CallMeRZIBI/Braille_typwriter_printer/maturity_exam/video_edit/print_result.jpeg

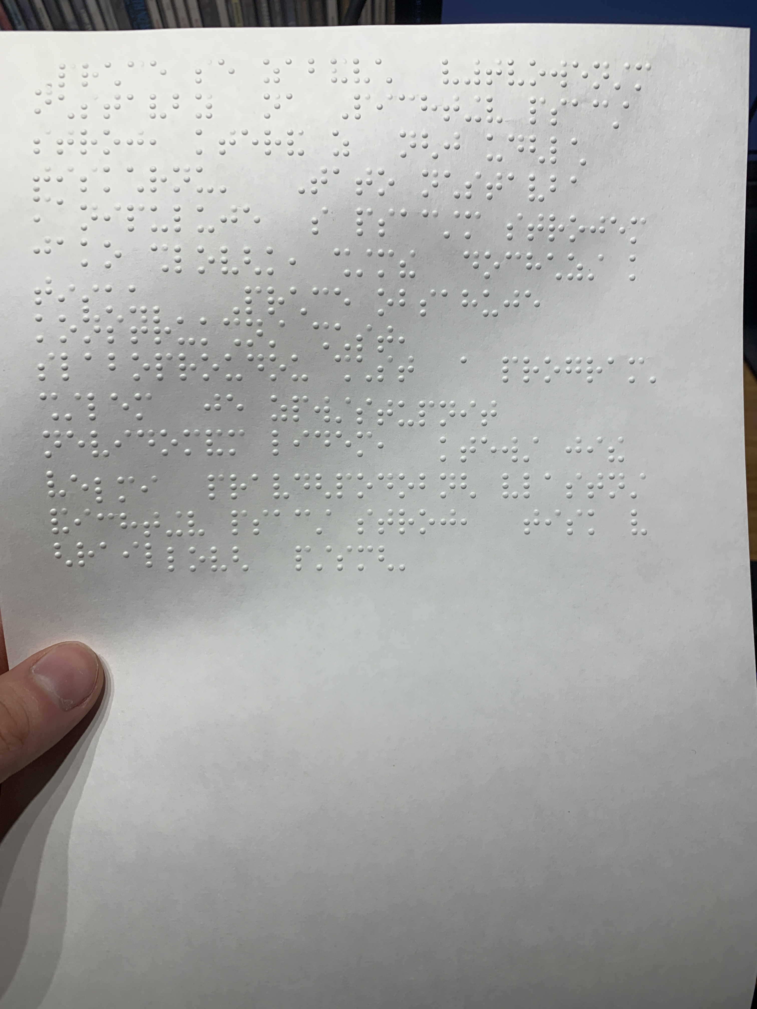
maturity_exam/video_edit/print_result.jpeg
