CallMeRZIBI/Braille_typwriter_printer/maturity_exam/navijak.jpg

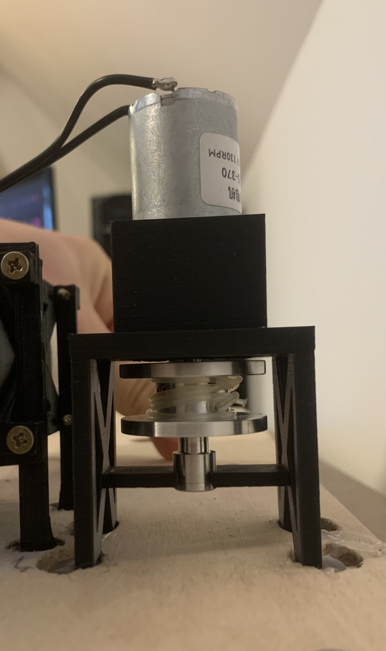
maturity_exam/navijak.jpg
