CallMeRZIBI/Braille_typwriter_printer/maturity_exam/MP2024-Michalenko-Jakub-E4C-Tiskárna_z_Braillova_psacího_stroje.pptx

## Tiskárna z Pichtova psacího stroje

Jakub Michalenko

## Obsah

- Proč jsem vytvořil tento projekt
- Popis krokového motoru
- Popis konstrukčního, hardwarového a softwarového řešení
- Poděkování

## Proč jsem tento projekt vytvořil?

- cenová nedostupnost Braillské tiskárny
- nevidomí lidé již vlastní Pichtův psací stroj
- nápad se zalíbil firmě NOVOTNÝ AUTOMATION s.r.o.
- nevidomý bratr

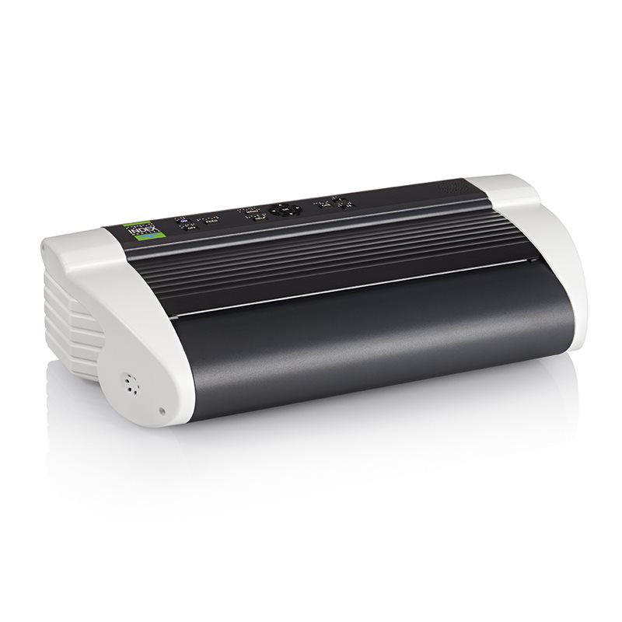
[picture p3: figure]
Basic-D V5 a light-weight embosser

INDEX Braille Basic-D V5 a light-weight embosser

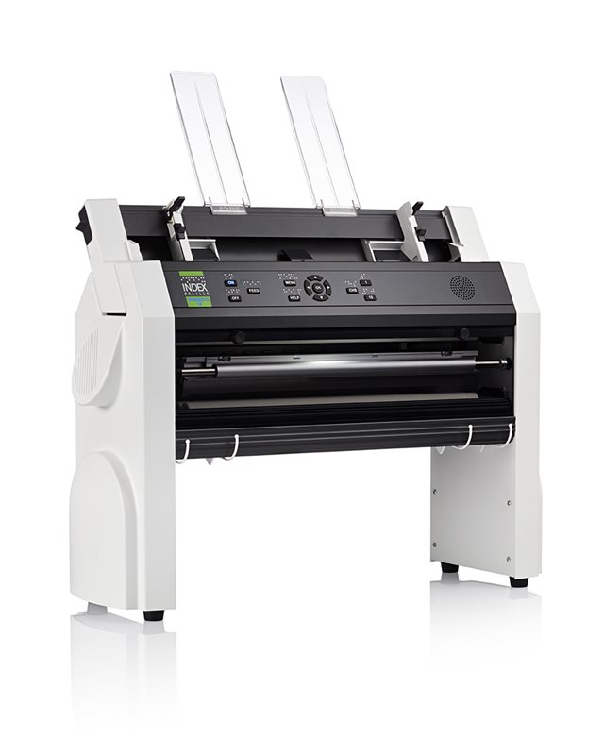
[picture p4: figure]
Everest-D V5: cut sheet-fed braille printer

INDEX Braille Everest-D V5: cut sheet-fed braille printer

## Popis krokového motoru

- elektrický motor otáčející se po krocích (stupních)
- přesné polohování
- 3D tiskárny, CNC, mikrovlnky, laserové projektory

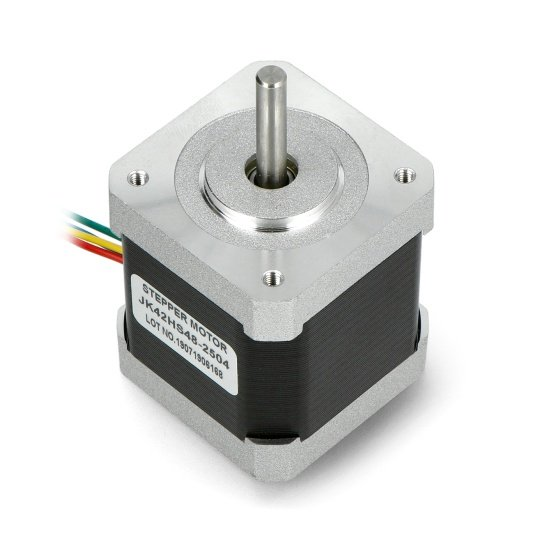
[picture p5: figure]
Krokový motor JK42HS48-2504 200 kroků / ot. 3,1 V Botland - obchod s robotikou

krokový motor Nema 17

## Popis krokového motoru (složení)

- složení: stator, dvě vinutí, rotor se zuby, permanentní magnet, …

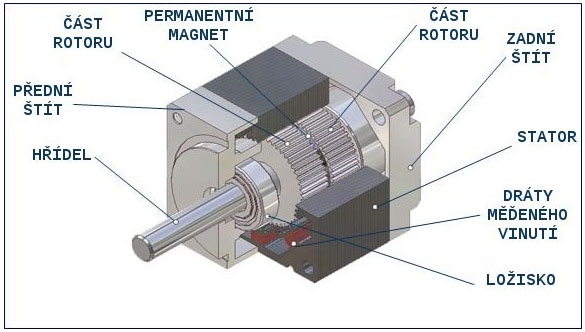
[picture p6: figure]
Krokový motor - co to je a jak funguje

složení krokového motoru

## Popis krokového motoru (princip)

- dvě vinutí jsou napájeny ssm U
- po převrácení napájecího U v jednom vinutí se rotor posune o 1 krok
- tímto opakováním se rotor postupně otáčí
- nutnost driveru
- přesné ovládání polohy

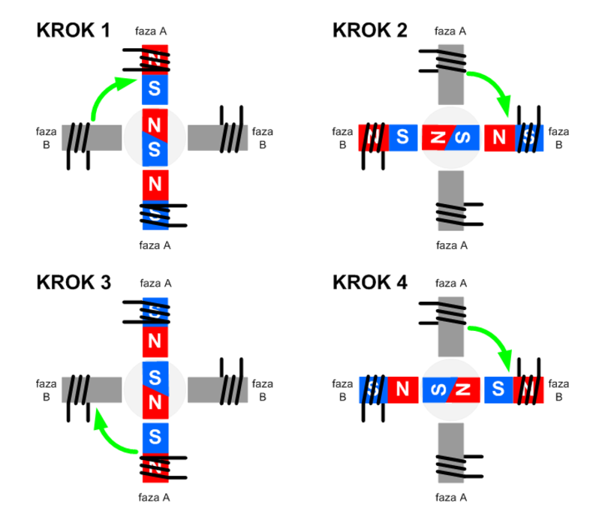
[picture p7: figure]
Krokový motor – druhy a příklady aplikací krokových motorů | Elektronické díly. Distributor a obchod online - Transfer Multisort Elektronik

princip činnosti krokového motoru

## Popis krokového motoru (driver)

- řídí krokový motor
- proudová ochrana, tepelná ochrana, energetická úspora
- více módů: full-step, half-step, microstep
- full-step: přepíná napájení vinutí
- half-step: střídá na vinutí kladné, žádné a záporné napájení
- microstep: řídí množství proudu odesílaného do jednotlivých vinutí, tím to je sofistikovanější

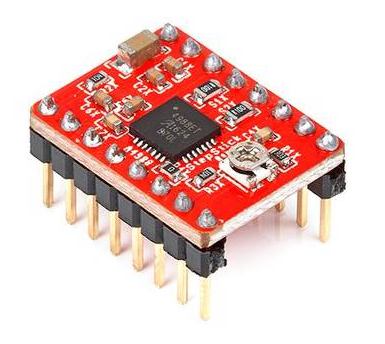
[picture p8: figure]
Motor driver A4988 Pro Reprap 3D Tiskárny - červený | dratek.cz

driver A4988
