CallMeRZIBI/Braille_typwriter_printer/maturity_exam/SOČ-2024-E4C-Michalenko-Jakub.pdf

## STŘEDOŠKOLSKÁ ODBORNÁ ČINNOST

Obor č. 10: Elektrotechnika, elektronika a telekomunikace

## Tiskárna z Pichtova psacího stroje

### Jakub Michalenko

Liberecký kraj | Liberec 2024

## STŘEDOŠKOLSKÁ ODBORNÁ ČINNOST

Obor č. 10: Elektrotechnika, elektronika a telekomunikace

## Tiskárna z Pichtova psacího stroje

## Printer from Picht's typewriter

### Autoři: Jakub Michalenko

Škola: Střední průmyslová škola a Vyšší odborná škola,

### Liberec, příspěvková organizace, Masarykova 3, 460 01 Liberec 1 Kraj: Liberecký kraj

Konzultant: Ing. David Krčmařík, Ph.D.

Město a vročení

Tiskárna z Pichtova psacího stroje

## Prohlášení

Prohlašuji, že jsem svou práci SOČ vypracoval/a samostatně a použil/a jsem pouze prameny a literaturu uvedené v seznamu bibliografických záznamů.
Prohlašuji, že tištěná verze a elektronická verze soutěžní práce SOČ jsou shodné. Nemám závažný důvod proti zpřístupňování této práce v souladu se zákonem č. 121/2000 Sb., o právu autorském, o právech souvisejících s právem autorským a o změně některých zákonů (autorský zákon) ve znění pozdějších předpisů.
V Liberci dne 15. 3. 2024 |
Jakub Michalenko

## Anotace

Práce se zabývá vytvořením nástavby na Pichtův psací stroj, který z něj udělá tiskárnu. Tato nástavba manipuluje s psacím strojem jako člověk, čímž dochází k tisku. Práce obsahuje konstrukční část, slaboproudou část a program. Cílem je zpřístupnit nevidomým lidem, kteří již velmi pravděpodobně vlastní Pichtův psací stroj, tisk v Braillově písmě.

## Summary

This work deals with making of addon for Picht’s typewriter, which transforms it to printer. This addon works with typewriter like a human, and by that it creates the print. This work contains construction part, weak-current part and a program. The objective is to make Braille printing more accessible to blind people, who by high chance already own Picht’s typewriter.

## Čestné prohlášení

Prohlašuji, že jsem předkládanou odbornou práci vypracoval sám a uvedl jsem veškerou použitou literaturu a bibliografické citace.

V Liberci dne 14.03.2024 | | Jakub Michalenko

## Obsah

A. Seznam přiložených souborů | I

## Úvod

Práce se zabývá nástavbou na Pichtův psací stroj, která ho promění v tiskárnu. K tomuto tématu jsem se dostal přes svého nevidomého bratra. Problémem Braillských tiskáren je jejich vysoká cena, tak jsem vytvořil tuto nástavbu, která je oproti Braillské tiskárně mnohem méně finančně nákladná. Nástavba je vytvořena pro Pichtův psací stroj Tatrapoint Adaptive, ale je možné ji použít i na dalších modelech Tatrapoint.
Teoretická část se zabývá braillským písmem a Pichtovým psacím strojem, mikrokontrolery a jejich architekturou, DC motory, krokovými motory a jejich ovládáním a push solenoidy.
Praktická část obsahuje konstrukční řešení mé nástavby, slaboproudou část a kód pro Arduino Uno a počítač, který to vše ovládá.
Když jsem se jednou o tomto nápadu bavil s ředitelem firmy NOVOTNÝ AUTOMATION s.r.o., tak se mě zeptal, zda bych nechtěl tento projekt vypracovat pro něj, a já tu nabídku přijal.

1 | Seznámení s Braillovým psacím strojem
| Braillův psací stroj neboli Pichtův psací stroj je mechanické zařízení pro zápis
Braillova písma na papír určený pro nevidomé.
1.1 | Historie Braillova psacího stroje
| První psací stroj pro nevidomé byl vynalezl v roce 1892 Frank Haven Hall, který
pracoval ve škole pro nevidomé v Illinois. Tento vynález nechránil patentem, jelikož na něm nechtěl vydělat. (1)
| V roce 1901 si zaregistroval svůj patent Oskar Picht, podle které se občas v česku
používá název „Pichtův psací stroj“. Oskar Picht je v Evropě často označován za prvního vynálezce psacího stroje pro nevidomé. (1)
1.2 | Konstrukce Pichtova psacího stroje
| Konstrukce Pichtova psacího stroje je podobná konstrukci klasického psacího
stroje. Skládá se z klávesnice, mechanické části na vytlačení důlků do papíru, válec na posouvání papíru na další řádek a posuvný vozík pro horizontální posun papíru. Oproti klasickému psacímu stroji ale klávesnice obsahuje pouze 7 kláves, 6 kláves tvoří šestibod Braillova písma, jejichž kombinací se píšou písmena a sedmá klávesa je mezerník.
| Horizontálně se posuvný vozík posouvá automaticky po úderu na jakoukoliv
klávesu, což zajišťuje buben se strunou, který obsahuje pružinu a automaticky se namotává. Pro návrat na předchozí znak obsahuje psací stroj ještě jedu páčku.
| Z těchto částí se ale operují pouze klávesnice, horizontální a vertikální posun
papíru. Tím pádem nemusím nijak operovat mechanismus na vytlačení důlků do papíru, jelikož to je přímo mechanicky propojené s klávesnicí.

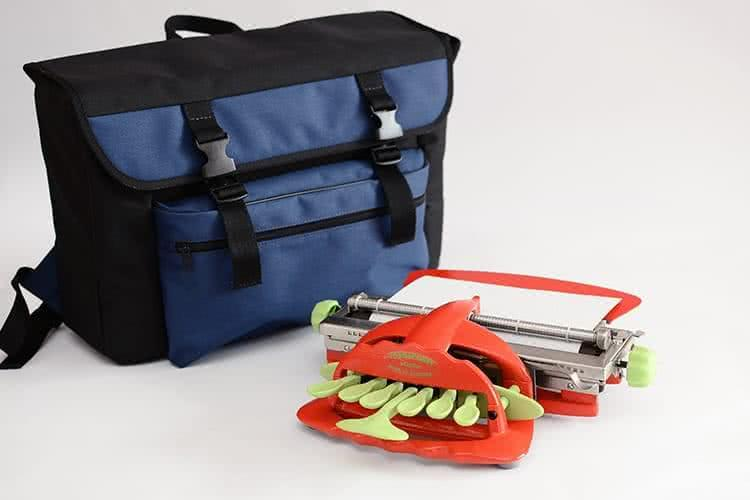
[picture p13: figure]

Obrázek 1 Pichtův psací stroj - Tatrapoint Adaptive

## 1.2.1 Části Pichtova psacího stroju operované nástavbou

1. klávesnice
2. vertikální posun papíru
3. horizontální posun papíru

2 | Braillovo písmo
| Braillovo písmo je speciální druh písma vytvořený pro nevidomé. Oproti ostatním
druhům písma se nejedná o písmo čitelné pomocí zraku, tudíž nic nenanáší barvu na papír, ale o vytlačené důlky do papíru, které člověk čte pomocí hmatu.
| Písmo je pojmenováno podle francouzského učitele Louise Brailla, který v dětství
přišel o zrak. Písmo vytvořil v patnácti letech úpravou francouzského vojenského systému umožňujícího čtení za tmy. (2)

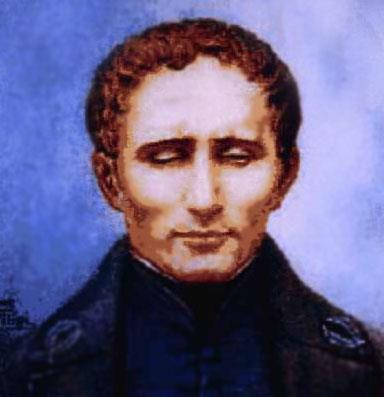
[picture p14: figure]

Obrázek 2 Louis Braille (3)
2.1 | Stavba písma
| Braillovo písmo je tvořeno šesti body ve dvou sloupcích po třech. Na jednotlivé
body se odkazuje čísly od 1 do 6, kde 1 je v levém horním rohu písmena a přičítá se ve sloupci směrem dolů do 3, v pravém horním rohu je 4 a přičítá se zase směrem dolů do 6.

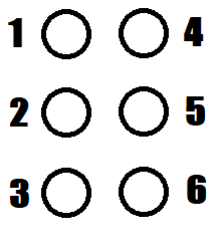
[picture p15: figure]

Obrázek 3 číslování Braillova písma

Písmeno se skládá z kombinace důlků a vynechaných bodů, tím pádem je možné s mezerou zakódovat 64 znaků (6²). Těchto 64 znaků pokrývá celou abecedu a některé speciální znaky jako interpunkce. Čísla se píšou jako prvních 10 znaků abecedy předznamenaných speciálním znakem, to samé platí pro velká písmena, která jsou předznamenána pouze bodem 6. Každý jazyk má vlastní zakódování abecedy.

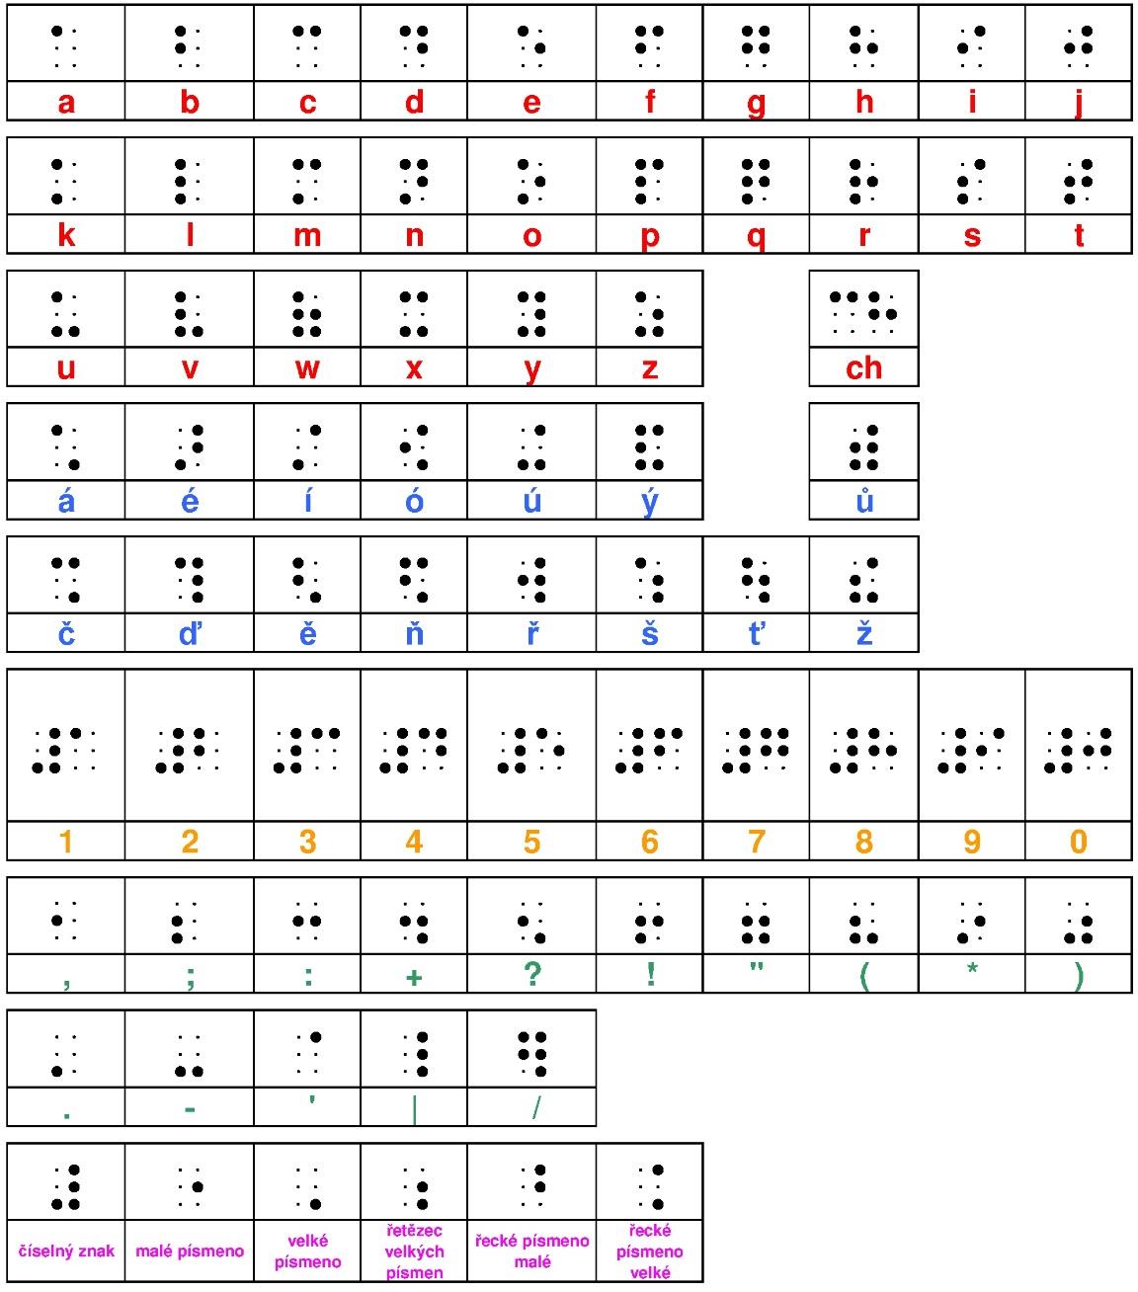
[picture p16: figure]

Obrázek 4 česká Braillská abeceda (4)

3 | DC motor
| Stejnosměrný (DC) motor je v elektrotechnice točivý elektrický stroj na
stejnosměrný proud, s vnitřní komutací cívek v rotoru. Může pracovat v režimu elektromotor nebo generátor (dynamo). Princip stejnosměrného motoru objevil v roce 1873 Zénobe Gramme. Stejnosměrné motory se dělí do více skupin, na kartáčové a bezkartáčové a dále podle typu buzení, na motory s cizím buzením, motory se sériovým buzením a derivační motory. (5)
| Malé stejnosměrné motory jsou používány v hračkách a pohonech spotřebičů.
Díky jejich rozšíření jsou cenově velmi přístupné, je jich velké množství a dělají se ve všech možných rozměrech a s různými parametry. Díky tomu jsou velmi používané nejen v profesionálních strojích ale využívají je i kutilové. Někdy se prodávají s přimontovanou převodovkou pro dosažení větších otáček nebo většího kroutícího momentu.
3.1 | Stavba stejnosměrného motoru
| Stejnosměrný motor má čtyři hlavní díly, společný magnetický obvod statoru a
rotoru, buzení magnetického toku statoru, komutátor s kartáči a rotor. Napájení rotoru je realizováno přes sběrací kartáče na komutátoru, který přepíná vinutí rotoru. Na statoru je budicí vinutí, které vytváří magnetický tok. Budicí vinutí je nahrazováno u nových konstrukcí permanentním magnetem. Změnou velikosti budicího proudu nebo napájecího napětí kotvy je možno řídit rychlosti otáčení (ot/min). Změnou směru jen budicího proudu nebo jen napětím kotvy docílíme změnu směru otáčení kotvy. (5)

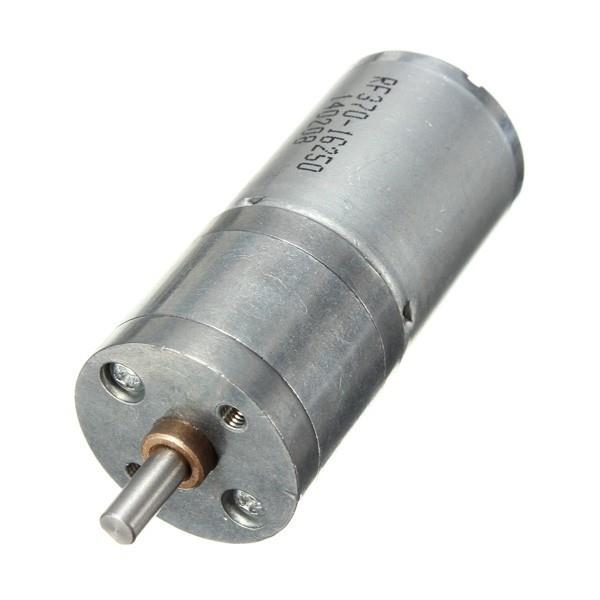
[picture p17: figure]

Obrázek 5 příklad DC motoru s převodovkou na kroutící moment (6)

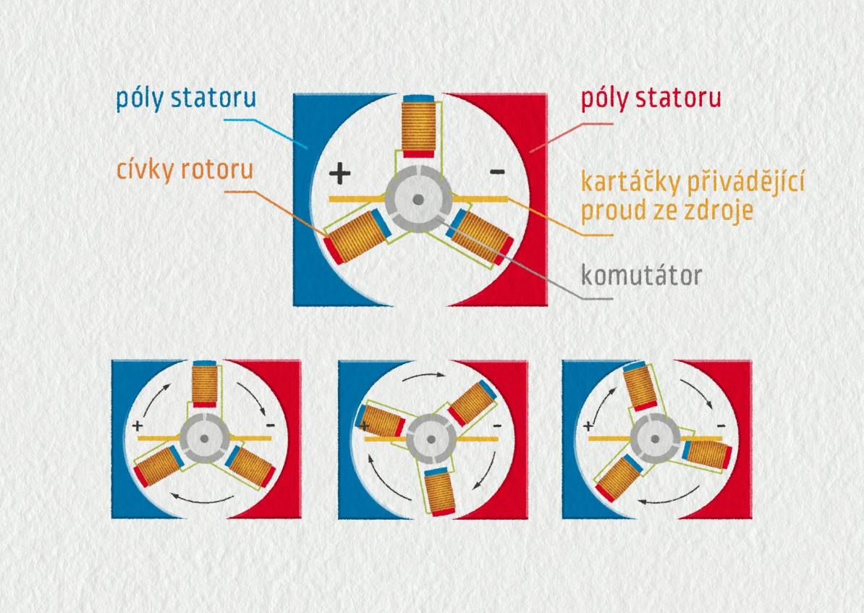
[picture p18: figure]

Obrázek 6 stavba stejnosměrného motoru (7)
3.2 | Princip činnosti stejnosměrného motoru
| Stejnosměrný motor se skládá z rotoru (upevněn na hřídeli) a statoru (pevná část
elektromotoru). Rotor je vždy elektromagnet, stator může být buď elektromagnet nebo permanentní magnet. Kotvou je označován elektromagnet, na kterém dochází k přepólování napájení jeho vinutí (buď pomocí komutátoru nebo řídícím elektronickým obvodem). Kotva může být na statoru i na rotoru (podle konstrukce motoru). (5)
| Magnetický tok budicího vinutí a kotvy na sebe silově působí. Stejné póly se
odpuzují a opačné přitahují. Tím vzniká točivý moment. Pokud by při pootočení nedošlo k přepnutí vinutí kotvy (komutaci), došlo by k zastavení. Vektory spřaženého magnetického toku by nevyvozovaly vzájemné silové účinky (magnetická pole by byla orientována ve stejném směru). Pro zachování dosavadního směru otáčení je kotva přepólována tak, aby se rotor snažil pootočit směrem do další neutrální polohy, ale mezi tím dojde opět k další komutaci části vinutí kotvy. Pro plynulejší pohyb má kotva tři a více vinutí. Změnu směru otáčení motoru je možno uskutečnit reverzací (přepólováním) jen kotvy, nebo jen buzení. Pro rychlou reverzaci motoru je obvykle reverzována kotva, která má mnohem menší časovou konstantu než budicí obvod. (5)
| Protékající proud v součinnosti s magnetickým polem vytváří sílu podle vztahu
F = B ∗ I ∗ l, která otáčí rotorem.

3.3 | Typy stejnosměrných motorů
| Základní typy DC elektromotorů jsou kartáčové a bezkartáčové DC
elektromotory, dále se dělí podle způsobu buzení.

## 3.3.1 Kartáčový stejnosměrný elektromotor

| Kartáčový motor má na hřídeli rotor a zároveň kotvu, v jejichž drážkách je
vloženo vinutí rotoru připojené na komutátor. Komutátor je soustava vzájemně elektricky oddělených vodivých kovových lamel upevněných na hřídeli rotoru. Na komutátor přiléhají uhlíky (kartáče), kterými je přiveden do rotoru elektrický proud. Komutátor s uhlíky zajišťují přepínání částí vinutí rotoru. Během provozu dochází k opotřebovávání uhlíků otěrem o lamely a jiskřením při přepínání napájení pro jednotlivé části vinutí. Komutátor je nejporuchovější součástí stejnosměrného kartáčového motoru a vyžaduje pravidelnou údržbu. (5)
| Stator kartáčového motoru obsahuje budicí obvod, který je tvořen
permanentními magnety nebo cívkami budicího vinutí. (5)
| Vektor magnetického toku buzení (statoru) je pootočen o 90° vůči vektoru
magnetického toku kotvy. Oba magnetické toky jsou spřaženy ve společném magnetickém obvodu. Tím dochází k silovému působení mezi magnetickými toky cívek a vzájemným silovým působením vzniká kroutící moment. (https://cs.wikipedia.org/wiki/To%C4%8Div%C3%BD_moment) (5)
| Změna rychlosti otáčení a kroutícího momentu je prováděna změnou velikosti
přivedeného elektrického napětí na kotvu a změnou budicího proudu. (5)

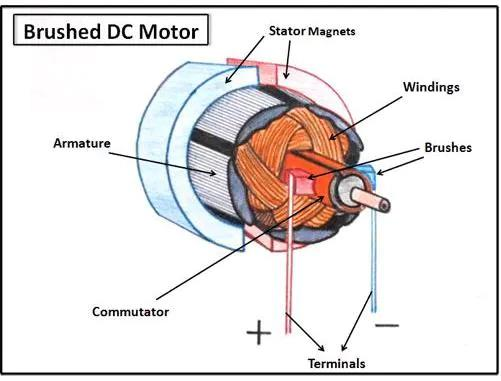
[picture p19: figure]

Obrázek 7 stavba kartáčového stejnosměrného motoru (8)

## 3.3.2 Bezkartáčový stejnosměrný elektromotor

Bezkartáčový motor má rotor tvořen permanentními magnety. Vinutí cívek statoru je zapínáno řídicí elektronikou tak, aby byl neustále vyvoláván točivý moment na rotoru. Řídící jednotka musí sledovat pozici rotoru, například pomocí Hallových sond, aby správně přepojovala vinutí statoru. Změna otáček je prováděna změnou frekvence přepínání cívek ve statoru. Řídicí jednotka může regulovat napětí a proud do cívek statoru, čímž může ovlivňovat krouticí moment. Tím, že není použit komutátor, je bezkartáčový motor nenáročný na údržbu. Jsou označovány někdy jako BLDC. Příkladem bezkartáčového motoru je motor ventilátoru chlazení PC. (5)

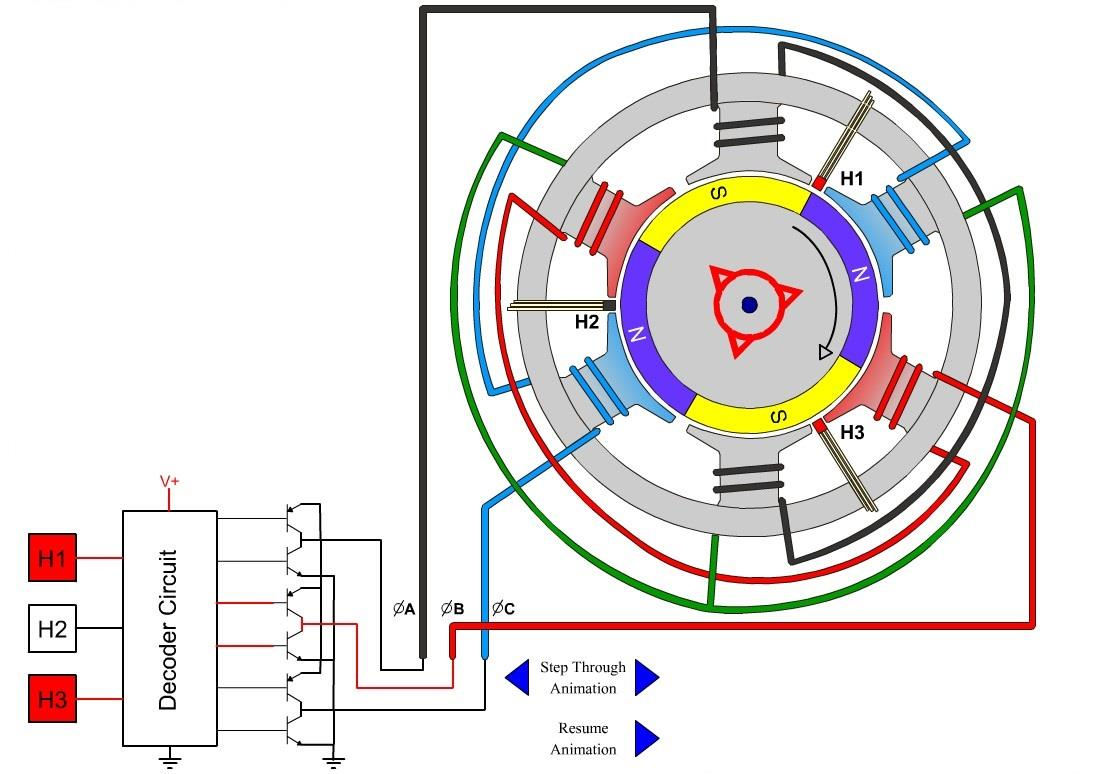
[picture p20: figure]

Obrázek 8 diagram BLDC motoru s ovládáním (9)
3.4 | Buzení stejnosměrných motorů
| První komutátorové motory měly výhradně statorové budicí vinutí. U nových
konstrukcí bývá nahrazováno permanentním magnetem. Odbuzením (snížením budicího proudu) vinutí statoru umožňuje u komutátorového motoru zvýšení rychlosti otáčení. Současně klesá krouticí moment. (5)
| Komutátorové motory používají čtyři typy elektrického propojení buzení a kotvy:
sériové, derivační (paralelní), kompaundní (kombinace obou) a cizí buzení. Každý má jinou charakteristiku točivého momentu vůči otáčkám motoru pro různé zátěže. (5)

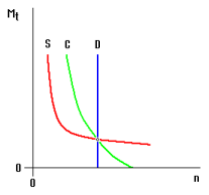
[picture p21: figure]

Obrázek 9 Charakteristiky buzení stejnosměrných motorů (5)

Na zobrazeném grafu jsou zobrazeny idealizované momentové charakteristiky motorů v závislosti na otáčkách [S] - sériový, [D] - derivační, [C] - kompaundní. Grafy platí jen v pracovní oblasti motorů. (5)

## 3.4.1 Cizí buzení

Cize buzený motor má kotvu (rotor) i statorové buzení napájeny z různých nezávislých zdrojů, které mohou být řiditelné. Pro zavedení elektrodynamické brzdy stačí jednoduché zapojení obvodů. Tento motor nepotřebuje zeslabování budicího vinutí (buzení má vlastní regulaci). Využíval se po rozvoji výkonové elektroniky (pulzní měniče). (5)

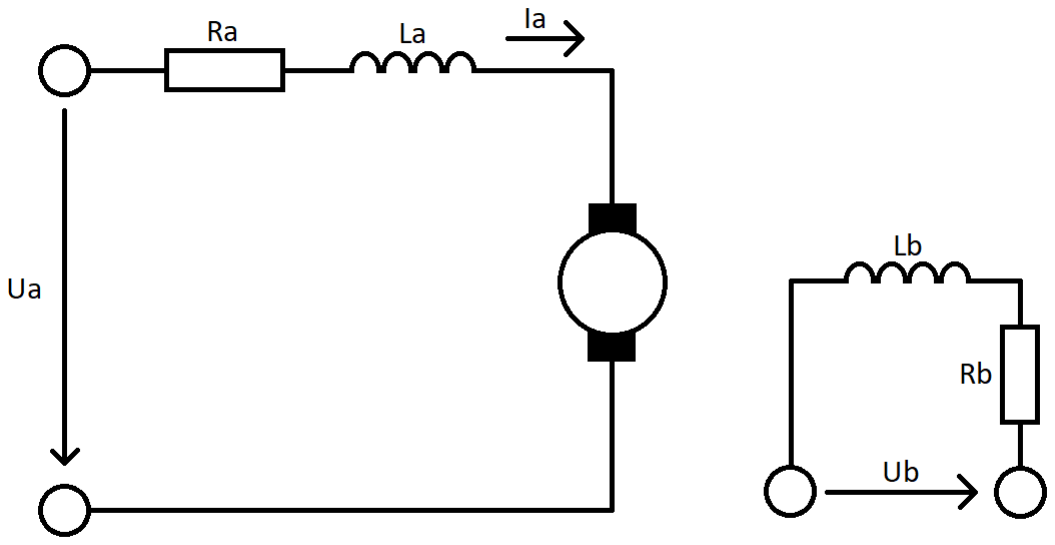
[picture p22: figure]

Obrázek 10 zapojení stejnosměrného motoru s cizím buzením

## 3.4.2 Sériové buzení

Statorové budicí vinutí je spojeno do série s vinutím rotoru. Dopravní prostředky závislé i nezávislé trakce (vlaky, metro, tramvaje, ...) vyžadují pohon motory s velký záběrovým momentem. Tomu nejlépe vyhovoval motor se sériovým buzením. Mluvíme o sériovém elektromotoru. Točivý moment motoru je nepřímo úměrný otáčkám. Při nulových otáčkách dosahuje motor maximálních hodnot kroutícího momentu. (5) Motory se sériovým buzením nemají omezení rychlosti otáčení. Při běhu naprázdno se motor může roztočit do vysokých otáček, kdy hrozí mechanické roztržení rotoru s možným zraněním obsluhy. (5)

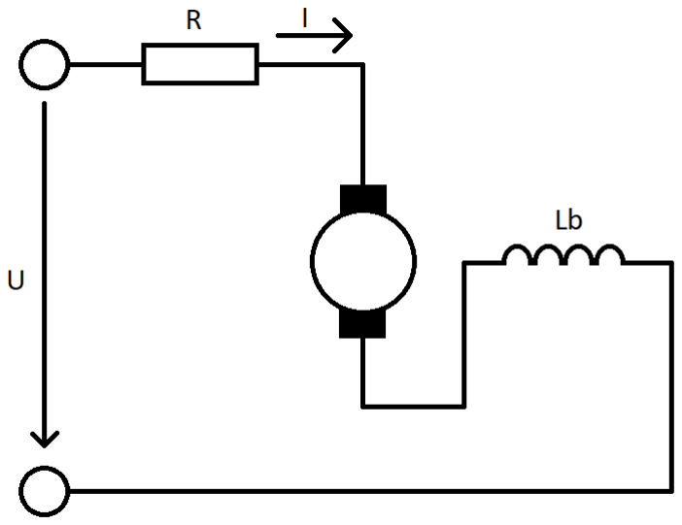
[picture p23: figure]

Obrázek 11 zapojení stejnosměrného motoru se sériovým buzením

## 3.4.3 Derivační zapojení buzení

Derivační motor je komutátorový motor, jehož budicí vinutí i kotva je napájeno ze společného zdroje (zapojeno paralelně). Jedná se v podstatě o obdobu cize buzeného motoru. Otáčky v motoru v pracovní oblasti jsou málo závislé na zátěži motoru. Derivační motor je využíván u poháněných zařízení s požadavkem malých změn otáček. Proud statoru i buzení je možno samostatně regulovat. Derivační motor přechází samočinně z motorického režimu do režimu generátoru a zpět v závislosti na mechanické charakteristice poháněného zařízení. (5)
Derivační motor se může při přerušení budicího obvodu přetočit, hrozí mechanické poškození rotoru, až zranění obsluhy. (5)

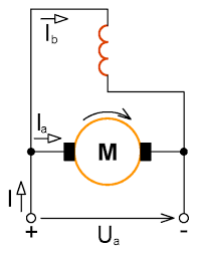
[picture p24: figure]

Obrázek 12 zapojení derivačního motoru (10)

Motor je možno jen odbuzovat a omezovat proud kotvy. Momentová charakteristika je velmi podobná jako u motoru s cizím buzením. Spouštění motoru: před zapnutím motoru musí být nastaven maximální budicí proud, tedy zkratován rezistor Rb a zařazen celý odpor rezistoru RS. (5)

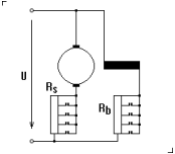
[picture p25: figure]

Obrázek 13 zapojení derivačního motoru 2 (5)

## 3.4.4 Kompaundní zapojení buzení

Kompaundní motor neboli elektromotor se smíšeným buzením má sériové i paralelní budicí vinutí, jejichž magnetické toky působí buď souhlasně, nebo proti sobě. Podle toho, která část budicího vinutí (sériová nebo derivační) má převládající vliv na budicí tok, se mění pracovní charakteristiky kompaundního motoru. Výstupní charakteristiky jsou kompromisem derivačního a sériového motoru. Působí-li obě vinutí stejným směrem, má motor větší záběrný moment než motor s paralelním buzením a otáčky se nesnižují tolik, jako u motoru se sériovým buzením. Působí-li sériové vinutí proti paralelnímu, udržuje motor otáčky při proměnném zatížení. Zvětší-li se zatížení, otáčky klesnou, sériovým vinutím prochází větší proud, buzení se zeslabí a otáčky se opět zvýší. (5)
Spouštění motoru: Před zapnutím motoru musí být nastaven maximální budicí proud, tedy zkratován rezistor Rb a zařazen celý odpor rezistoru Rs. Po vyřazení odporu v obvodu kotvy se snižuje buzení odporem v obvodu buzení. (5)

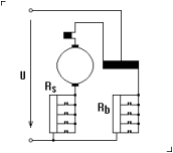
[picture p26: figure]

Obrázek 14 zapojení kompaundního motoru (5)

4 | Krokový motor
| Krokový motor je elektrický motor, který se oproti ostatním elektrickým
motorům otáčí po krocích. Každý krok je stejně velký, a tak se jedná o rotaci po stupních.
| Využívá se díky jeho principu tam, kde je potřeba vysoká přesnost motoru, to jsou
např.: 3D tiskárny, CNC stroje.

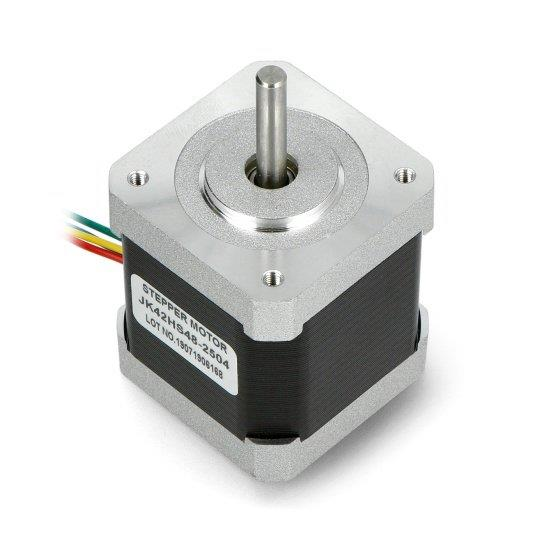
[picture p27: figure]

Obrázek 15 krokový motor (11)
4.1 | Princip činnosti krokového motoru
| Krokové motory se skládají ze dvou vinutí, které jsou napájeny stejnosměrným
proudem. Když je proud v jednom vinutí obrácen, hřídel rotoru se posune o jeden krok. Převrácením proudu v každém vinutí je poloha a rychlost motoru snadno a přesně řízena. (12)

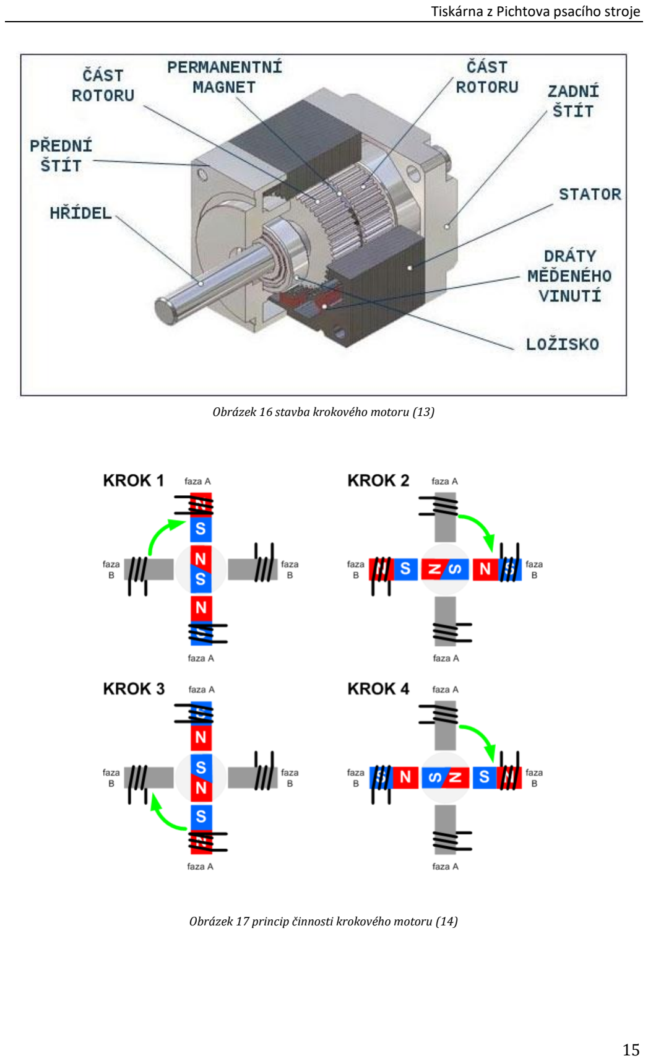
[picture p28: page 23]

Obrázek 16 stavba krokového motoru (13)

Obrázek 17 princip činnosti krokového motoru (14)

4.2 | Parametry krokového motoru
| Krokové motory se vybírají podle jejich přídržného krouticího momentu a
odpovídajícího jmenovitého proudu a napětí. Přídržný moment určuje maximální externí krouticí moment aplikovaný na motor (napájený jmenovitým proudem) ve statické poloze bez otáčení. V okamžiku, kdy se motor začne otáčet, se dostupný točivý moment často označuje jako moment zvratu, který udává mezní hodnotu momentu při stabilním a konstantním chodu motoru bez ztráty kroku. Velikost momentu zvratu je reprezentována hodnotami vynesenými na křivkách krouticího momentu v závislosti na otáčkách motoru. (12)
| Úhel kroku je další parametr. Nejčastěji je to 1,8° na krok, jelikož konstrukce

motoru má 200 zubů. Počet kroků se vypočítá takto: n =

360
α

kde je n – počet kroků, α –

úhel kroku. (12)
4.3 | Řízení krokového motoru
| Krokové motory se řídí pomocí řídicích jednotek, které přepínají vinutí
krokového motoru. Jsou k dispozici v široké škále napětí a proudů. Výkon motoru velmi závisí na proudu a napětí dodávaném řídicí jednotkou. Řídicí jednotka může operovat krokový motor ve třech režimech, a to full-step, half-step a microstep. (12)
| Full-step se provede vždy, když se přepne napájené vinutí. (12) Half-step se docílí spínací technikou, která střídavě aplikuje kladný, žádný a

záporný proud na každé vinutí v patřičném sledu. (12)
| Microstep je sofistikovanější forma řízení, která je nad rámec jednoduchého
přepínání výkonu mezi vinutími fází a řídí množství proudu odesílaného do jednotlivých vinutí. Hlavní výhodou mikrokrokování je snížení amplitudy rezonance, ke které dochází, když motor pracuje na své vlastní frekvenci. Mikrokrokování umožňuje umístění hřídele na jiných místech než v místech poskytovaných full-step režimem a half-step režimem. (12)

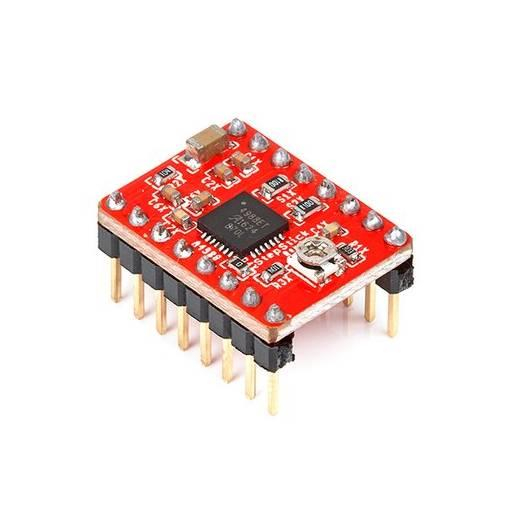
[picture p29: figure]

Obrázek 18 řídicí jednotka A4988 pro krokové motory (15)

5 | Lineární Solenoidy
| lineární solenoidy jsou lineární elektrické stroje, nejčastěji používané tam, kde je
potřeba velké rychlosti pohybu malé váhy po krátké až středně dlouhé dráze. Jsou často používané díky jejich jednoduchosti, spolehlivosti a velikosti. Jedná se o elektromagnet s pohyblivým jádrem.
5.1 | Konstrukce Lineárních Solenoidů
| Konstrukce je velice jednoduchá, jelikož se jedná o cívku v pouzdře, s pohyblivým
jádrem uprostřed. Jádro je podle potřeby opatřeno návratnou pružinou. Není tomu tak v aplikacích kde ovládaná část sama vrátí jádro, nebo pokud jádro přitáhne gravitace nebo jiná síla.

## 5.2 Druhy lineárních solenoidů

1. Push Pull Solenoidy
1. Tubulární Solenoidy
2. Open Frame Solenoidy
2. Proporcionální Solenoidy
3. Super Stroke Solenoidy
4. Latching Solenoidy

## 5.2.1 Push Pull Solenoidy

| Push pull solenoid se dá díky jeho jednoduché konstrukci použít buď jako push
solenoid, nebo jako pull solenoid, nebo obojí. Záleží pouze na orientaci instalace.
| Navzdory tomu, že by se daly solenoidy používat zároveň jako push i jako pull,
tak se často vyrábí s jádrem přizpůsobeným pouze k jednomu druhu pohybu.

5.2.1.1 Tubulární Solenoidy

| Tubulární solenoidy jsou prakticky pouze push pull solenoidy s pouzdrem tvaru
válce.

5.2.1.2 Open Frame Solenoidy

| Open frame solenoidy jsou taktéž push pull solenoidy, ale jejich pouzdro je z dvou
stran otevřený kvádr, tudíž cívka je izolovaná.

## 5.2.2 Proporcionální Solenoidy

Proporcionální solenoidy jsou lineární solenoidy, jejichž síla je úměrná proudu. S přidáním pružiny se může proporcionální solenoid používat jako polohovací zařízení, kde je poloha úměrná proudu. (16)

## 5.2.3 Super Stroke Solenoidy

Super stroke solenoidy jsou tubulární solenoidy, které mají větší délku zdvihu. Dají se zároveň používat jako proporcionální solenoidy. (17)

## 5.2.4 Latching Solenoidy

Latching Solenoidy jsou solenoidy, u kterých k držení jádra v aktivní poloze není třeba napájení. K dosažení aktivní polohy stačí velmi krátký pulz, tím pádem jsou energeticky úspornější. K návratu je třeba také pulz opačné polarity. (18)
Hodí se do aplikací, kde je požadavek solenoidu, aby byl sepnutý po delší dobu, což u klasického lineárního solenoidu není možné, jelikož by se začal velmi rychle přehřívat. (18)

5.2.4.1 Princip Latching Solenoidu

Latching solenoid obsahuje oproti klasickému lineárnímu solenoidu také permanentní magnet vedle cívky. Ten drží pohyblivé jádro na místě, dokud se nepřipojí napájení cívky, která buď přitáhne jádro, nebo vynuluje magnetické působení permanentního magnetu a vnější jev vrátí jádro do původní polohy. To je možné zase buď pružinou anebo samotnou aplikací.
Na obr. 19 je vidět vlevo latching solenoid ve vysunuté poloze a vpravo v zasunuté.
A - pohyblivé jádro
B - pouzdro solenoidu
C - hřídel připevněná na pohyblivé jádro D - uzavření pouzdra solenoidu
E – cívka
F - permanentní magnet.

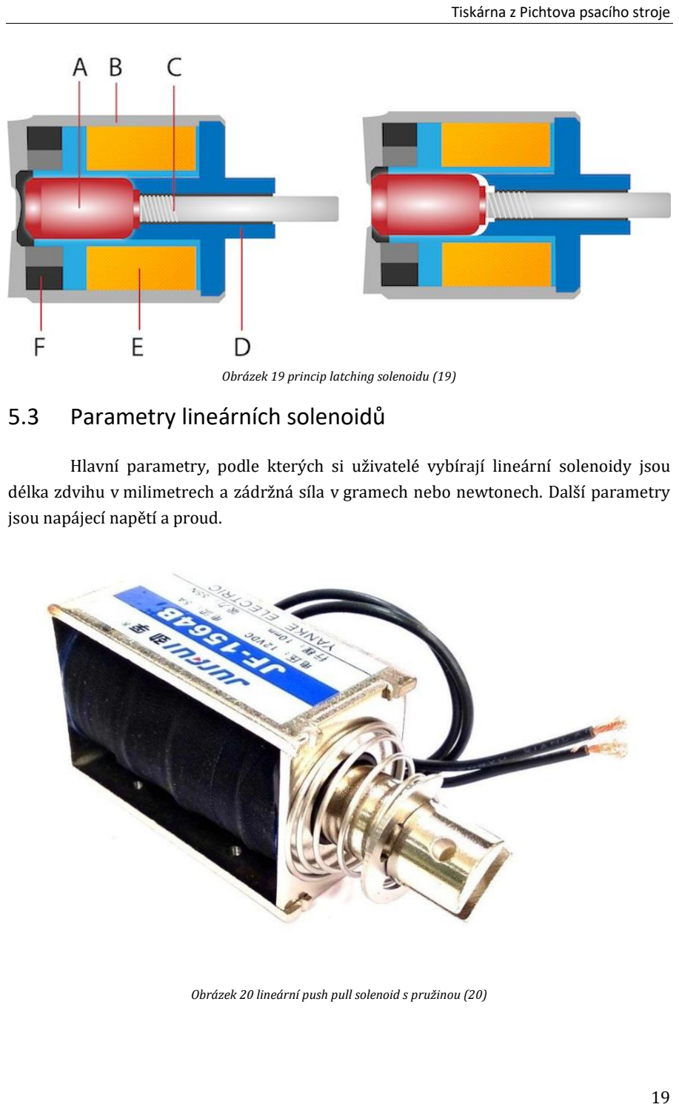
[picture p30: page 27]

Obrázek 19 princip latching solenoidu (19)
5.3 | Parametry lineárních solenoidů
| Hlavní parametry, podle kterých si uživatelé vybírají lineární solenoidy jsou
délka zdvihu v milimetrech a zádržná síla v gramech nebo newtonech. Další parametry jsou napájecí napětí a proud.

Obrázek 20 lineární push pull solenoid s pružinou (20)

6 | Mikrokontroléry
| Mikrokontroléry neboli MCU, jsou též označované jako jendočipové počítače,
obsahují v jediném pouzdře všechny podstatné části mikropočítače. Vyznačují se velkou spolehlivostí a kompaktností, proto jsou určeny především pro jednoúčelové aplikace jako je řízení, regulace apod. Často jsou jednočipové počítače součástí vestavěných (embedded) systémů. (21)

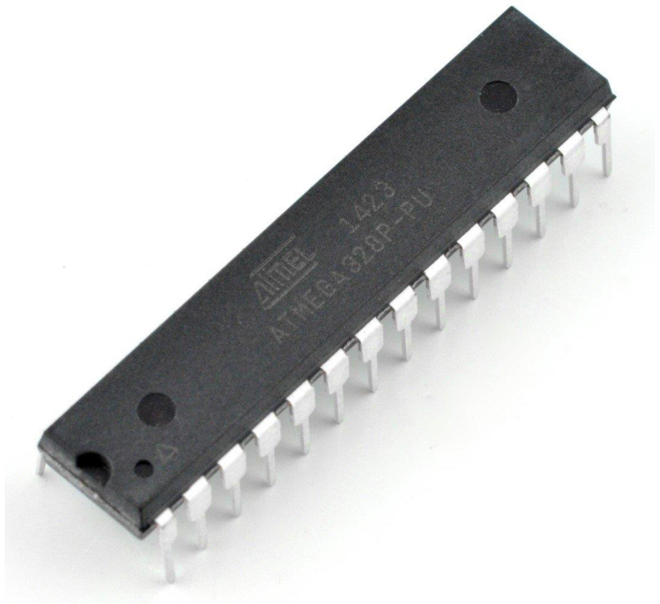
[picture p31: figure]

Obrázek 21 Atmel ATMEGA328P-PU (22)

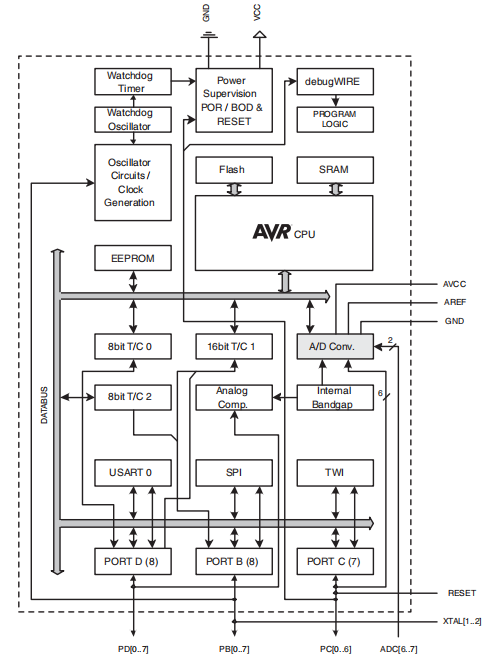
[picture p32: figure]

Obrázek 22 blokové schéma jednočipu Atmel ATMEGA328P-PU (23)
6.1 | Stavba MCU
| Jednočipový počítač je integrovaný obvod, který v sobě zahrnuje zpravidla vše
potřebné k tomu, aby mohl obsáhnout celou aplikaci, aniž by potřeboval další podpůrné obvody. Především jde o paměť pro uložení programu typu FLASH, EEPROM nebo ROM a operační paměť RAM pro průběžné ukládání proměnných dat aplikace a zásobníku. Většina jednočipových počítačů také obsahuje rozsáhlou sadu podpůrných obvodů, pak se jedná o MCU. Typicky jde o bloky pro logické a analogové vstupy/výstupy, pro komunikační linky, pro rozdělení strojového času a další aplikační logiku. (21)

6.2 | Architektura MCU
| Existují základní dvě architektury mikroprocesorů:
1. von Neumannova
2. Harvardská
| Každá má svoje výhody i nevýhody. Při současném stupni integrace se zřejmě
častěji využívá Harvardská architektura, vysoký stupeň integrace dovoluje připojit různé bloky paměti pomocí vlastních sběrnic. Dělení na Harvardskou a von Neumannovu architekturu je však při dnešním stupni integrace již poněkud akademické. U moderních architektur se často uživateli adresový prostor jeví navenek jako lineární (von Neumannovský), zatímco fyzicky jsou paměti k jádru připojeny pomocí několika nezávislých sběrnic (např. jedna sběrnice pro FLASH/ROM, druhá pro uživatelskou vnitřní RAM a zásobník, třetí pro připojení integrovaných paměťově mapovaných periferií, další pro připojení externí RAM). (21)

## 6.2.1 Von Neumannova architektura

| Von Neumannova architektura popisuje počítač se společnou pamětí pro
instrukce i data. To znamená, že zpracování je sekvenční oproti například Harvardské architektuře. (24)
| Procesor počítače se skládá z řídící a výkonné (aritmeticko-logické) jednotky.
Řídící jednotka zpracovává jednotlivé instrukce uložené v paměti, přičemž jejich vlastní provádění nad daty má na starosti aritmeticko-logická jednotka. Vstup a výstup dat zajišťují vstupní a výstupní jednotky. (24)
| Rychlost zpracování instrukcí dnešními procesory je výrazně vyšší než rychlost
komunikace s pamětí. Komunikace s pamětí se tak stává nejslabším článkem řetězu ve von Neumannově architektuře. Tuto nevýhodu částečně řeší tzv. paměťové cache, což jsou rychlé mezipaměti, do kterých se potřebná data a instrukce z pomalejší hlavní paměti načítají dříve, než jsou při zpracování potřeba. (24)

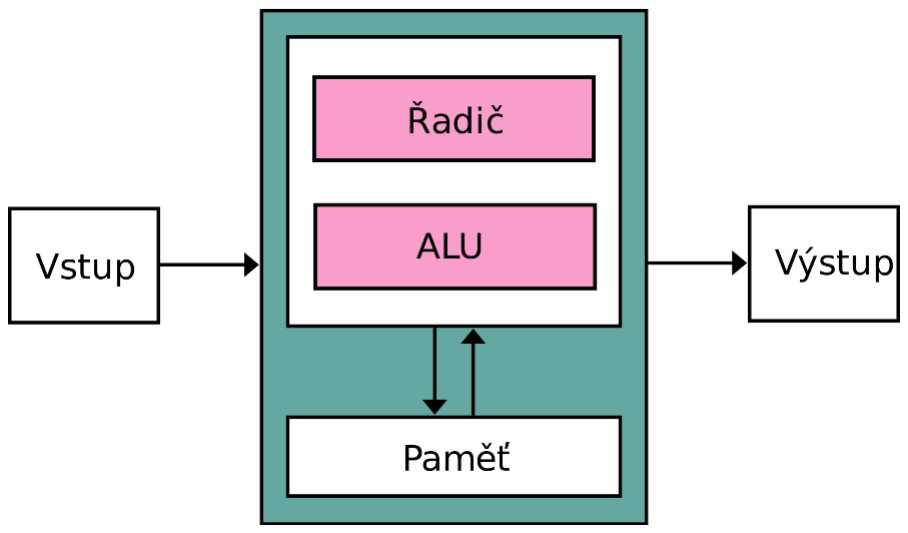
[picture p33: figure]

Obrázek 23 schéma von Neumannovy architektury (24)

## 6.2.2 Harvardská architektura

U Harvardské architektury není potřeba mít paměť stejných parametrů a vlastností pro data a pro program. Paměti mohou být naprosto odlišné, mohou mít různou délku slova, časování, technologii a způsob adresování. V některých systémech se pro paměť programu používá typ paměti ROM, přičemž paměť dat vyžaduje typ paměti RWM. (25)
Dvojí paměť umožňuje paralelní přístup oběma pamětím, což zvyšuje rychlost zpracování. Umístění programu v paměti ROM může významně přispět k bezpečnosti systému (program nelze modifikovat). (25)

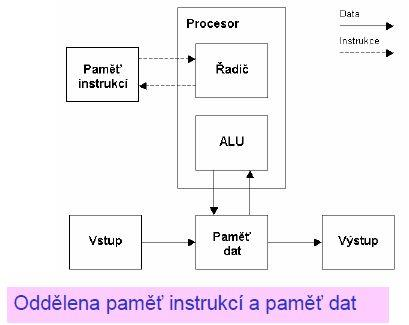
[picture p34: figure]

Obrázek 24 schéma Harvardské architektury (26)
6.3 | Instrukční sety mikrokontrolérů
| Nejen MCU ale obecně dnešní CPU využívají dva základní druhy instrukčních setů.
Tím jsou CISC a RISC. Další alternativy jsou ku příkladu VLIW a EPIC, které vznikly vývojem z RISC. (27)

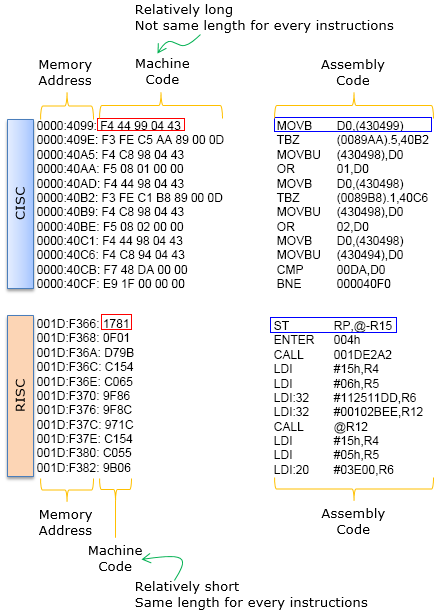
[picture p35: figure]

Obrázek 25 porovnání rozdílů RISC a CISC instrukcí (28)

## 6.3.1 CISC

CISC označuje v informatice skupinu procesorů vyznačující se podobným návrhem sady strojových instrukcí. Označení complex vyjadřuje skutečnost, že strojové instrukce pokrývají velmi široký okruh funkcí, která by jinak šla naprogramovat pomocí jednodušších již obsažených strojových instrukcí (např. násobení je možné nahradit sčítáním a bitovými posuny). (29)

6.3.1.1 Charakteristika CISC

Procesory CISC jsou charakteristické velmi rozšířenou instrukční sadou strojových instrukcí, instrukce mají proměnlivou délku i dobu vykonání a procesor obsahuje relativně nízký počet registrů. Paradoxně se tak může stát, že operace provedená složenou instrukcí, např. již zmiňované násobení, může být ve výsledku vykonáno rychleji sledem jednodušších instrukcí než hardwarově implementovaná složená varianta. (29)
Označení CISC bylo zavedeno jako protiklad až poté, co se prosadily procesory RISC, které mají instrukční sadu naopak redukovanou. (29)

6.3.1.2 Design

Některé návrhy se vyznačují vysokou programovou propustností, nízkou cenou a také tím, že umožňují vyjádření vysokoúrovňových instrukcí menším počtem instrukcí – tento přístup není však vždy vhodný. (29)
I ve vyvážených high-performance návrzích s vysokoúrovňovými instrukcemi je komplikované dekódování a efektivní vykonávání v omezeném souboru tranzistorů. Takové architektury tedy vyžadují velké množství práce v návrhu procesoru zejména v případě, že nejde užít jednodušší, ale také typicky pomalejší řešení založené na dekódovací tabulce, nebo mikrokódu. (29)
CISC se již často implementuje s tzv. superskalárním programovacím modelem, kde je procesor schopný vykonat více instrukcí v jednom taktu, jelikož ku příkladu obsahuje dvě FPU jednotky. (29)

6.3.1.3 CISC s mikrokódem

V současné době jsou některé CISC procesory konstruovány interně jako procesor RISC. Tento interní mikroprocesor operuje s tzv. mikroinstrukcemi, pomocí nichž jsou interpretovány běžné strojové CISC instrukce. Jedna CISC instrukce je tak provedena jako několik elementárních RISC mikroinstrukcí. Takové CISC procesory jsou tak vlastně malé počítače řízené vlastním programem. (29)

## 6.3.2 RISC

RISC označuje procesory s redukovanou instrukční sadou, jejichž návrh je zaměřen na jednoduchou, vysoce optimalizovanou sadu strojových instrukcí, která je v protikladu s množstvím specializovaných instrukcí ostatních architektur. (27)

6.3.2.1 Charakteristika RISC

Procesory RISC mají oproti CISC procesorům menší počet instrukcí, které se ale různě kombinují pro komplexnější úkony, redukované jsou tedy pouze typy strojových instrukcí (tj. operace s pamětí a řídicí instrukce). Každá instrukce se provádí vždy jeden cyklus díky tomu, že oproti CISC mají všechny instrukce stejnou délku v bitech. S pamětí komunikují po sběrnici. Registry v RISCU jsou víceúčelové, tudíž instrukce může využít jakýkoliv. Dále je v RISC architektuře implementovaný pipelining, neboli řetězení instrukcí.

6.3.2.2 Pipelining

Pipelining je způsob zvýšení výkonu procesoru současným prováděním různých částí několika strojových instrukcí. Základní myšlenkou je rozdělit průběh zpracování jedné instrukce mezi různé části procesoru a tím i umožnění zpracovávat více instrukcí najednou. Fáze zpracování je rozdělena minimálně na 2 úseky:
- Načtení a dekódování instrukce
- Provedení instrukce a případné uložení výsledku

Běžná RISCová pipeline běžně obsahuje pět stupňů:
- Instruction fetch – načtení instrukce
- Decode – dekódování instrukce, zároveň se načítají registry
- Execute – provedení instrukce
- Access – čtení z paměti
- Writeback – zápis výsledku do paměti

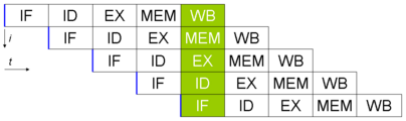
[picture p36: figure]

Obrázek 26 grafické zobrazení RISC pipeliningu (30)
6.4 | Základní struktura MCU
| • procesor – taktovací kmitočet bývá jednotky až stovky MHz, šířka slova 4 až 64 bitů • operační paměť – paměť typu RAM, velikost od jednotek byte po desítky KiB • paměť programu – paměť typu ROM, EPROM, EEPROM nebo flash obsahující program a data, velikost řádově desítky až stovky KiB

- oscilátor – RC nebo krystal
- vstupně/výstupní rozhraní (21)

## 6.4.1 Vstupně/výstupní rozhraní

V závislosti na složitosti a počtu pinů může pro komunikaci s dalšími zařízeními používat různá vstupní nebo výstupní zařízení. (21)
- paralelní porty (až desítky pinů)
- sériové porty (asynchronní, synchronní, RS-232, RS-422, RS-485, USB, SPI…)
- porty komunikačních sběrnic (CAN-BUS, Ethernet)
- A/D převodníky
- D/A převodníky
- PWM výstupy
- vstupy pro zachycování času a počítání událostí (capture)
- aplikačně zaměřené porty (např. vstupy pro čtení čidel polohy rotoru, budiče LDC displayů apod.) (21)

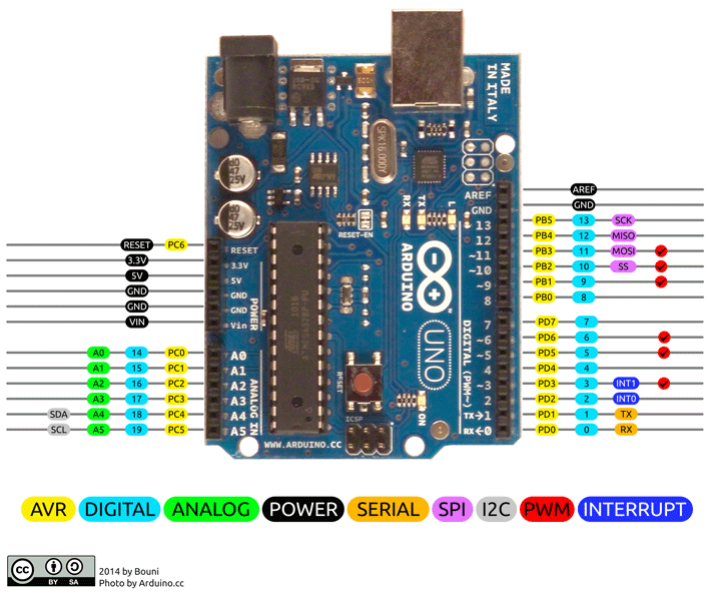
[picture p37: figure]

Obrázek 27 vstupně/výstupní rozhraní na MCU Arduino Uno (31)

Jednočipové počítače určené např. pro mobilní telefony nebo pro automobily mohou disponovat dokonce rozhraním pro připojení blokových RAM (SDR, DDR SDRAM, …) nebo pro připojení pevných disků (ATAPI, SATA). (21)

## 6.4.2 Periferie

Jednočipový počítač může kromě základních součástí obsahovat další periferie:
- řadič přerušení
- časovače
- čítače
- watchdog timer
- řadič displaye
- řadič klávesnice
- programovatelné hradlové pole (21)

## 7 Návrh konstrukce a hardwaru nástavby

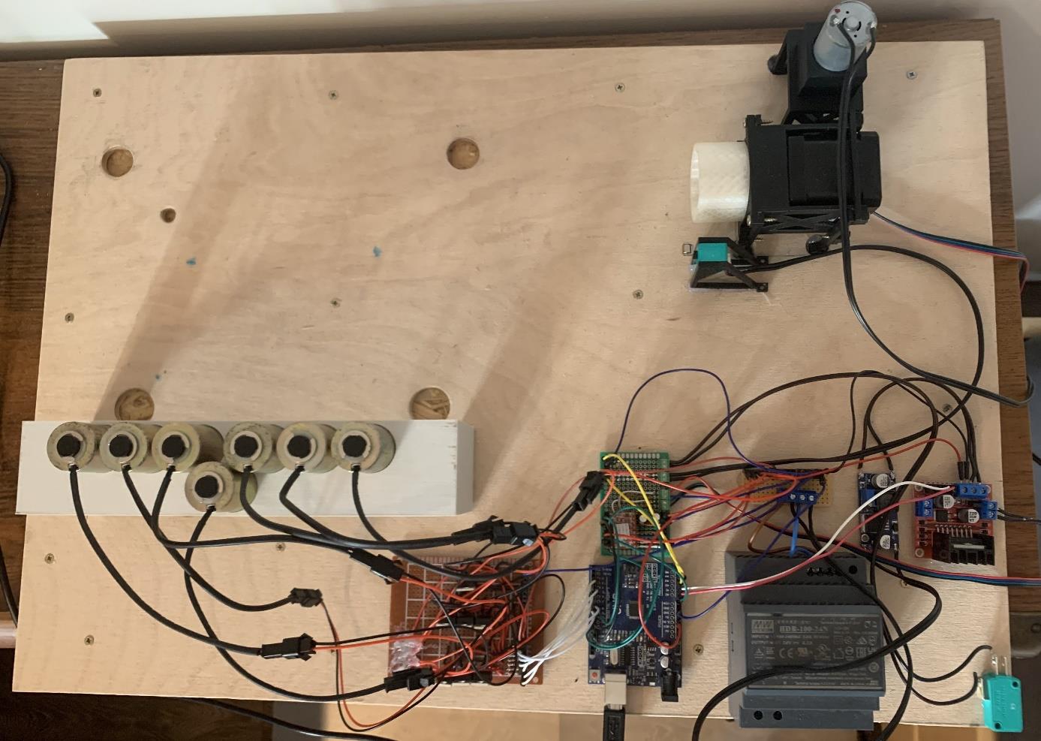
[picture p38: figure]

Obrázek 28 nástavba na Pichtův psací stroj

Nástavba operuje klávesnici a posuv papíru po horizontální a vertikální ose. Všechny tyto části mají část konstrukční a hardwarovou.
Celý hardware ovládá arduino UNO, které přijímá text ze sériové linky, převede ho na Braillovo písmo, a pomocí hardwaru vytiskne požadovaný text.
Všechen hardware je napájen 24 V zdrojem o výkonu 100 W MeanWell HDR-100-24N. Zdroj je určen pro montáž na DIN lištu. Obsahuje ochranu proti zkratu a přetížení/přepětí.

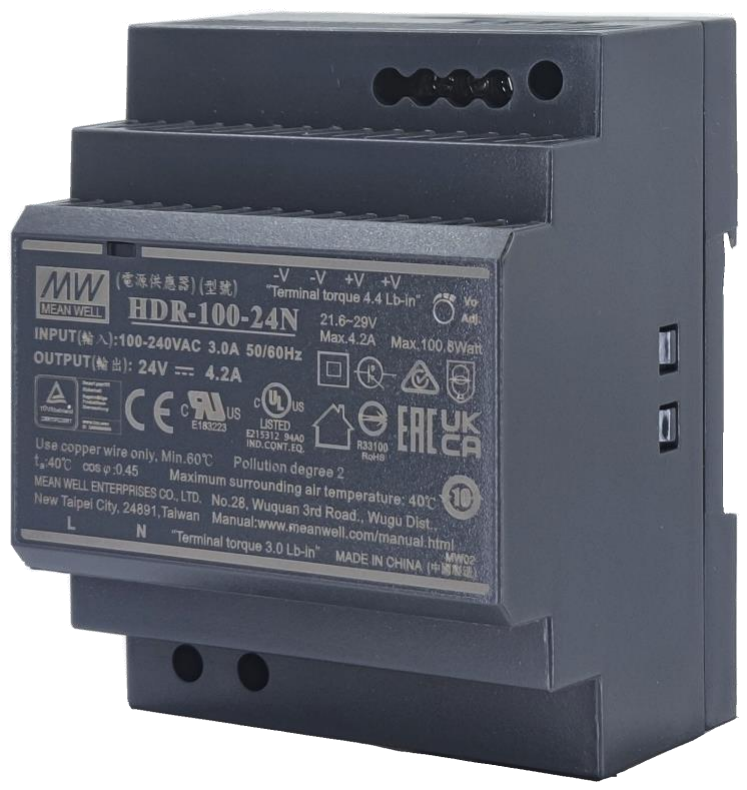
[picture p39: figure]

Obrázek 29 zdroj MeanWell HDR-100-24N (32)
7.1 | Operace klávesnice
| Zmáčknutí klávesy klávesnice je nahrazeno pomocí push solenoidů, které jsou
namontovány přímo nad klávesy.

## 7.1.1 Konstrukce

| Konstrukce je velmi jednoduchá, jedná se pouze o nosič push solenoidů, do
kterého jsou solenoidy vloženy a připevněny pomocí matky, jelikož jejich konstrukce obsahuje vnější závit. Navzdory této jednoduchosti se vyskytly problémy se sílou solenoidů a jejich délkou zdvihu. Technicky vzato se nejedná ani o problém délky zdvihu, ale spíše špatného designu solenoidů, kde délka jejich hřídele je příliš dlouhá, a tím pádem, když je solenoid úplně zasunutý, tak elektromagnet nemá dostatečnou sílu přitáhnout jádro které je v tu chvíli daleko. Bylo tedy třeba u konstrukce pečlivě vyladit výšku montáže solenoidů. Avšak hřídele těchto solenoidů se v délce jemně liší, a tak byly vytvořeny navíc tenké podložky, kterými jsou výšky jednotlivých solenoidů přesně vylaďovány.

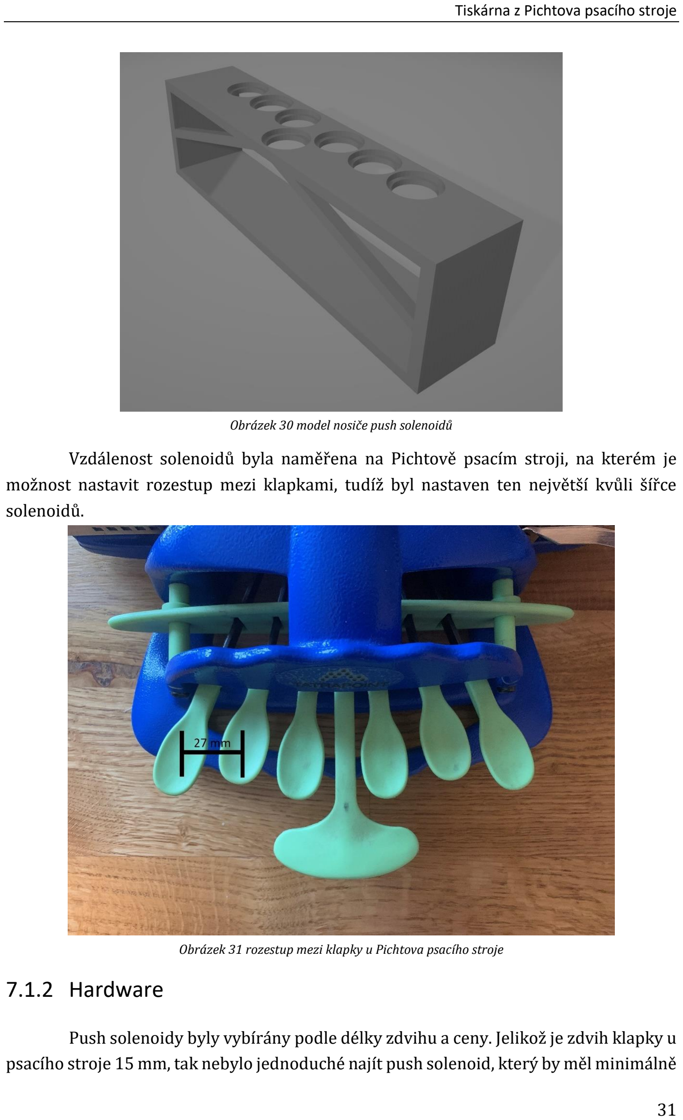
[picture p40: page 39]

Obrázek 30 model nosiče push solenoidů

Vzdálenost solenoidů byla naměřena na Pichtově psacím stroji, na kterém je možnost nastavit rozestup mezi klapkami, tudíž byl nastaven ten největší kvůli šířce solenoidů.

Obrázek 31 rozestup mezi klapky u Pichtova psacího stroje

## 7.1.2 Hardware

Push solenoidy byly vybírány podle délky zdvihu a ceny. Jelikož je zdvih klapky u psacího stroje 15 mm, tak nebylo jednoduché najít push solenoid, který by měl minimálně takovýto zdvih za přijatelnou cenu. Naštěstí byl na eBay solenoid STC-TU2530-A05P který splňoval zdvih 15 mm a byl za přijatelnou cenu.

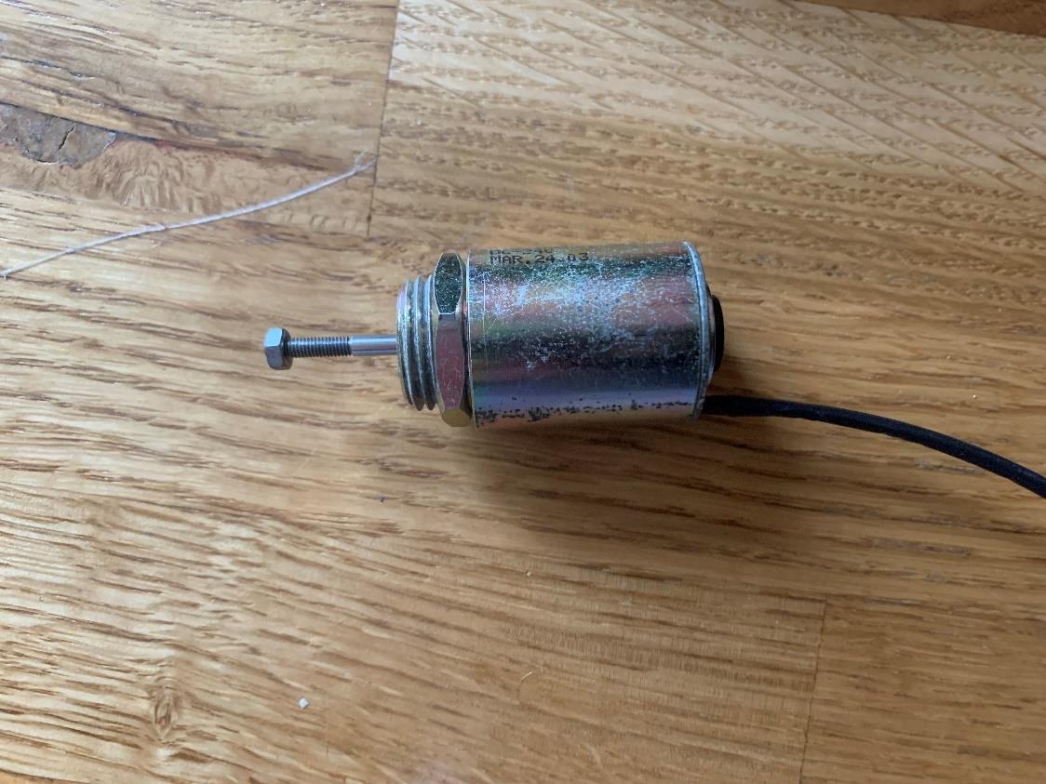
[picture p41: figure]

Obrázek 32 vybraný push solenoid

Jelikož arduino nedokáže digitálními GPIO piny dát větší napětí než napájecí, a proud větší než 200 mA, bylo nutné push solenoidy, který každý požaduje 12 V/0,6 A, napájet jinak. Pro kombinaci použití jiného zdroje pro push solenoidy a jiného ovládacího zařízení byl použit unipolární N-MOSFET tranzistor IRFZ48N.
Vytvořil se jednoduchý plošný spoj, který obsahuje ovládací vstupy z arduina, napájecí vstup, výstupní konektory pro solenoidy a zapojení tranzistorů jako spínačů. U jednotlivých tranzistorů je jeden předřadný rezistor a jeden pull-down rezistor. Na velikosti předřadného rezistoru u unipolárních tranzistorů moc nezáleží, dokud proud nebude přesahovat maximální proud co arduino dokáže, tak se zvolilo 220 Ω. Jako pulldown se doporučuje ku příkladu 100x větší odpor tak se zvolil 100k rezistor.

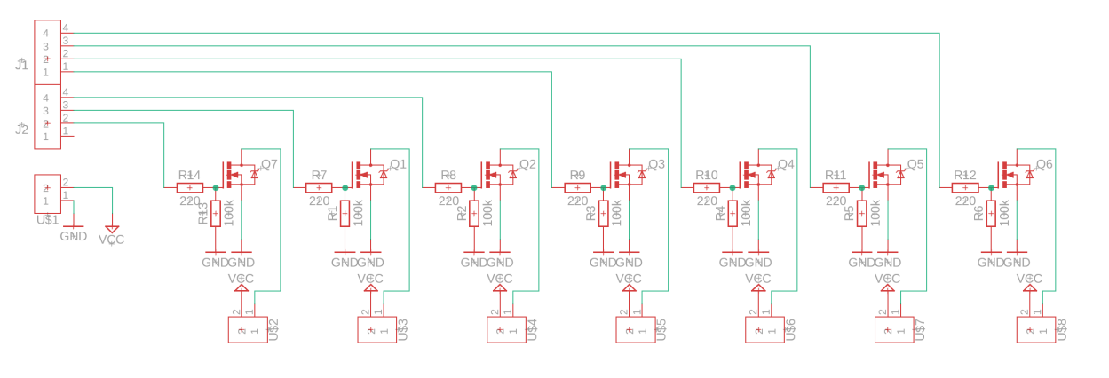
[picture p42: figure]

Obrázek 33 schéma zapojení ovladače solenoidů

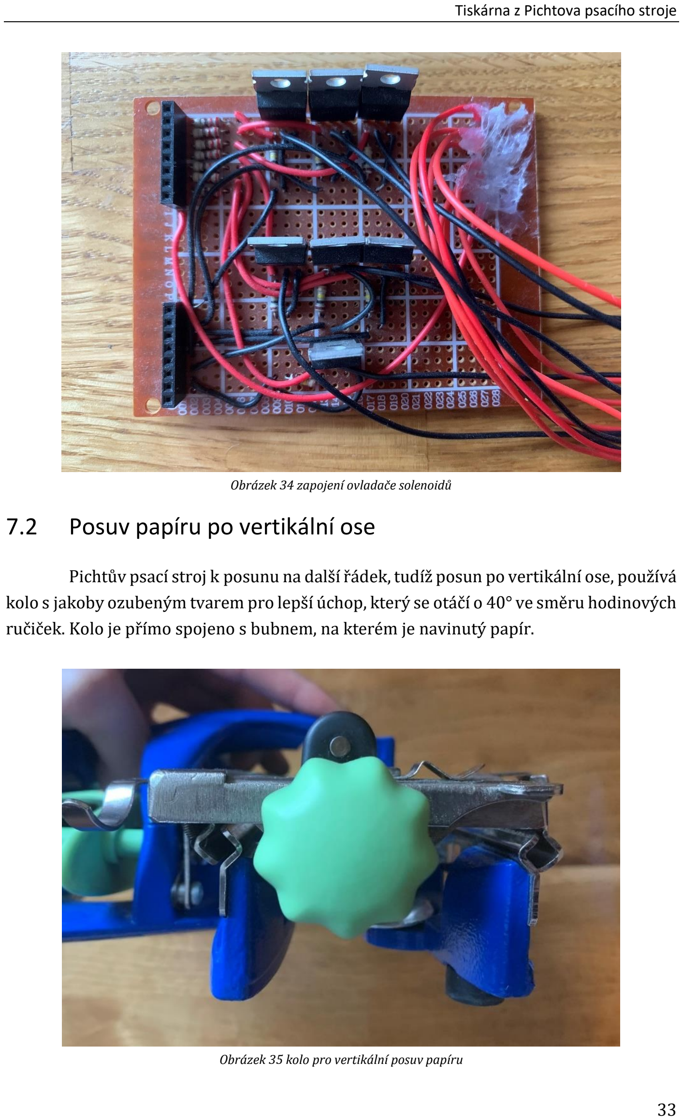
[picture p43: page 41]

Obrázek 34 zapojení ovladače solenoidů
7.2 | Posuv papíru po vertikální ose
| Pichtův psací stroj k posunu na další řádek, tudíž posun po vertikální ose, používá
kolo s jakoby ozubeným tvarem pro lepší úchop, který se otáčí o 40° ve směru hodinových ručiček. Kolo je přímo spojeno s bubnem, na kterém je navinutý papír.

Obrázek 35 kolo pro vertikální posuv papíru

## 7.2.1 Konstrukce

Jelikož je nutno otočit kolem o určitý počet stupňů, byl použit krokový motor. Motor je napojený na buben, který tvarem kopíruje tvar na psacím stroji. Původní plán byl připojit buben přímo ke krokovému motoru, ale to kvůli krouticímu momentu krokového motoru 26 Ncm nebylo možné. Zkusila se tedy silnější varianta tohoto motoru s krouticím momentem 50 Ncm, ale stále to nestačilo. Vymodelovala se tedy jednoduchá převodovka, která by zdvojnásobila krouticí moment, avšak v té době jsem ještě neměl tolik zkušeností s modelováním pro 3D tisk, a tak ta převodovka ani nešla složit. Poprosil jsem svého spolužáka Ondřeje Tománka o pomoc, a ten vytvořil planetární převodovku, která ztrojnásobuje krouticí moment, ale především funguje. Konečná konstrukce se skládá z převodovky, jejíž pouzdro zároveň slouží jako držák motoru, a bubnu pro otáčení kolem.

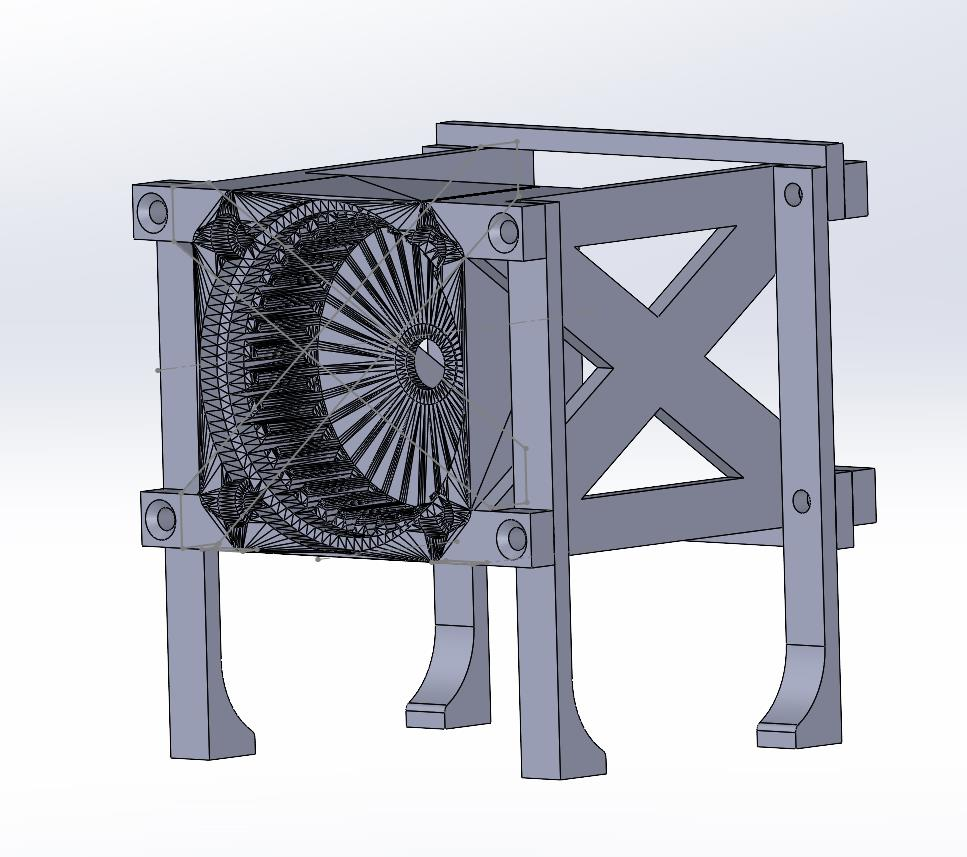
[picture p44: figure]

Obrázek 36 konstrukce pro úchyt krokového motoru k planetární převodovce

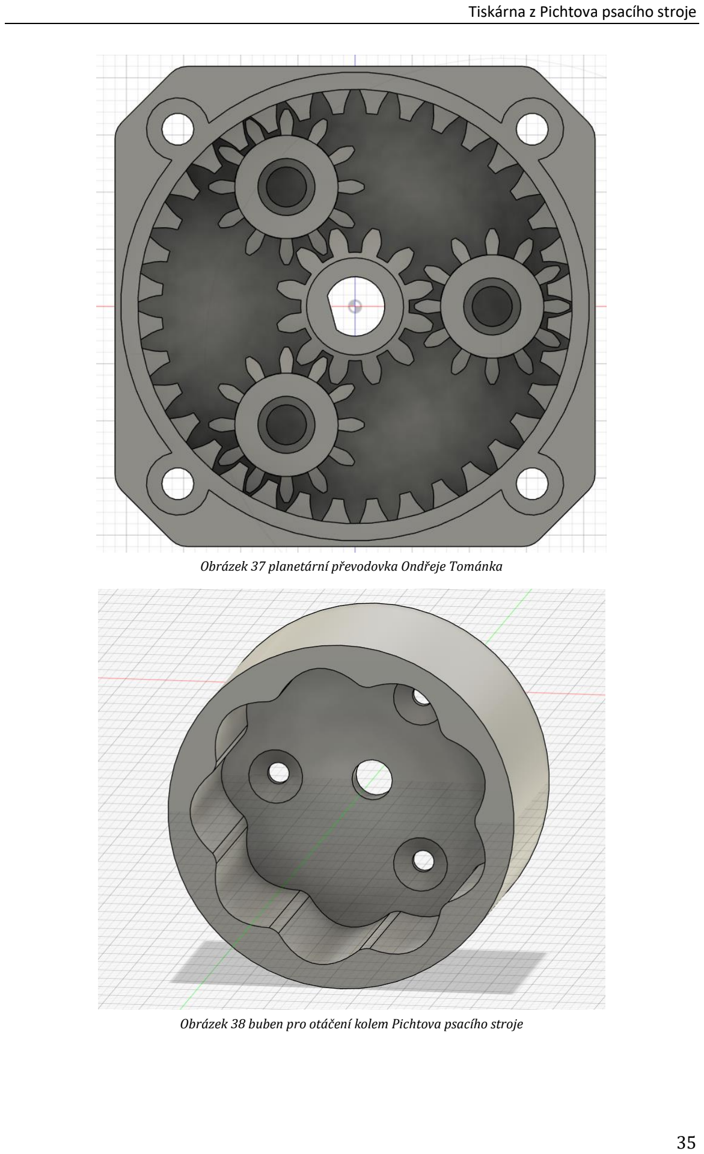
[picture p45: page 43]

Obrázek 37 planetární převodovka Ondřeje Tománka

Obrázek 38 buben pro otáčení kolem Pichtova psacího stroje

## 7.2.2 Hardware

Jako motor byl vybrán krokový motor kvůli potřebě pootočit přesně o 40°. Vybral se NEMA 17 17HS8401 kvůli krouticímu momentu 0,5 Nm.

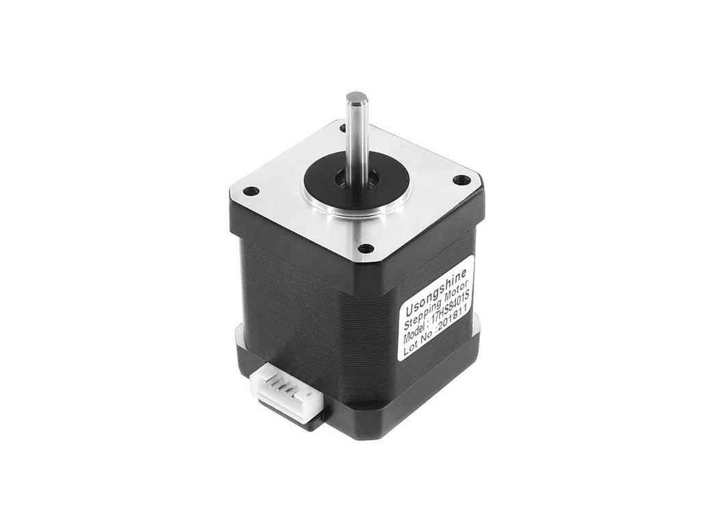
[picture p46: figure]

Obrázek 39 krokový motor NEMA 17 17HS8401 (33)

K ovládání motoru se zvolil ovladač pro krokové motory A4988, který podporuje microstepping, sleep a další funkce. Viz. Obrázek 188. Ovladač je napájen 24 V, a pomocí potenciometru na A4988 bylo nastaveno referenční napětí podle vzorce Uref = Imax/2,5, tudíž 0,68[V] = 1,7[A]/2,5.
V dokumentaci se jevilo, že k tomu, aby reset pin nebyl aktivovaný, tak na něj musí být přivedena logická 1. A k uspání kontroléru je třeba přivedení logické 0 na sleep pin. Zbytek byl zapojen podle schématu, tudíž zapojení vypadá nějak takto:

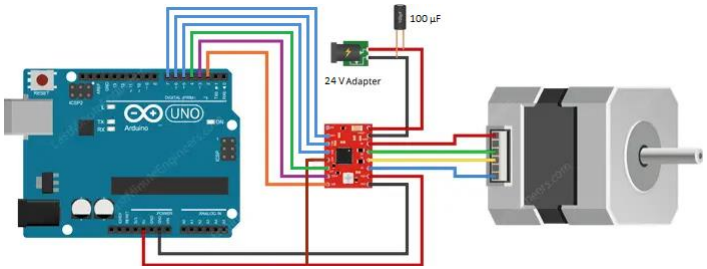
[picture p47: figure]

Obrázek 40 připojení krokového motoru k arduinu pomocí A4988 (34)

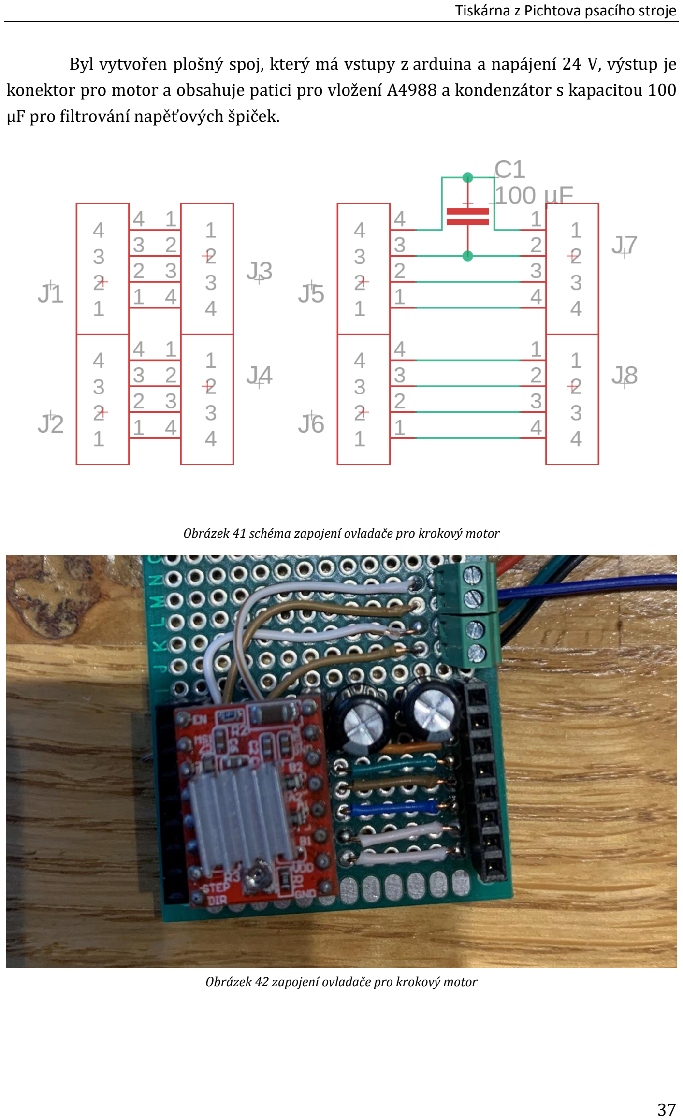
[picture p48: page 45]

Byl vytvořen plošný spoj, který má vstupy z arduina a napájení 24 V, výstup je konektor pro motor a obsahuje patici pro vložení A4988 a kondenzátor s kapacitou 100 µF pro filtrování napěťových špiček.

Obrázek 41 schéma zapojení ovladače pro krokový motor

Obrázek 42 zapojení ovladače pro krokový motor

7.3 | Posuv papíru po horizontální ose
| Posuv papíru po horizontální ose bylo v plánu vyřešit tak, aby mechanismus
využil děr na psacím stroji, do kterých by mohly zapadnout zuby ozubeného kola a posouvaly by celou konstrukcí, avšak ty díry nejsou po celé šířce, tudíž se nedaly použít. Nakonec jediný nápad, co by mohl fungovat, bylo vytvořit naviják, a pomocí struny posouvat celou konstrukci.

## 7.3.1 Konstrukce

| Bylo třeba vyhledat motor s převodovkou pro vysoký krouticí moment, nějaký se
náhodně vybral, a podle zvoleného rozumného průměru bubnu se vypočítal krouticí moment a zda je menší než krouticí moment daného motoru.
| F[N] = m[kg] ∗ a [ m s
| 2 ] = 1,2 ∗ 9,81 = 11,722 N M[Nm] = F[N] ∗ r[m] = 11,722 ∗ 0,0082 = 0,0965304 Nm < 1,3 Nm Byla tedy vytvořena konstrukce, ke které se motor přišroubuje. Na hřídel motoru

se nandá a pomocí šroubu připevní buben o poloměru 8,2mm. Konstrukce bubnu se rozšířila o hřídel, kterou drží hlavní část konstrukce, jelikož se celkem často stávalo, že po dotáhnutí šroubu k hřídeli se buben lehce ohnul a vychýlil, což s tím, že na něj působí celkem velká síla, mělo za následek jeho vypadnutí z hřídele. Hřídel však nezabránila vychýlení plastu při dotáhnutí, a hřídel se pak ve výsledku jen ohýbala a způsobovala tření. Buben byl nakonec vysoustružen z hliníku, čímž se vyřešily všechny problémy.

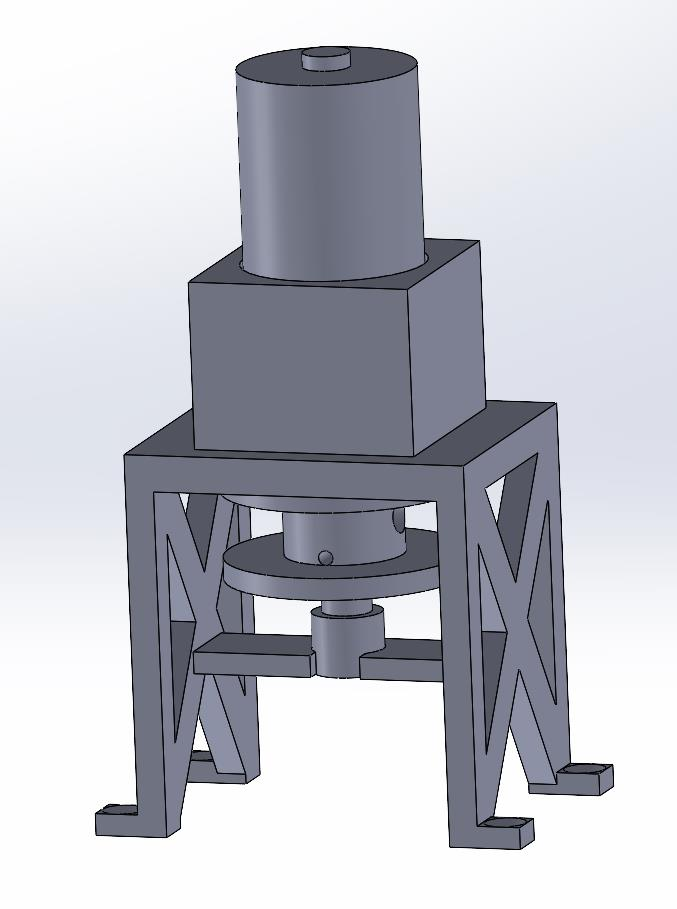
[picture p49: figure]

Obrázek 43 konstrukce pro horizontální posuv papíru

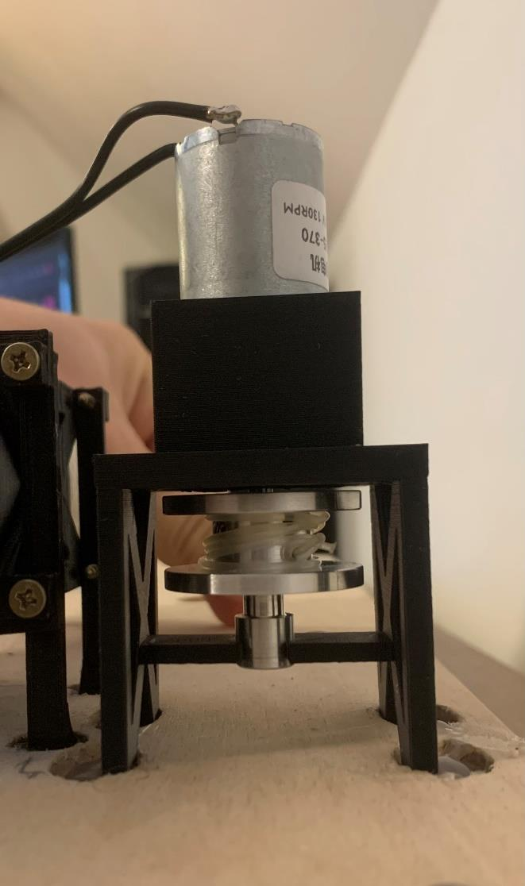
[picture p50: figure]

Obrázek 44 fyzická podoba konstrukce pro horizontální posuv papíru

Dále je detekován dojezd do koncové polohy pomocí tlačítka koncové polohy s jednoduchou kladkou pro jednoduší stisknutí. Byl použit mikrospínač MSW-0. Vytvořila se pro něj velmi jednoduchá konstrukce, která ho drží v požadované poloze.
Stejné tlačítko bylo použito i pro uživatelský vstup při vkládání nového papíru, takže když se dotiskne celá stránka a mechanismus vysune papír, tak se čeká na výměnu papíru uživatelem, která se potvrdí zmáčknutím tohoto tlačítka.

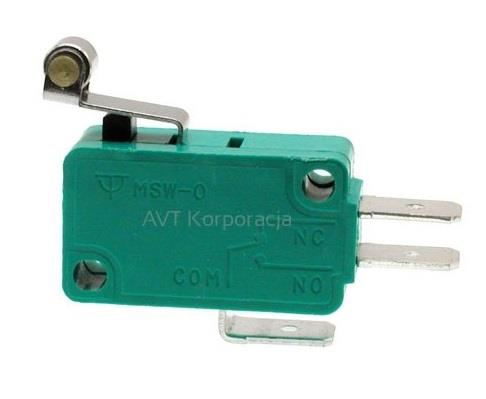
[picture p51: figure]

Obrázek 45 snímač koncové polohy MSW-0 (35)

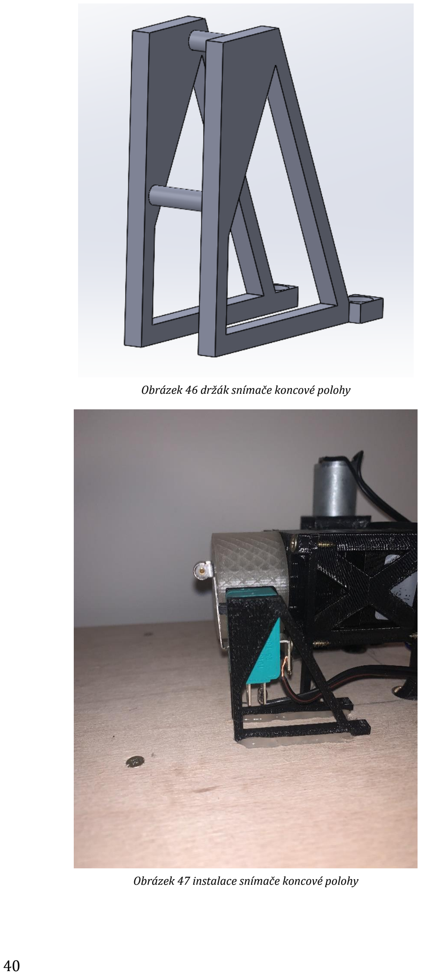
[picture p52: page 48]

Obrázek 46 držák snímače koncové polohy

Obrázek 47 instalace snímače koncové polohy

## 7.3.2 Hardware

Jako motor byl, jak je již psáno, vybrán motor s převodovkou pro vysoký krouticí moment JGA25-370. Motor má napájecí napětí 12 V a proud 450 mA, 130 RPM a maximální krouticí moment 1,3 Nm.

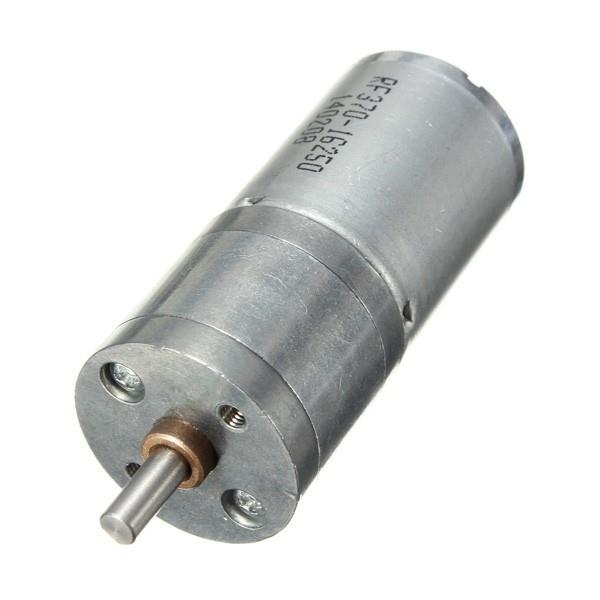
[picture p53: figure]

Obrázek 48 motor s převodovkou (6)

Původně se měla vždy na konci řádku přitáhnout konstrukce psacího stroje pomocí navijáku, a pak, když zase nástavba tiskla, měla pružina v psacím stroji postupně odmotávat strunu motoru, ale převodovka na motoru tomu zabránila. Tudíž se musel místo tranzistoru na ovládání motoru použít H-můstek, aby se během psaní mohla postupně odmotávat struna. Byl vybrán H-můstek L298N. Můstek byl připojen dvěma konektory k arduinu a je napájen napětím 5 V.

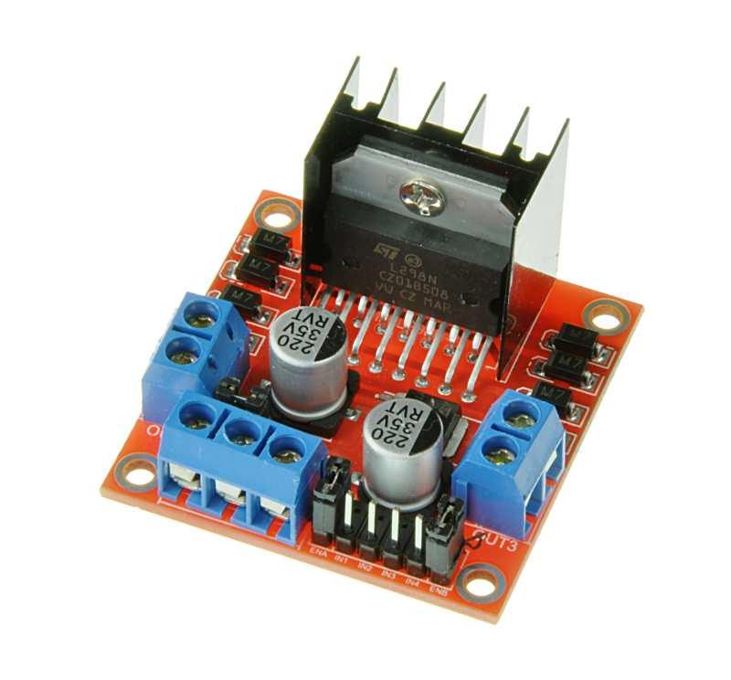
[picture p54: figure]

Obrázek 49 H-můstek L298N (36)

Jelikož motor potřebuje 12 V, a zdroj dodává 24 V, tak byl koupen nastavitelný DC-DC step-down konvertor s LM2596 a bylo nastaveno 12 V na výstupu. Těchto 12 V je přiváděno do H-můstku.

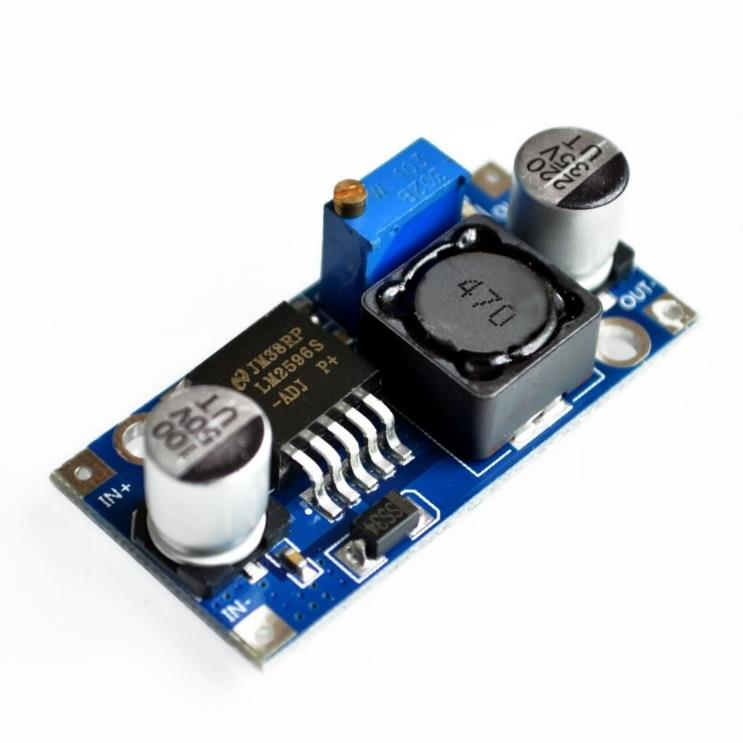
[picture p55: figure]

Obrázek 50 DC-DC step-down konvertor s LM2596 (37)

Samotná tlačítka koncové polohy a tlačítko vložení papíru byla připojena k arduinu s pull-down rezistorem.

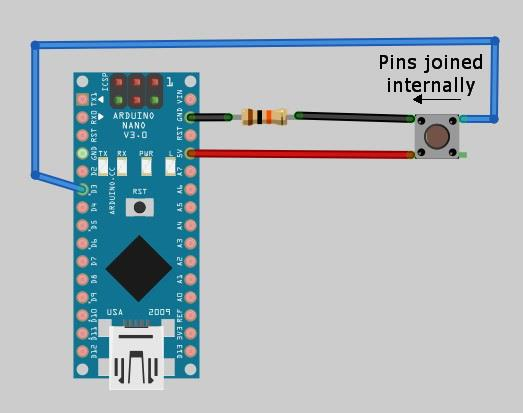
[picture p56: figure]

Obrázek 51 připojení tlačítka s pull-down rezistorem (38)

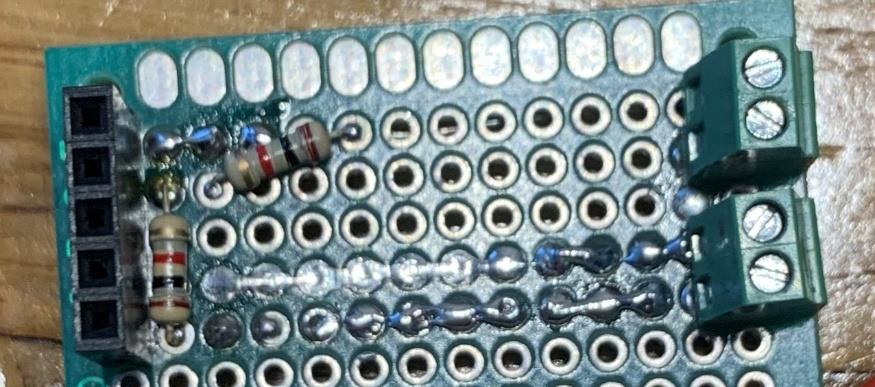
[picture p57: figure]

Obrázek 52 zapojení pull-down rezistorů

## 8 Software

Tato část pojednává o softwarovém řešení celého projektu, tudíž rozebírá jak program pro arduino, tak program pro komunikaci s arduinem.

## 8.1 Program pro arduino

Celý program je napsán jako knihovna, která pracuje s celou nástavbou, pro možnost jednoduchého rozšíření v budoucnu, tím pádem je program implementující knihovnu velmi krátký.
V header souboru knihovny je array structů (brailleDict), kde jeden struct obsahuje znak key, ukazatel na int a číslo count, tudíž se jedná o tabulku obsahující klíčový znak, jeho korespondující body v Braillově šestibodu a počet těchto bodů. To nahrazuje dictionary které se vyskytuje např. v C#.
V hlavním programu pro arduino se nejdříve nastavují proměnné počet znaků v řádku, počet řádků, zpoždění mezi jednotlivými údery, vertikální posun papíru ve stupních, porty pro koncový snímač, uživatelské tlačítko, motory a push solenoidy. Poté se inicializuje knihovna operující hardware.

#include "TypeWriter.h"

#define charsInRow 29

#define numberOfRows 24

#define pressDelay 200

#define degrees 360/9

// INPUTS
const int stopPosBtn = A3; const int paperInsertedBtn = A4; // OUTPTUS
const int motorPins[] = {A1, A2};
const int StepPinout[] = {13, 12, 9, 10, 11, A0};
const int brailleDots[] = {2, 3, 4, 5, 6, 7, 8}; // 2 - is for space because it's index is 0 and other ones indexes are same as brailleDict
TypeWriter | BrailleTypeWriter(brailleDots, | StepPinout,
motorPins, stopPosBtn, paperInsertedBtn);

V setup funkci se nastaví doplňující proměnné pro knihovnu. V loop funkci se vždy přečte celý přijatý řádek ze sériové linky, zkontroluje se, zda se nejedná o znaky začátku a ukončení tisku, a pošle se text na tisk knihovně.

bool started = false;
void setup(){
Serial.begin(9600);
BrailleTypeWriter.setUp(charsInRow, | numberOfRows,
pressDelay, degrees);
}

void loop(){
String input = getInput();
// Pokud je přijatá zpráva "\\\r\n" tak se začne tisknout // a když se zpráva přijme podruhé, tak se tisk ukončí if(input == "\\\r\n"){
if(!started){
BrailleTypeWriter.initPrint(); started = true;
}else{
BrailleTypeWriter.endPrint(); Serial.println("Ending print"); started = false;
}
}else{
BrailleTypeWriter.print(input); }
}

String getInput(){
while (Serial.available() == 0) {
return Serial.readString(); }
}

Samotný tisk probíhá následovně: Přijatý text se rozdělí na jednotlivá slova do String array, každé slovo se pošle do smyčky, která znak za znakem slova porovnává se znaky z brailleDict array. Pokud se jedná o nějaký speciální znak např.: číslo, velké písmeno, celé slovo velkými písmeny atd., tak se provedou speciální operace, co vyžadují pravidla Braillské abecedy, to je tisk jednoho nebo více speciálních znaků. Následně se znak vytiskne. Při tisku každého znaku se na pár milisekund zapne DC motor, aby se trochu odmotala struna.
Každé slovo se nejdřív zkontroluje, zda nebude po vytištění počet vytištěných znaků překračovat maximální počet znaků, pokud ano, tak se posune list na nový řádek. Posunu listu na nový řádek se dosáhne spuštěním DC motoru, který začne namotávat strunu, a tudíž přitáhne konstrukci psacího stroje, vypne se v moment, kdy se sepne tlačítko koncové polohy. Následně se nejdříve probudí ovladač krokového motoru, a až potom se pošle instrukce na otočení krokového motoru o daný počet stupňů. Po dokončení se ovladač zase uspí. Přičte se číslo jedna k hodnotě sledující, na jakém řádku se tisk provádí.
Po dosažení maximálního počtu řádků se vysune papír a vypíše „Insert new paper“, čeká se na uživatele až vloží nový papír a tento úkon potvrdí stiskem tlačítka na boku nástavby, pak se dál tiskne normálně.
Když arduino obdrží místo textu řetězec znaků „\\\r\n“, tak se vypíše „Ending print“, ukončí tisk a vysune papír.
8.2 | Program pro komunikaci s arduinem
| Program pro komunikaci s arduinem je napsán v C#. Jedná se o windows forms
aplikaci, která je sice specificky pro windows, ale bylo vhodné napsat aplikaci s GUI bez použití knihoven jako OpenTK (C# port OpenGL), kterých implementace by byla komplikovanější než samotný program. C# byl vybrán především kvůli mým víceletým zkušenostem s ním, které nemám absolutně v žádném jiném jazyce.
| Celý program je ve výsledku vcelku jednoduchý. Uživatel pouze vybere port, na
kterém má připojenou nástavbu, popřípadě upraví rychlost přenosu v baudech, klikne na apply a může začít s tiskem. Do textového pole vloží text, který chce vytisknout, klikne na Tisk a tiskárna ho vyzve k vložení papíru. Po vložení papíru uživatel zmáčkne tlačítko na boku nástavby a už se tiskne.

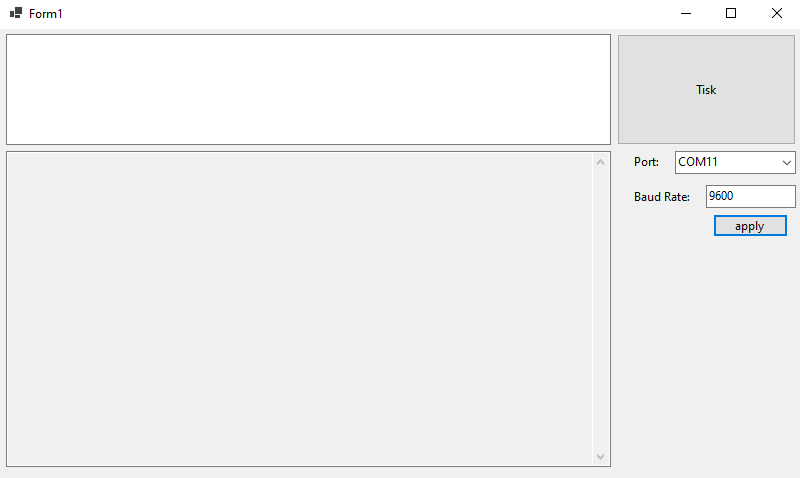
[picture p58: figure]

Obrázek 53 rozhraní programu pro komunikaci s arduinem

Implementace tohoto také není nijak složitá. Form aplikace po zvolení portu a kliknutí na apply otevře sériovou komunikaci pomocí knihovny integrované v .NET (IO.Ports). Zároveň se otevře vlákno na čtení textu ze sériové linky, aby se neblokovalo hlavní vlákno pro uživatelské rozhraní.
Po zmáčknutí tlačítka tisk se vložený text rozloží na menší části fixní délky, pokud se tedy nejedná o jedno dlouhé slovo, to pak může délku přesahovat, a ty se postupně v novém vlákně posílají sériovou linkou. Každá další část se pošle až po přijetí zprávy „done“ od arduina. Tyto části se musí posílat postupně, jelikož při testování samotného arduino programu se objevil problém, kdy arduino přijme delší text, ale další práce s tím textem nejsou možné a často docházelo k buffer overflow. Jako první a poslední se posílá zpráva „\\\r\n“, která, pokud přišla poprvé, tiskárnu nastaví, aby čekala na vložení papíru, a když přijde podruhé, tak ukončí tisk.
Po odeslání všech částí textu do arduina a přijetí poslední zprávy „done“, se ukončí vlákno a umožní se tisk nového textu.
Pokud uživatel klikne na Tisk během tisku, nebo pokud ještě nevybral port nebo změní port během tisku, tak vyskočí dialogové okno s patřičnou zprávou.

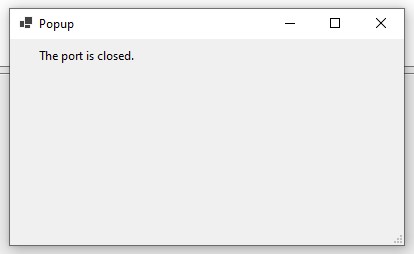
[picture p59: figure]

Obrázek 54 dialogové okno s upozorněním na uzavřený port

## Závěr

Cílem práce bylo vytvořit nástavbu na Pichtův psací stroj, což znamenalo vytvořit různé konstrukční prvky které s již existujícím mechanismem pracovali. To, jak jsem zjistil není vůbec jednoduchý úkol, jelikož tento mechanismus je velmi dobře navržený, a tak v něm není moc volného místa pro umístění jakéhokoliv hardwaru, a tak jsem vše musel postavit kolem stroje.
S posunem po horizontální ose jsem měl během tvorby největší problémy. Software i obvody jsou celkem jednoduché díky použití již hotového H-můstku, ale konstrukce navijáku byla plastem neproveditelná. Po delší době, co jsem zkoušel všemožné úpravy bubnu navijáku jsem dospěl k tomu, že síly potřebné na přitáhnutí posuvníku konstrukce jsou příliš velké, a způsob jakým mohu připevnit buben k hřídeli mi nedovoluje tyto síly zvládnout. Tím jsem si uvědomil že i na poměrně malé prototypové konstrukce někdy 3D tiskárna prostě nestačí.
Co si myslím že je na hardwaru do budoucna potřeba změnit jsou samotné solenoidy. Solenoidy, co jsem vybral jsou sice levné, ale celkem dost nespolehlivé, jejich délky hřídelí se liší a u některých hřídel vůbec nedrží.
Do psaní softwaru jsem vstupoval sebevědomě díky svým víceletým zkušenostem, avšak byly tu pro mě i nové věci jako psaní objektů v C++, kde jsem musel řetězit konstruktory.
Rozhodně hodlám na projektu pokračovat. Tuto nástavbu vypůjčím bratrově škole, kde se postupně bude přicházet na nedostatky, které budu následně opravovat.

## Seznam zkratek a odborných výrazů

MCU
Microcontroller – DPS deska obsahující jednočip a periferie

ROM
Read Only Memory – paměť ze které lze pouze číst

RWM
Read Write Memory – paměť umožňující jak čtení, tak zápis

CPU
Central Processing Unit – procesor

CISC
Complex instruction set computer – rozsáhlý instrukční set počítače

RISC
Reduced instruction set computer – redukovaný instrukční set počítače

FPU
Floating-point unit – část procesoru pracujícími s desetinnými čísly s neurčeným množstvím desetinných míst

VLIW
Very Long Instruction Word – architektura procesorů umožňující instrukční paralelismus

EPIC
Explicitly parallel instruction computing – architektura, kde se dosahovalo instrukčního paralelismu pomocí kompileru

INT
Integer – číselná proměnná v programovacích jazycích, u arduina o velikosti 2 bytů

GUI
Graphical user interface – grafické uživatelské rozhraní umožňující intuitivní práci se softwarem

KiB
Kibibajt – jednotka kapacity paměťových médií

Watchdog timer
Časovač sledující, zda se CPU nezacyklilo, pokud ano, tak vyšle signál pro restart

Buffer overflow
Přetečení zásobníku – jev ke kterému dojde, pokud je množství dat zapisovaných do zásobníku větší než velikost zásobníku

## Seznam obrázků

## Použité zdroje

1. Wikipedia foundation. Psací stroj pro nevidomé. Wikipedie otevřená encyklopedie. [Online] 4. září 2023. [Citace: 5. říjen 2023.] https://cs.wikipedia.org/wiki/Psac%C3%AD_stroj_pro_nevidom%C3%A9.
2. —. Braillovo písmo. Wikipedie. [Online] 16. říjen 2023. [Citace: 21. leden 2024.] https://cs.wikipedia.org/wiki/Braillovo_p%C3%ADsmo.
3. —. Louis Braille. Wikipedia. [Online] 17. leden 2024. [Citace: 18. leden 2024.] https://en.wikipedia.org/wiki/Louis_Braille.
4. TyfloCentrum České Budějovice, o.p.s. Braillovo bodové písmo. Tyflokabinet České Budějovice, o.p.s. [Online] [Citace: 18. leden 2024.] https://www.tyflokabinet-cb.cz/braill.htm.
5. Wikipedia foundation. Stejnosměrný motor. Wikipedia org. [Online] 13. Říjen 2023. [Citace: 19. Říjen 2023.]
https://cs.wikipedia.org/wiki/Stejnosm%C4%9Brn%C3%BD_motor.
6. DRÁTEK.CZ. DRÁTEK.CZ. Motor s převodovkou 25GA-370 12V 130RPM. [Online] [Citace: 19. říjen 2023.] https://dratek.cz/arduino/123005-motor-jga25-370-12v-130rpm-s-prevodovkou.html.
7. E-manuel. Elektromotory. E-manuel. [Online] [Citace: 19. říjen 2023.] https://e-manuel.cz/kapitoly/elektromagneticke-stroje/vyklad/elektromotory/.
8. Schweber, Bill. Motor Control - Don't Ignore the Humble Brushed DC Motor. MOUSER ELECTRONICS. [Online] [Citace: 19. říjen 2023.] https://cz.mouser.com/applications/dont-ignore-the-brushed-dc-motor/.
9. Electrical Concepts. Brushless DC (BLDC) Motor. Electrical Concepts. [Online] 18. květen 2016. [Citace: 19. říjen 2023.] https://electricalbaba.com/brushless-dc-bldc-motor/.
10. Vavřiňák, Petr. STŘEDNÍ ŠKOLA ELEKTROTECHNICKÁ, Ostrava. STŘEDNÍ ŠKOLA ELEKTROTECHNICKÁ, Ostrava. [Online] 2013. [Citace: 19. říjen 2023.] https://www.sse-najizdarne.cz/projekty/roboti/dokumenty/v_prez_esp_7.pdf.
11. botland. Krokový motor JK42HS48-2504 200 kroků / ot. 3,1 V / 2,5 A / 0,47 Nm. botland. [Online] [Citace: 2. listopad 2023.] https://botland.cz/krokove-motory/3615-krokovy-motor-jk42hs48-2504-200-kroku-ot-31-v-25-a-047-nm-5904422359379.html.
12. RAVEO s.r.o. Jak funguje krokový motor? RAVEO. [Online] [Citace: 2.. Listopad 2023.] https://www.raveo.cz/jak-funguje-krokovy-motor.
13. Servo-Drive. FAQ: často pokládané otázky o krokových motorech. Servo-Drive. [Online] [Citace: 2. listopad 2023.] https://www.servo-drive.cz/%C4%8Dasto_pokl%C3%A1dan%C3%A9_ot%C3%A1zky_o_krokov%C3%BDch_motorech.php.

14. TME. KROKOVÝ MOTOR – DRUHY A PŘÍKLADY APLIKACÍ KROKOVÝCH MOTORŮ. DPS Elektronika od A do Z. [Online] 3. únor 2021. [Citace: 2. listopad 2023.] https://www.dps-az.cz/clanky/id:75946/krokovy-motor-druhy-a-priklady-aplikaci-krokovych-motoru.
15. DRÁTEK.CZ. Klon motor driver pro Reprap 3D tiskárny - A4988. DRÁTEK.CZ. [Online] [Citace: 2. listopad 2023.] https://dratek.cz/arduino/122957-motor-driver-a4988-pro-reprap-3d-tiskarny-cerveny.html.
16. Geeplus. Proportional solenoids. geeplus. [Online] [Citace: 10. Listopad 2023.] https://www.geeplus.com/proportional-solenoids/.
17. —. Super Stroke Solenoids. geeplus. [Online] [Citace: 10. Listopad 2023.] https://www.geeplus.com/super-stroke-solenoids/.
18. —. Latching Solenoids. geeplus. [Online] [Citace: 10. Listopad 2023.] https://www.geeplus.com/latching-solenoids/.
19. Kolstad, Charles. What Is A Latching Solenoid Valve? TAMESON. [Online] 9. květen 2022. [Citace: 10. listopad 2023.] https://tameson.com/pages/latching-solenoid-valve.
20. PROBOTS. 1564B 6V SOLENOID PUSH PULL LINEAR ACTUATOR MOTOR ELECTROMAGNET. PROBOTS. [Online] [Citace: 10. listopad 2023.] https://probots.co.in/6v-solenoid-push-pull-linear-actuator-motor-electromagnet.html.
21. Wikipedia foundation. Jednočipový počítač. Wikipedie Otevřená encyklopedie. [Online] 25. říjen 2022. [Citace: 30. listopad 2023.] https://cs.wikipedia.org/wiki/Jedno%C4%8Dipov%C3%BD_po%C4%8D%C3%ADta%C4%8D.
22. botland. Mikrokontrolér AVR - zavaděč ATmega328P-PU DIP + Arduino. botland. [Online] [Citace: 30. listopad 2023.] https://botland.cz/avr-v-krytu-tht/1984-mikrokontroler-avr-zavadec-atmega328p-pu-dip-arduino-5903351249911.html.
23. Candy. ATMEGA328P-PU Microcontroller: Features, Pinout, and Datasheet. Utmel ELECTRONICS. [Online] 8. únor 2022. [Citace: 30. listopad 2023.] https://www.utmel.com/components/atmega328ppu-microcontroller-features-pinout-and-datasheet?id=1252.
24. Wikipedia foundation. Von Neumannova architektura. Wikipedie Otevřená encyklopedie. [Online] 25. září 2023. [Citace: 30. listopad 2023.] https://cs.wikipedia.org/wiki/Von_Neumannova_architektura.
25. —. Harvardská architektura. Wikipedie. [Online] 5. říjen 2023. [Citace: 7. prosinec 2023.] https://cs.wikipedia.org/wiki/Harvardsk%C3%A1_architektura.
26. Atom. HW: Von Neumannova vs Harvardska architektura. Blogger. [Online] 12. červen 2011. [Citace: 7. prosinec 2023.] https://mycvut.blogspot.com/2011/06/hw-von-neumannova-vs-harvardska.html.

27. Wikipedia foundation. RISC. Wikipedie. [Online] 1. říjen 2023. [Citace: 7. prosinec 2023.] https://cs.wikipedia.org/wiki/RISC.
28. ShareTechnote. Embedded System. ShareTechnote. [Online] [Citace: 7. prosinec 2023.]
https://www.sharetechnote.com/html/EmbeddedSystem_CISC_RISC.html.
29. Wikipedia foundation. CISC. Wikipedia. [Online] 6. červen 2023. [Citace: 7. prosinec 2023.] https://cs.wikipedia.org/wiki/CISC.
30. —. Classic RISC pipeline. Wikipedia. [Online] 21. prosinec 2023. [Citace: 22. prosinec 2023.] https://en.wikipedia.org/wiki/Classic_RISC_pipeline.
31. COMPONENTS101. Arduino Uno. COMPONENTS101. [Online] 19. červenec 2021. [Citace: 22. prosinec 2023.] https://components101.com/microcontrollers/arduino-uno.
32. MEAN WELL. Mean Well HDR-100-24N Zdroj na DIN 100W 24V. eshop-meanwell. [Online] [Citace: 22. prosinec 2023.] https://www.eshop-meanwell.cz/hdr-100-24n-mean-well-zdroj-na-din-92w-24v/.
33. láskakit. Krokový motor NEMA 17 17HS8401 0,5Nm. laskakit. [Online] [Citace: 4. leden 2024.] https://www.laskakit.cz/krokovy-motor-nema-17-17hs8401-0-5nm/.
34. Last Minute ENGINEERS. Control Stepper Motor with A4988 Driver Module & Arduino. Last Minute ENGINEERS. [Online] [Citace: 11. leden 2024.] https://lastminuteengineers.com/a4988-stepper-motor-driver-arduino-tutorial/.
35. CNCSHOP. Mikrospínač MSW-0. CNCSHOP. [Online] [Citace: 11. leden 2023.] https://www.cncshop.cz/mikrospinac-msw-0/pro101.html.
36. láskakit. H-můstek L298N, dvoumotorový modul. laskakit. [Online] [Citace: 11. leden 2024.] https://www.laskakit.cz/h-mustek-pro-krokovy-motor-l298n--dualni-motorovy-modul/.
37. —. Step-down měnič s LM2596. laskakit. [Online] [Citace: 11. leden 2024.] https://www.laskakit.cz/step-down-menic-s-lm2596/.
38. Currey, Martyn. Keypads and Button Switches on the Arduino. Martyn Currey. [Online] [Citace: 11. leden 2024.] https://www.martyncurrey.com/keypads/.
39. Wikipedia foundation. Pipelining. Wikipedie. [Online] 25. říjen 2022. [Citace: 7. prosinec 2023.] https://cs.wikipedia.org/wiki/Pipelining.

I

## A. Seznam přiložených souborů

Na přiloženém datovém nosiči se nacházejí následující soubory a složky:
– | MP2024-Michalenko-Jakub-Tiskárna_z_Pichtova_psacího_stroje.docx –
| editovatelná verze dokumentace maturitní práce
– | MP2024-Michalenko-Jakub-Tiskárna_z_Pichtova_psacího_stroje.pdf –
| tisknutelná verze dokumentace maturitní práce
– | SOČ-2024-E4C-Michalenko-Jakub.docx – editovatelná verze
| dokumentace odborné práce
– | SOČ-2024-E4C-Michalenko-Jakub.pdf – tisknutelná verze dokumentace
| odborné práce
– | Modely.zip – kompletní modely
– | Programy.zip – zdrojové kódy pro arduino a pro komunikaci s ním
