CallMeRZIBI/Braille_typwriter_printer/maturity_exam/E4C_Přihláška_Michalenko.pdf

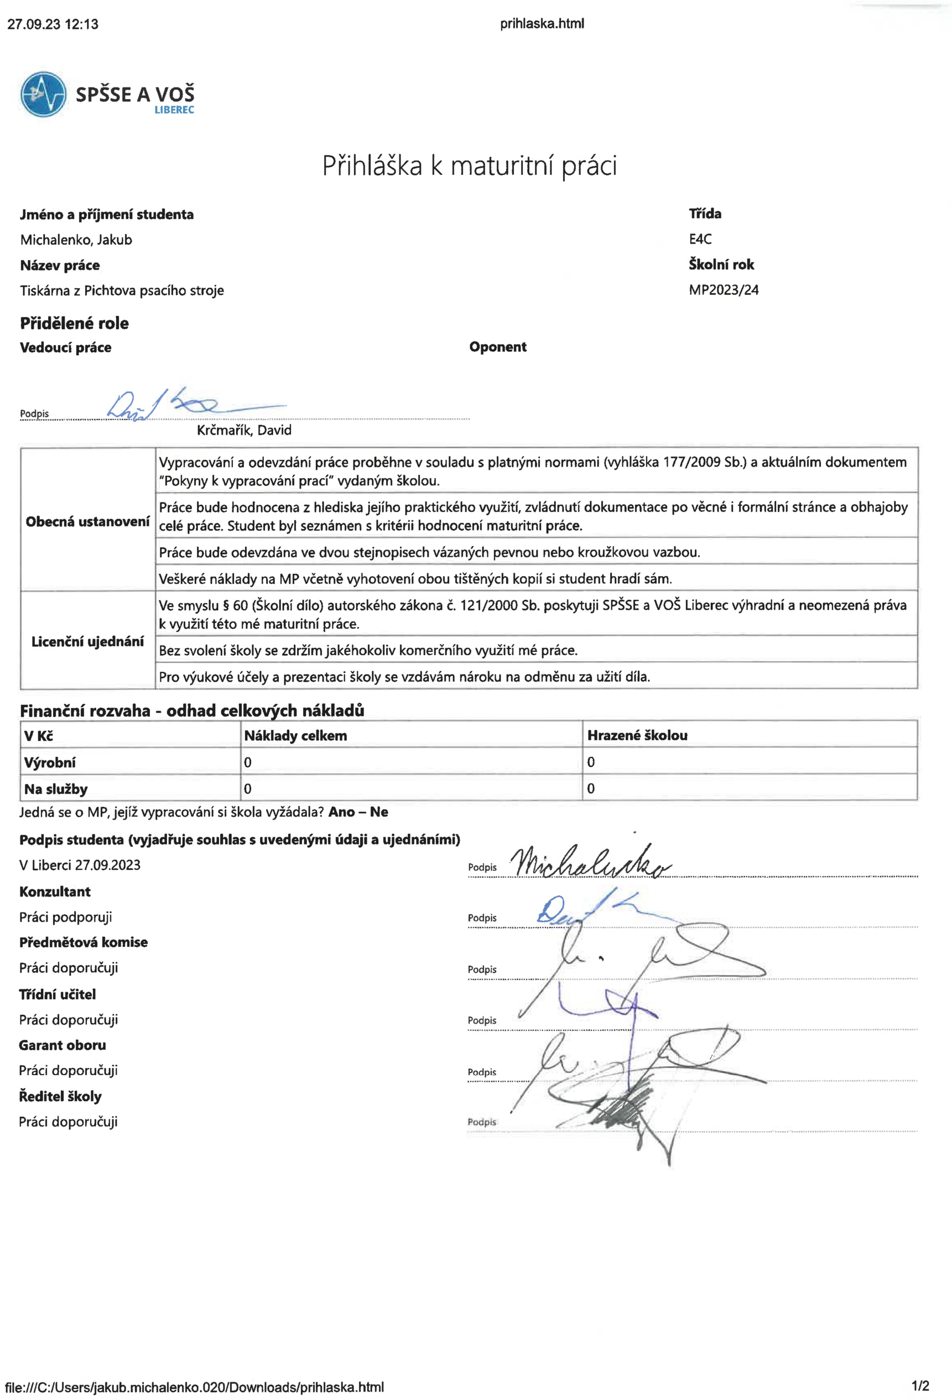
[picture p60: page 1]
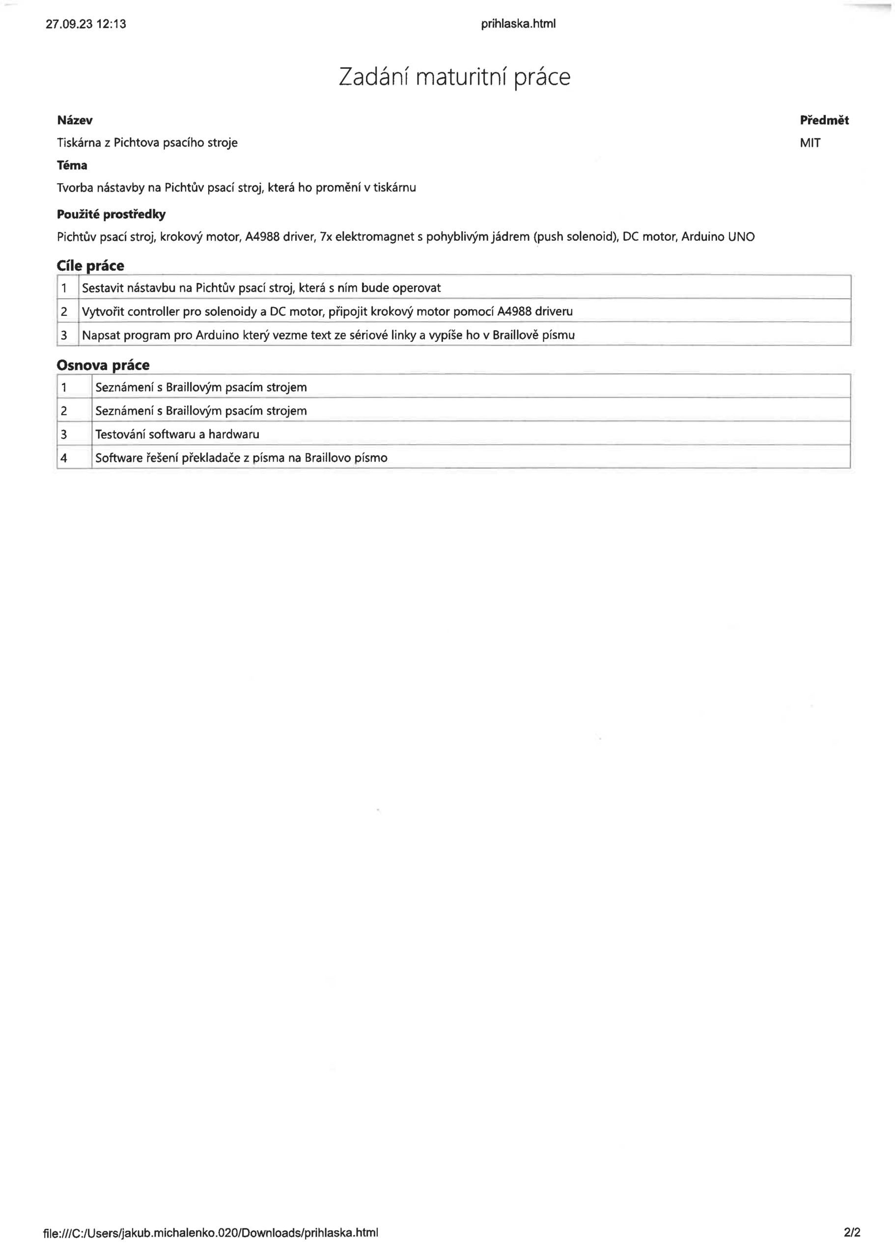
[picture p61: page 2]
