CallMeRZIBI/Braille_typwriter_printer/maturity_exam/braillovo_pismo_cislovani.png

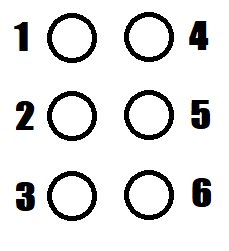
maturity_exam/braillovo_pismo_cislovani.png
