CallMeRZIBI/Braille_typwriter_printer/maturity_exam/createChunks.png

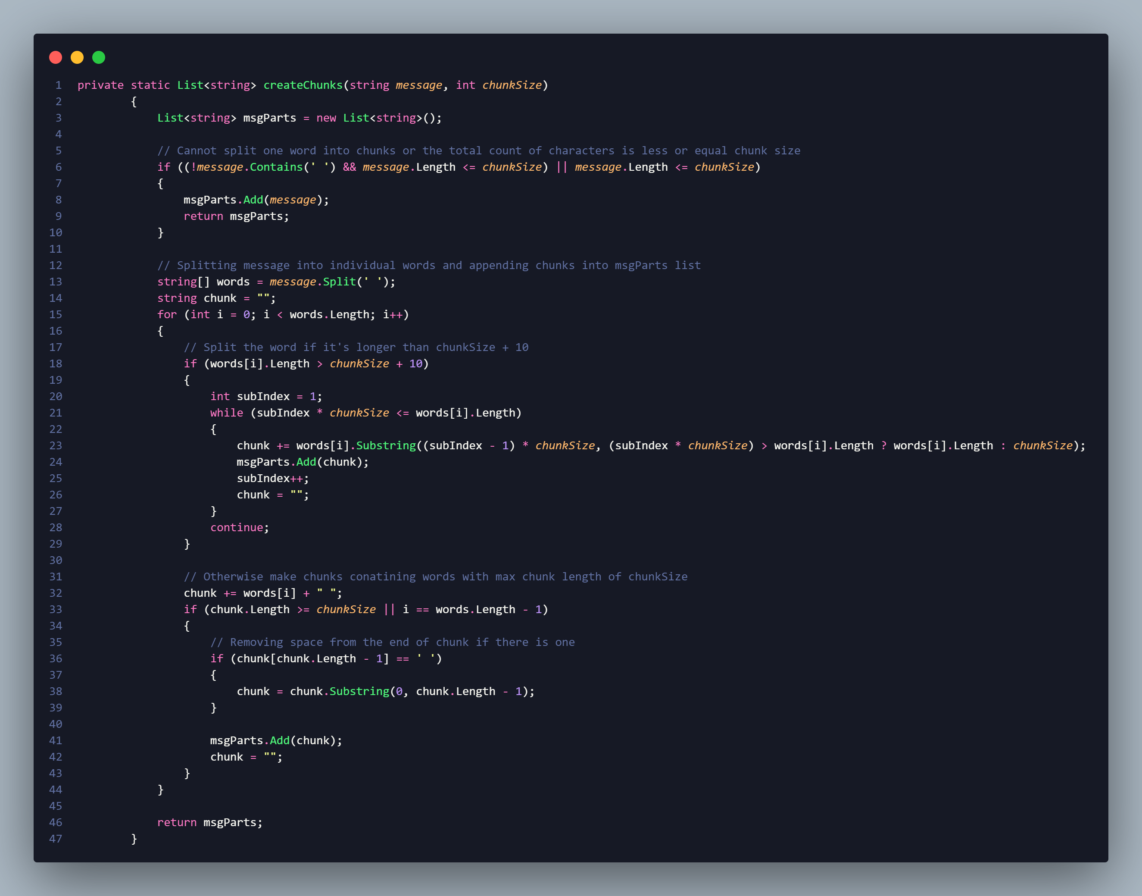
maturity_exam/createChunks.png
