CallMeRZIBI/Braille_typwriter_printer/maturity_exam/dc_motor_cizi_buzeni.png

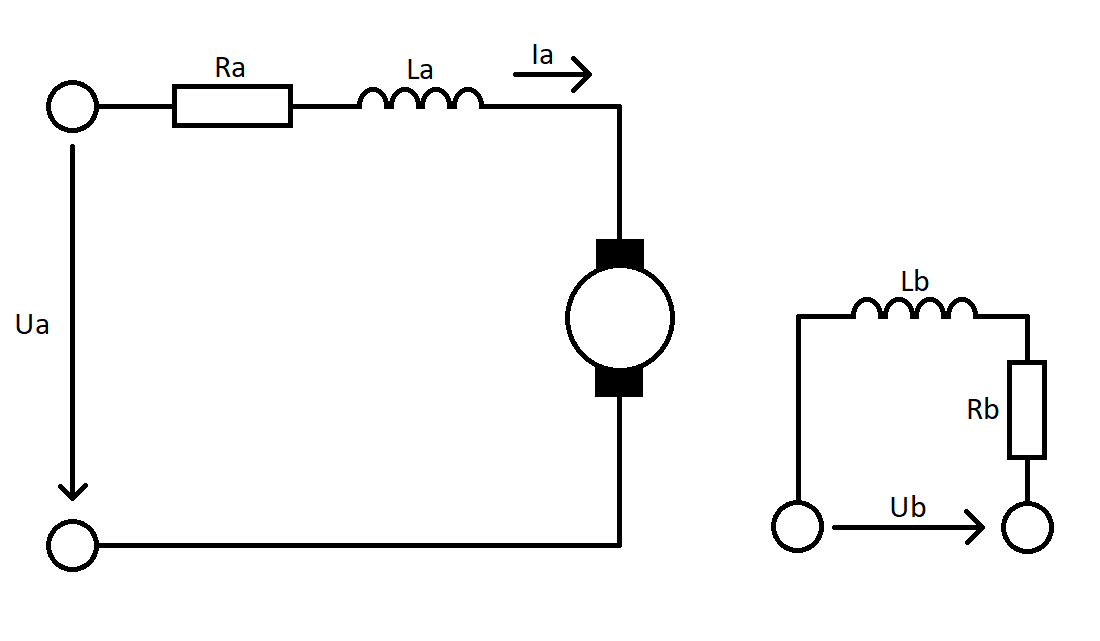
maturity_exam/dc_motor_cizi_buzeni.png
