CallMeRZIBI/Braille_typwriter_printer/maturity_exam/dc_motor_seriove_buzeni.png

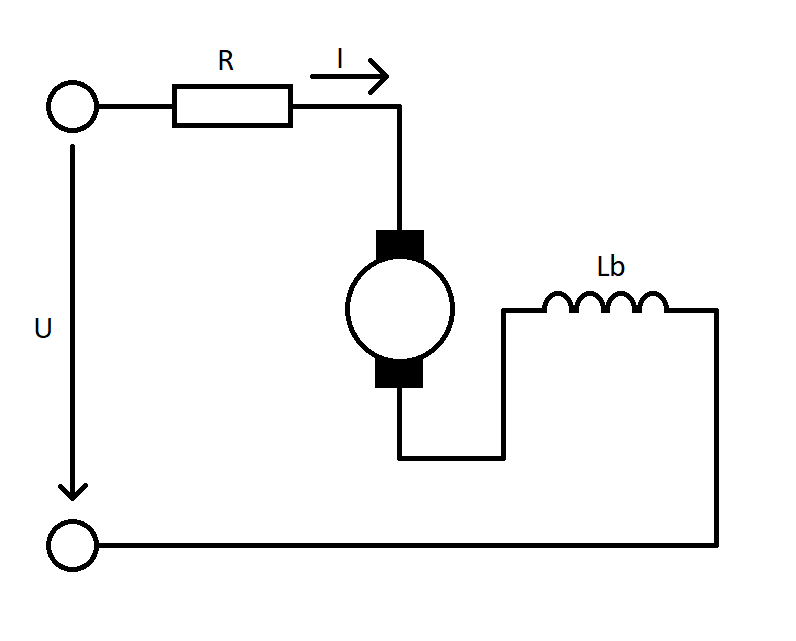
maturity_exam/dc_motor_seriove_buzeni.png
