CallMeRZIBI/Braille_typwriter_printer/maturity_exam/dict_struct.png

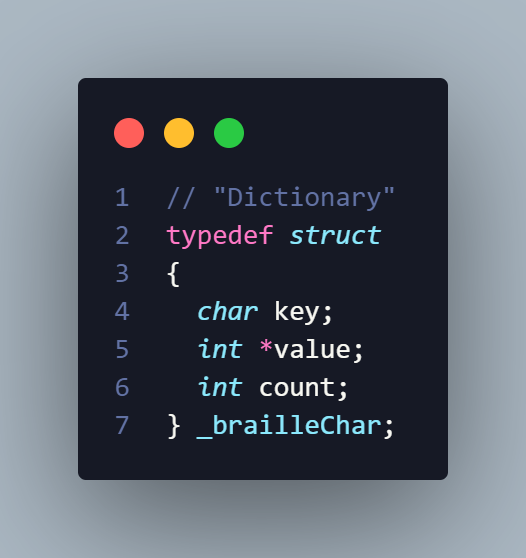
maturity_exam/dict_struct.png
