CallMeRZIBI/Braille_typwriter_printer/maturity_exam/dictionary.png

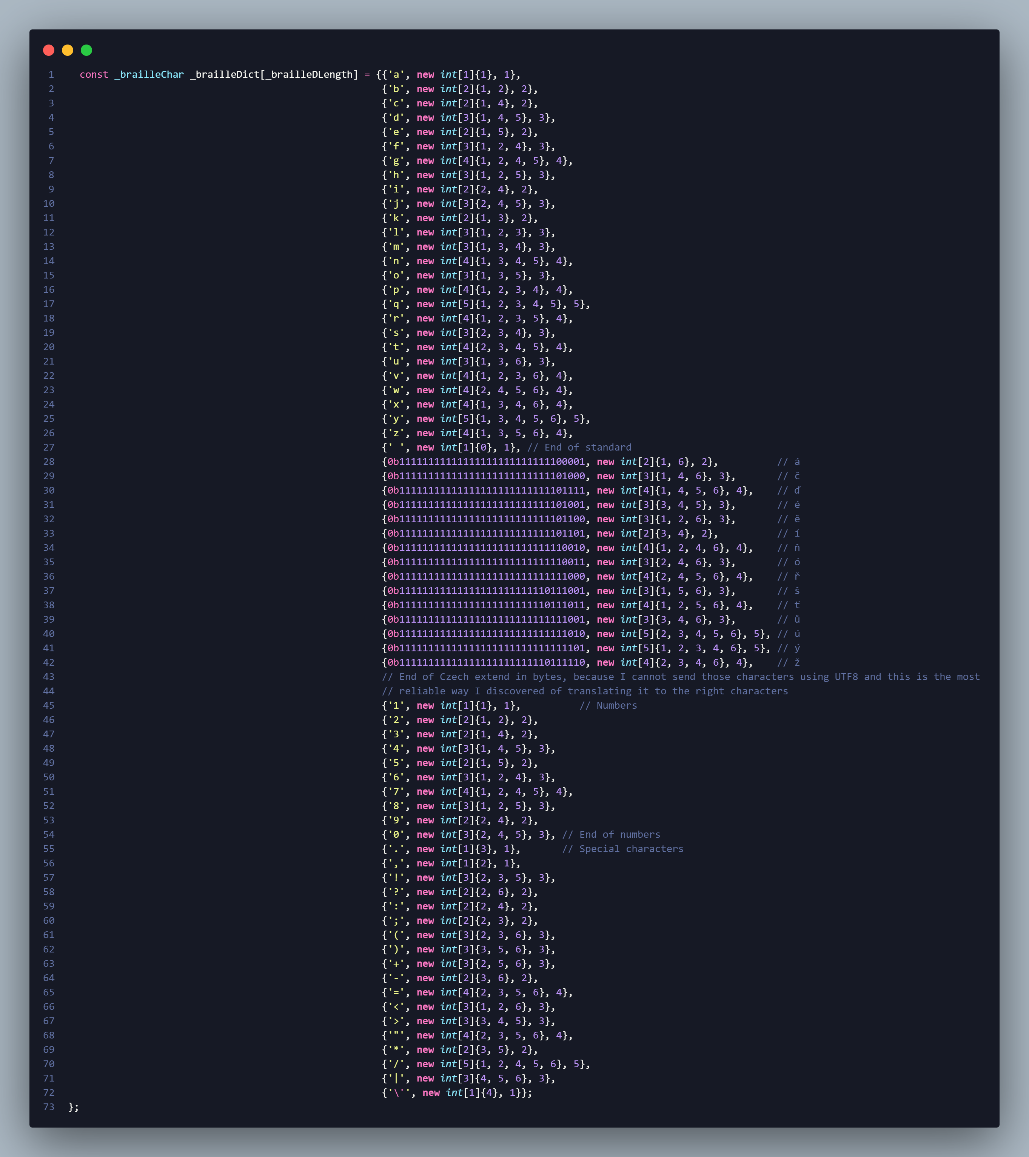
maturity_exam/dictionary.png
