CallMeRZIBI/Braille_typwriter_printer/maturity_exam/drzak_koncoveho_snimace.png

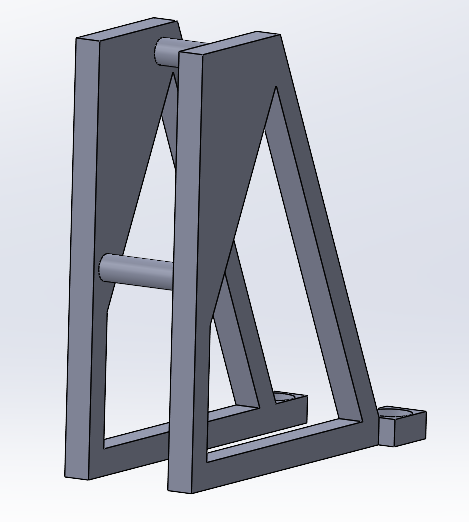
maturity_exam/drzak_koncoveho_snimace.png
