CallMeRZIBI/Braille_typwriter_printer/maturity_exam/krok_motor_spoj.png

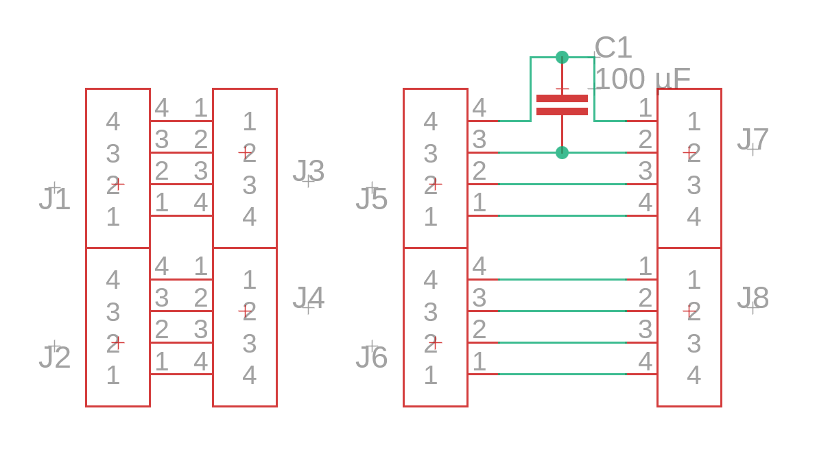
maturity_exam/krok_motor_spoj.png
