CallMeRZIBI/Braille_typwriter_printer/maturity_exam/linear_push_pull_solenoid.jpg

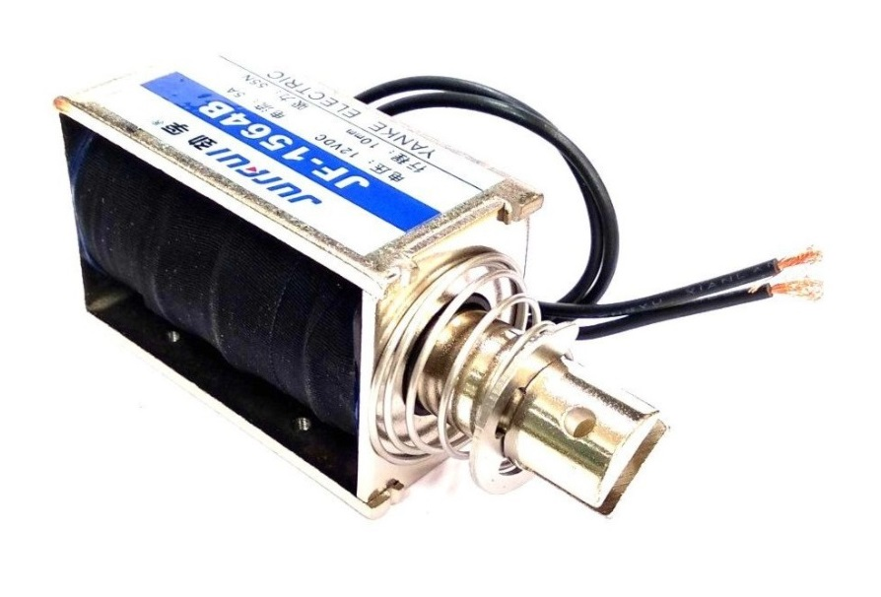
maturity_exam/linear_push_pull_solenoid.jpg
