CallMeRZIBI/Braille_typwriter_printer/maturity_exam/posuv_vertikalne.jpg

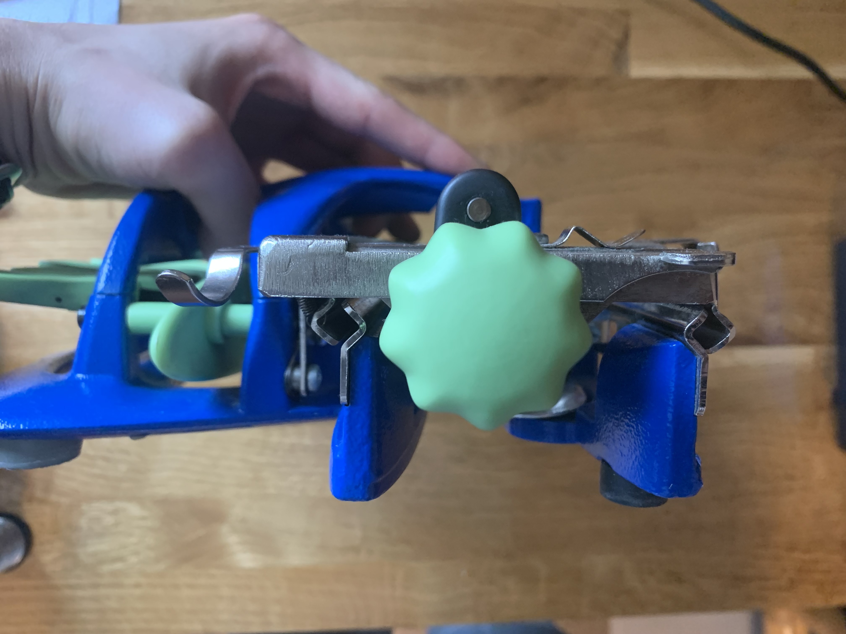
maturity_exam/posuv_vertikalne.jpg
