CallMeRZIBI/Braille_typwriter_printer/maturity_exam/psaci_stroj_roztec_klapek.jpg

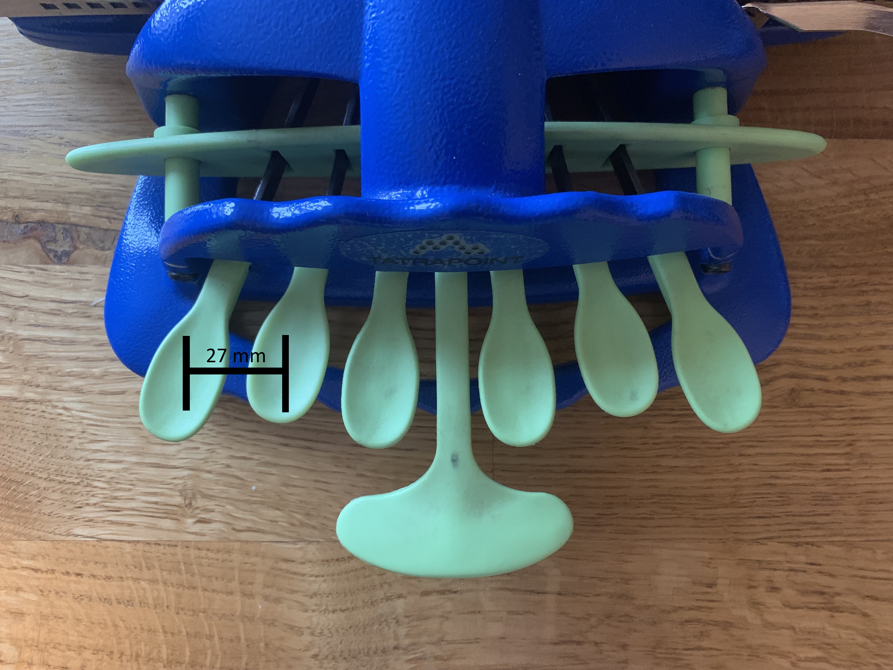
maturity_exam/psaci_stroj_roztec_klapek.jpg
