CallMeRZIBI/Braille_typwriter_printer/maturity_exam/solenoid_controller.jpg

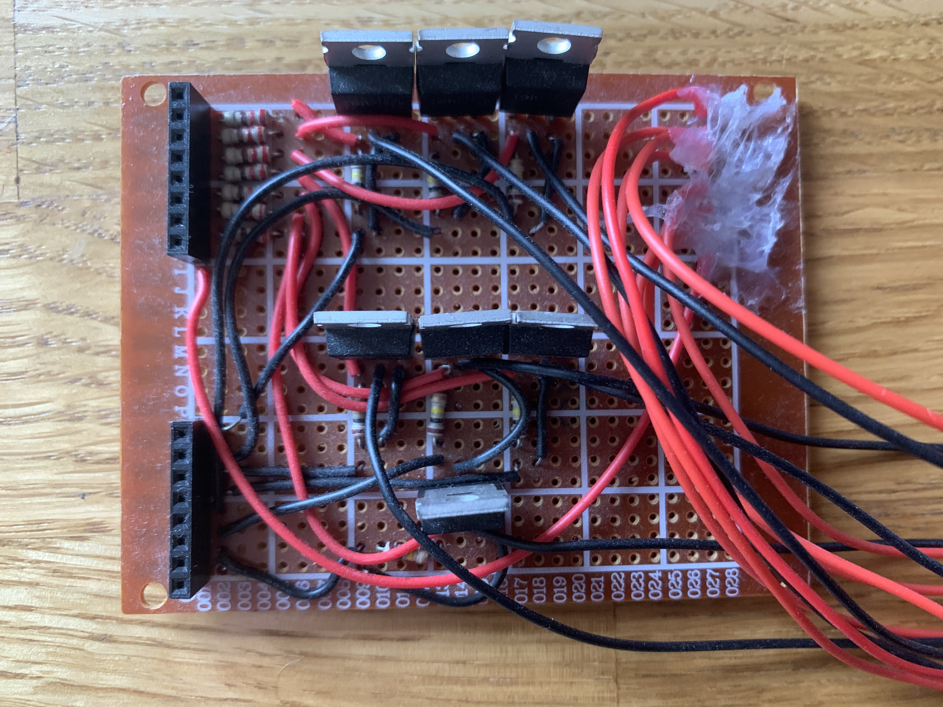
maturity_exam/solenoid_controller.jpg
