CallMeRZIBI/Braille_typwriter_printer/maturity_exam/solenoid_holder.png

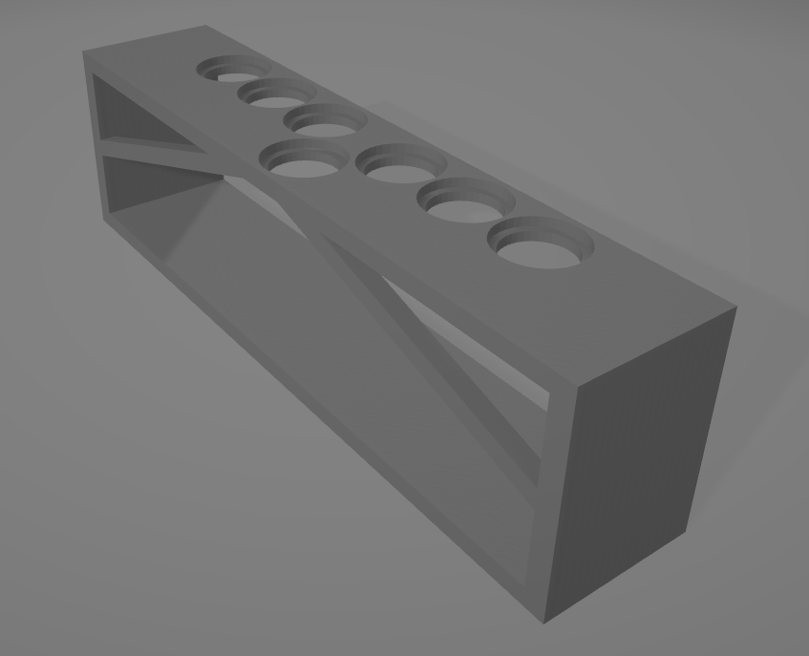
maturity_exam/solenoid_holder.png
