CallMeRZIBI/Braille_typwriter_printer/maturity_exam/write_func.png

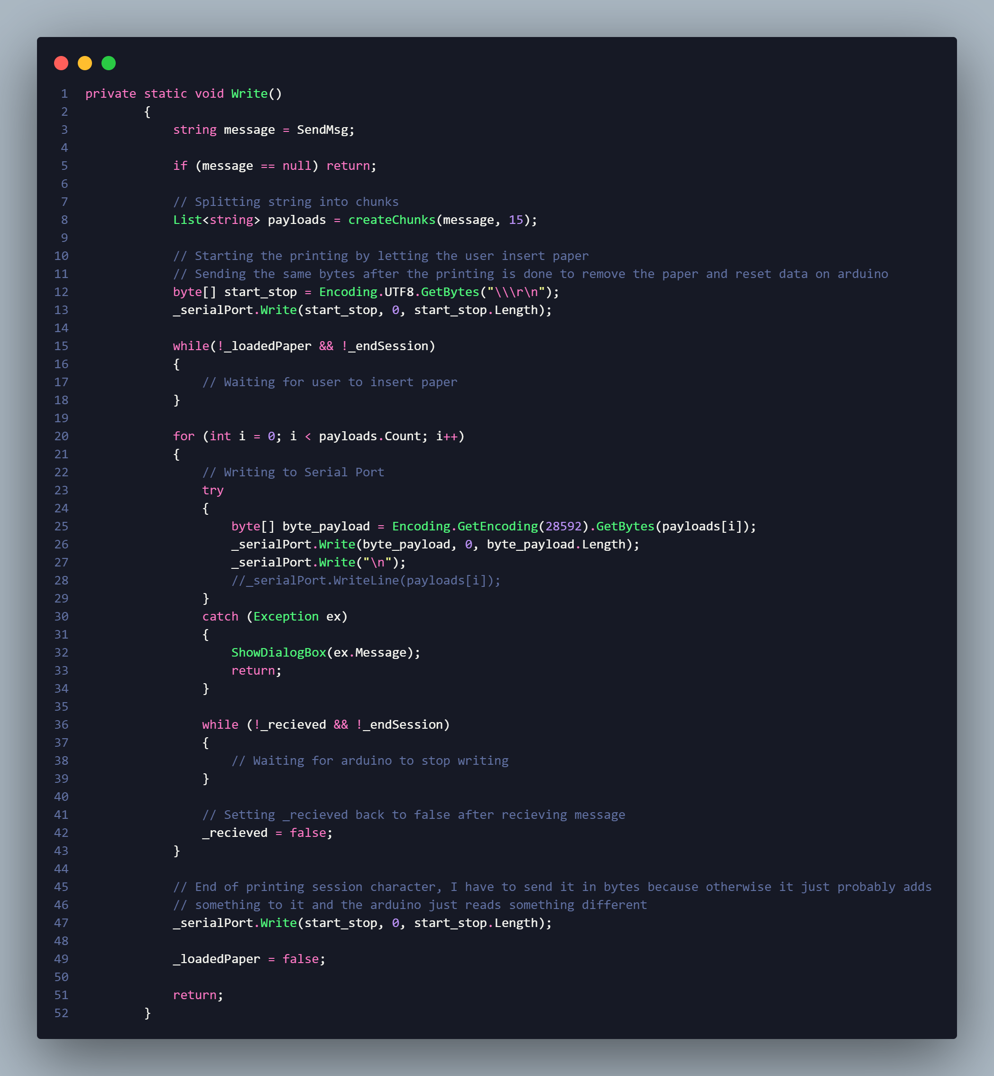
maturity_exam/write_func.png
