CallMeRZIBI/Braille_typwriter_printer/maturity_exam/zapojeni_krok_motoru.jpg

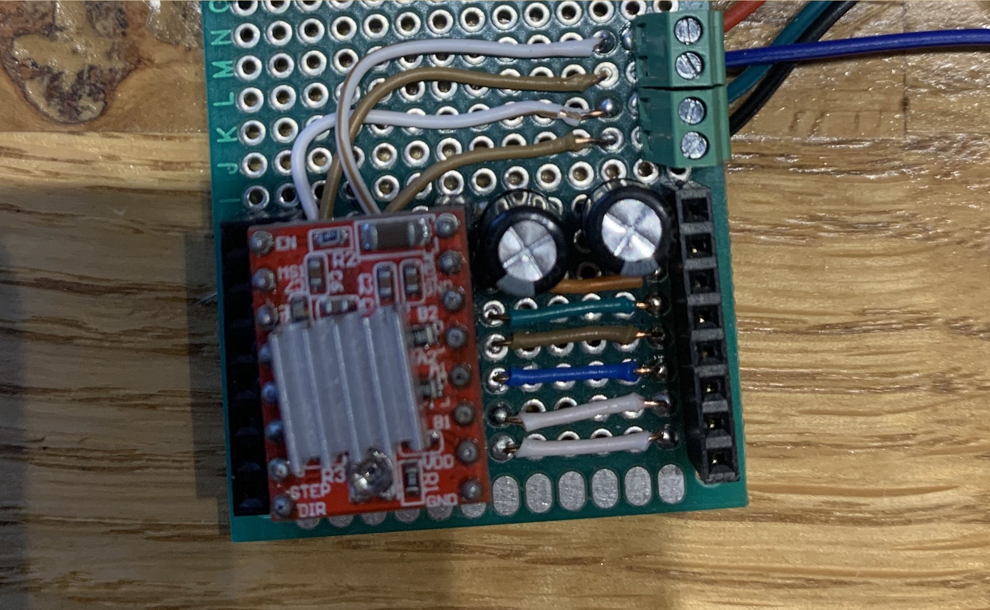
maturity_exam/zapojeni_krok_motoru.jpg
