CallMeRZIBI/Braille_typwriter_printer/maturity_exam/zapojeni_krok_motoru_a_tlacitek.jpg

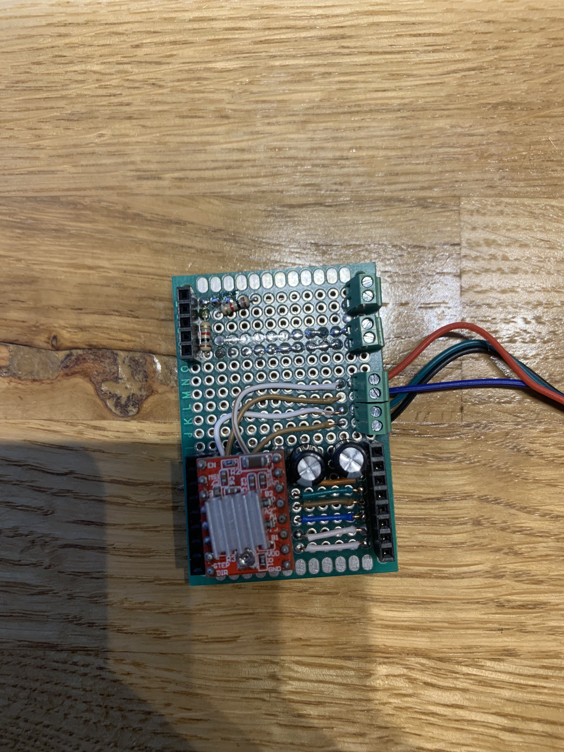
maturity_exam/zapojeni_krok_motoru_a_tlacitek.jpg
