CallMeRZIBI/Braille_typwriter_printer/models/winch/motor force calculation.png

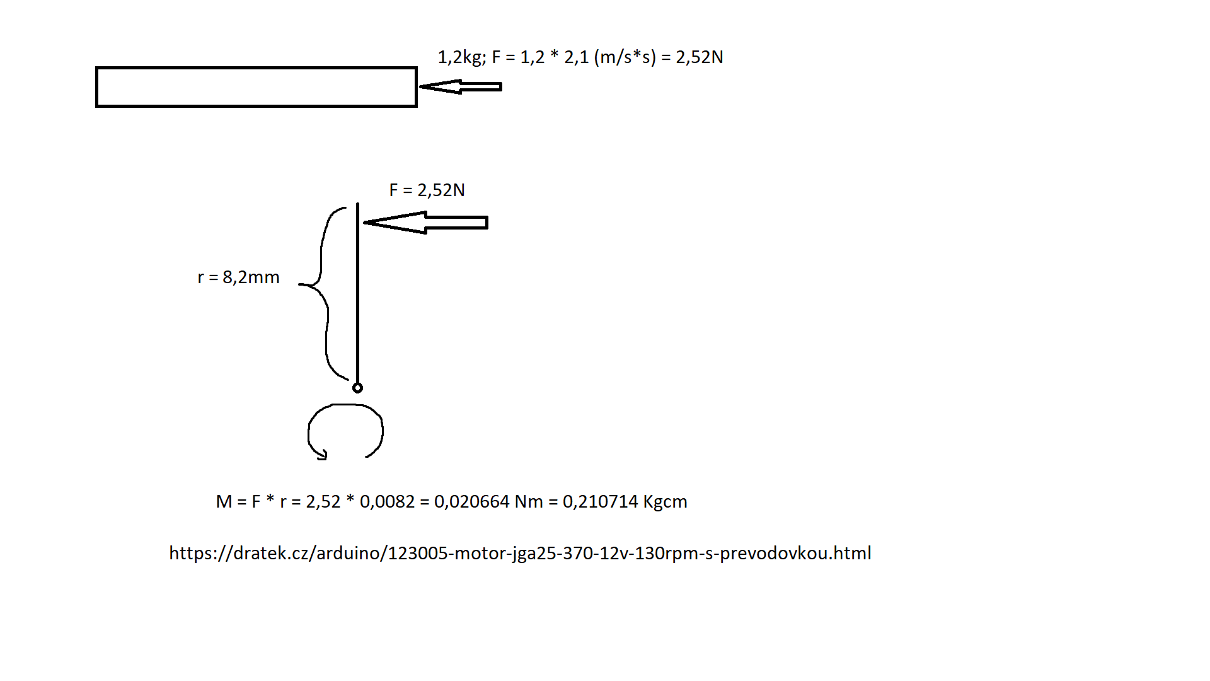
models/winch/motor force calculation.png
