CallMeRZIBI/Braille_typwriter_printer/models/winch/Snímek obrazovky 2023-10-12 114439.png

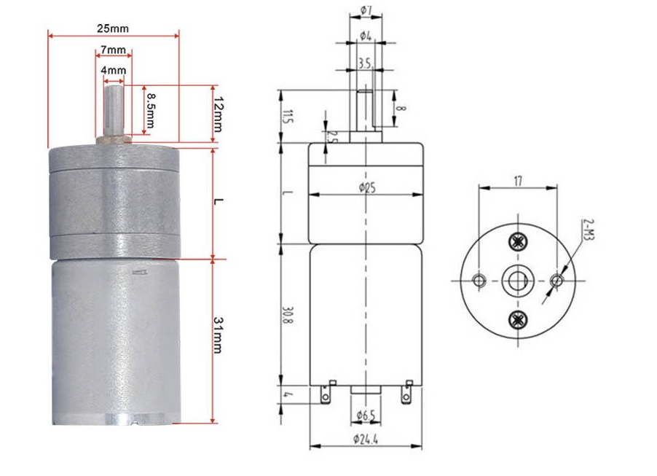
models/winch/Snímek obrazovky 2023-10-12 114439.png
