CallMeRZIBI/Braille_typwriter_printer/models/end_position_button_holder/Sestava1.SLDASM

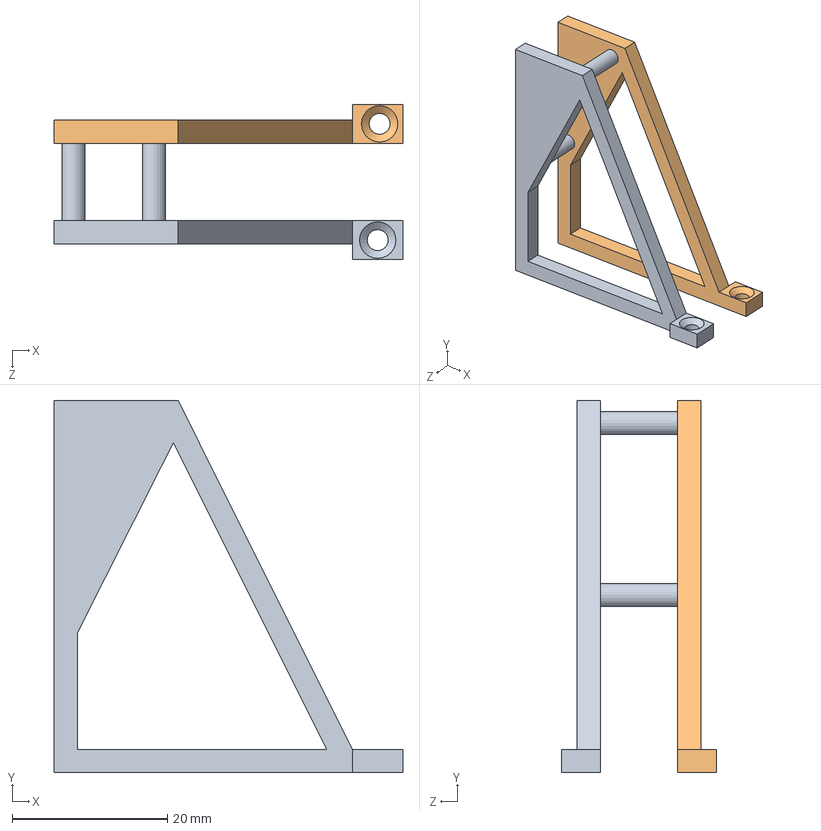
[picture p80: CAD file, 2023-12-14]
models/end_position_button_holder/Sestava1.SLDASM
45.0 x 48.0 x 20.0 mm
holder_base
holder_other_side
