CallMeRZIBI/Braille_typwriter_printer/models/stepper_gearbox/Sestava1.SLDASM

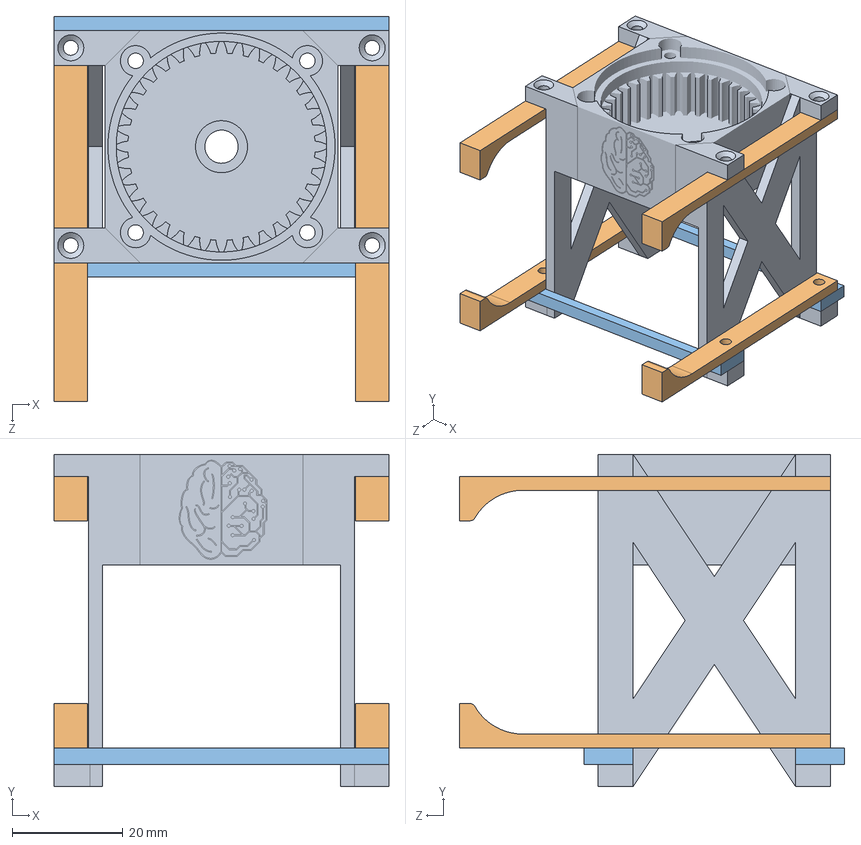
[picture p81: CAD file, 2023-10-07]
models/stepper_gearbox/Sestava1.SLDASM
60.4 x 60.0 x 69.5 mm
Base
leg x 4
support x 2
