CallMeRZIBI/Braille_typwriter_printer/models/winch/Sestava1.SLDASM

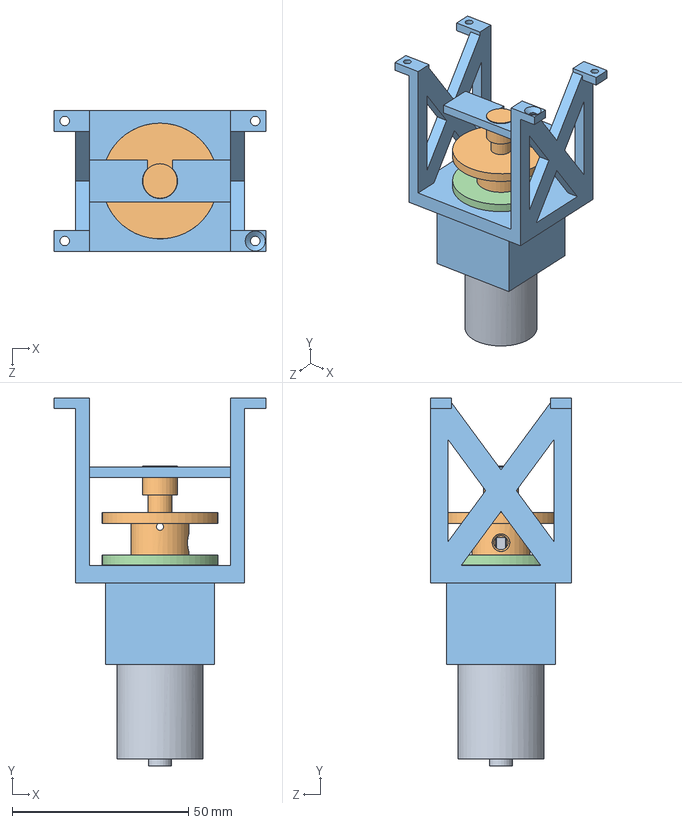
[picture p82: CAD file, 2024-01-18]
models/winch/Sestava1.SLDASM
60.0 x 104.3 x 40.0 mm
motor_with_gearbox
winch
winch_motor_holder
winch_cap
