CallMeRZIBI/Braille_typwriter_printer/models/solenoid_holder/spacer.STEP

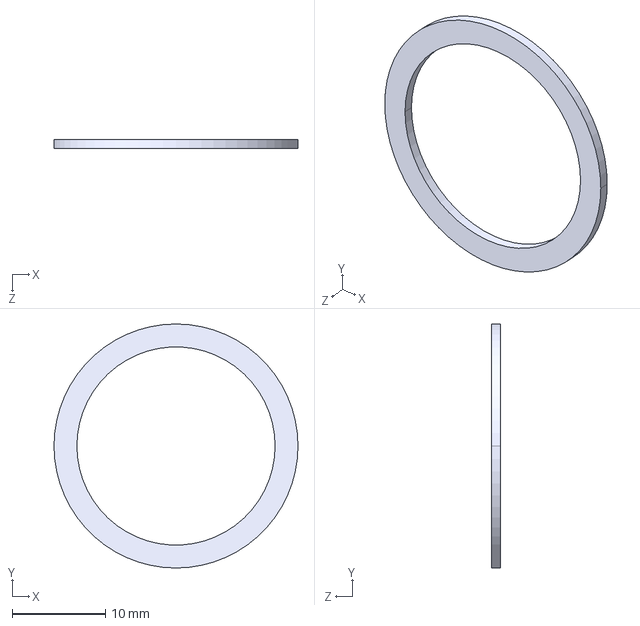
[picture p83: CAD file, 2024-02-22]
models/solenoid_holder/spacer.STEP
26.1 x 26.1 x 1.00 mm
