CallMeRZIBI/Braille_typwriter_printer/models/stepper_gearbox/support.SLDPRT

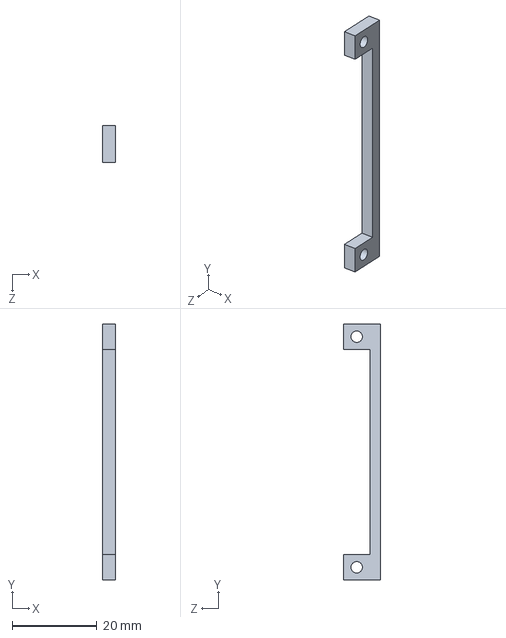
[picture p84: CAD file, 2023-10-07]
models/stepper_gearbox/support.SLDPRT
3.00 x 60.4 x 8.83 mm
