CallMeRZIBI/Braille_typwriter_printer/models/winch/winch_cap.STEP

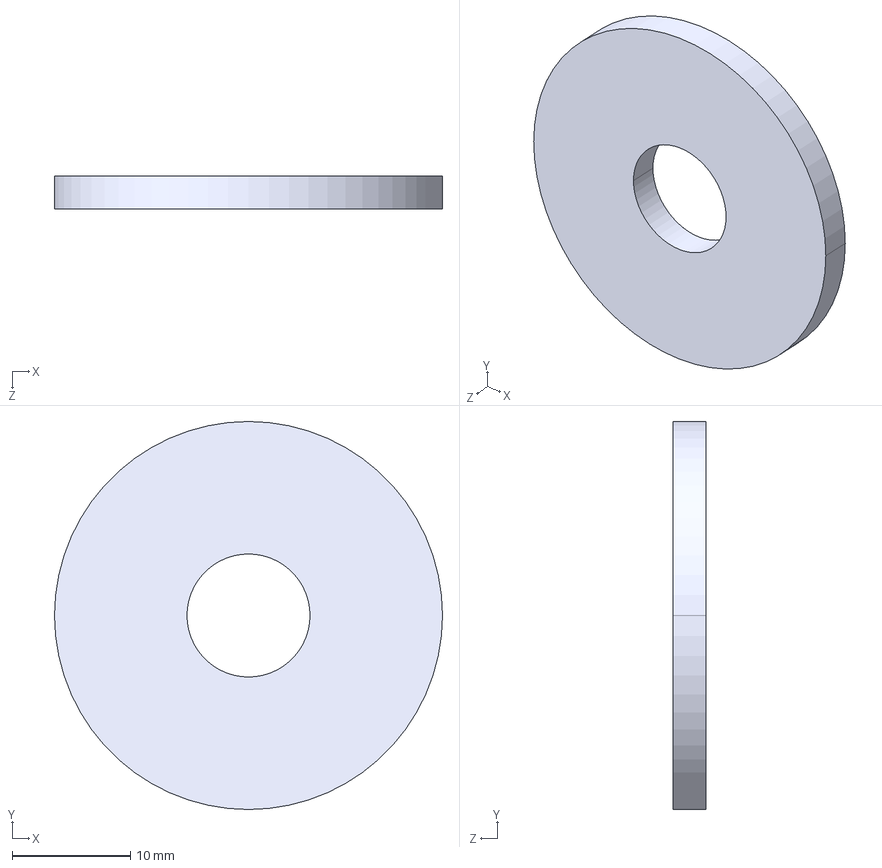
[picture p85: CAD file, 2024-01-18]
models/winch/winch_cap.STEP
32.8 x 32.8 x 2.80 mm
