CallMeRZIBI/Braille_typwriter_printer/models/end_position_button_holder/holder_base.SLDPRT

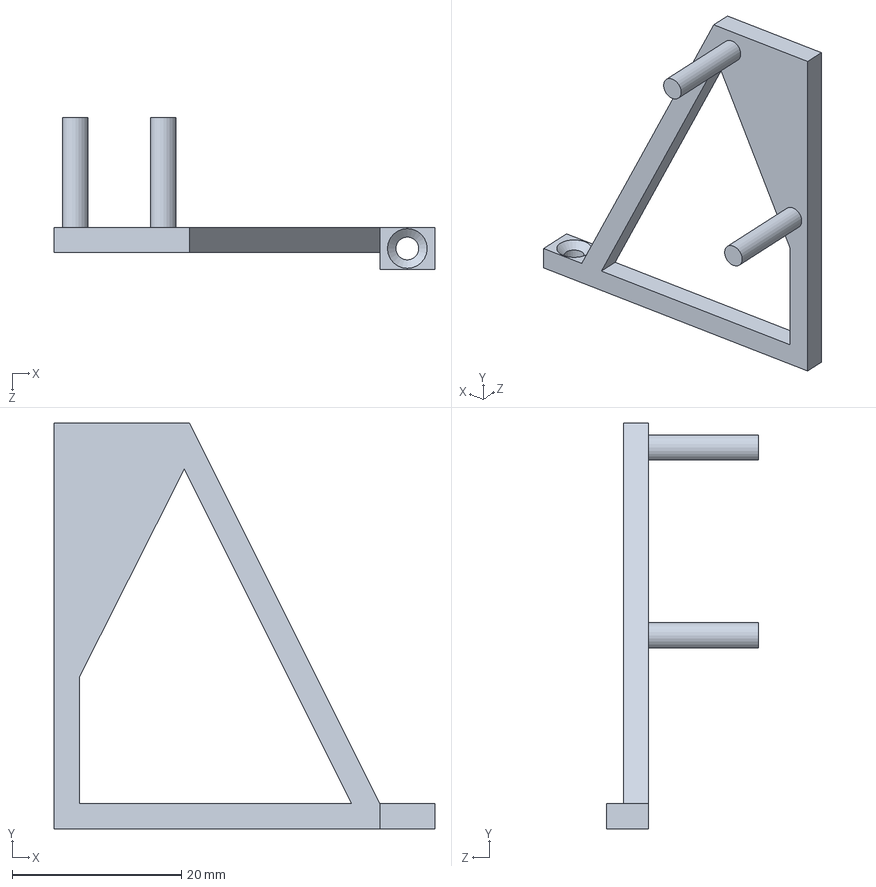
[picture p86: CAD file, 2023-12-10]
models/end_position_button_holder/holder_base.SLDPRT
45.0 x 48.0 x 18.0 mm
