CallMeRZIBI/Braille_typwriter_printer/models/solenoid_holder/solenoid_holder_updated.SLDPRT

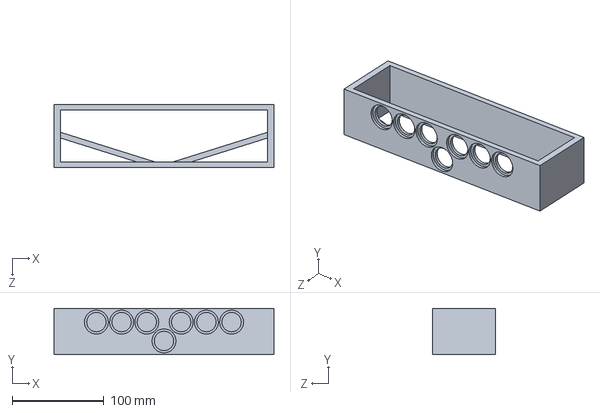
[picture p87: CAD file, 2024-01-18]
models/solenoid_holder/solenoid_holder_updated.SLDPRT
240.0 x 50.7 x 69.0 mm
