CallMeRZIBI/Braille_typwriter_printer/models/end_position_button_holder/holder_other_side.SLDPRT

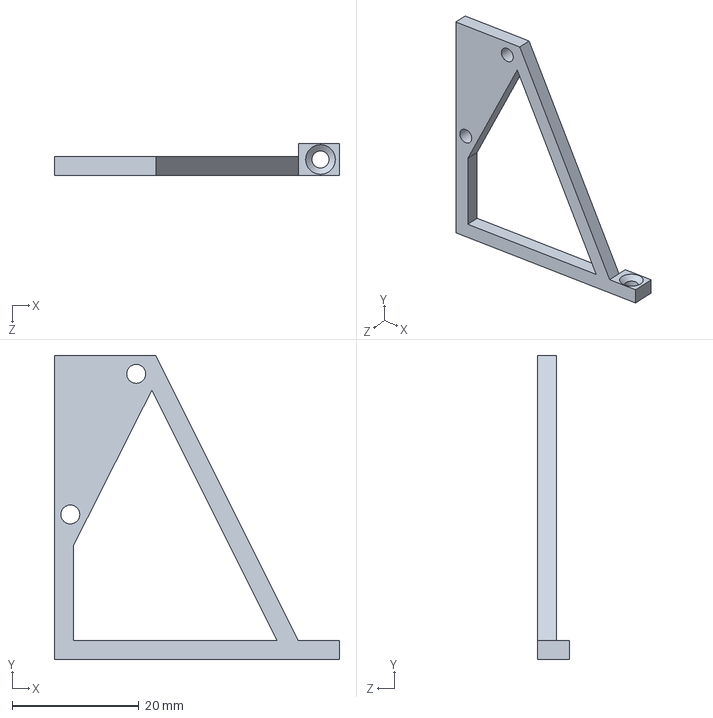
[picture p88: CAD file, 2023-12-10]
models/end_position_button_holder/holder_other_side.SLDPRT
45.0 x 48.0 x 5.00 mm
