CallMeRZIBI/Braille_typwriter_printer/models/solenoid_holder/solenoid_holder.stl

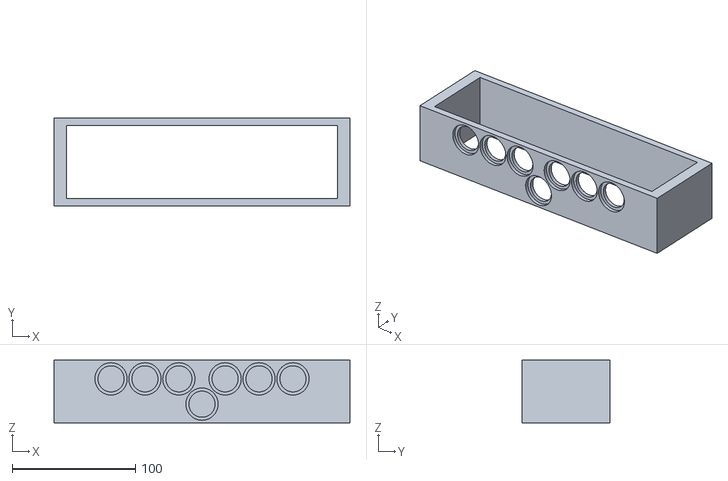
[picture p89: CAD file, 2023-10-08]
models/solenoid_holder/solenoid_holder.stl
240.0 x 71.0 x 50.7
