CallMeRZIBI/Braille_typwriter_printer/models/stepper_gearbox/Base.SLDPRT

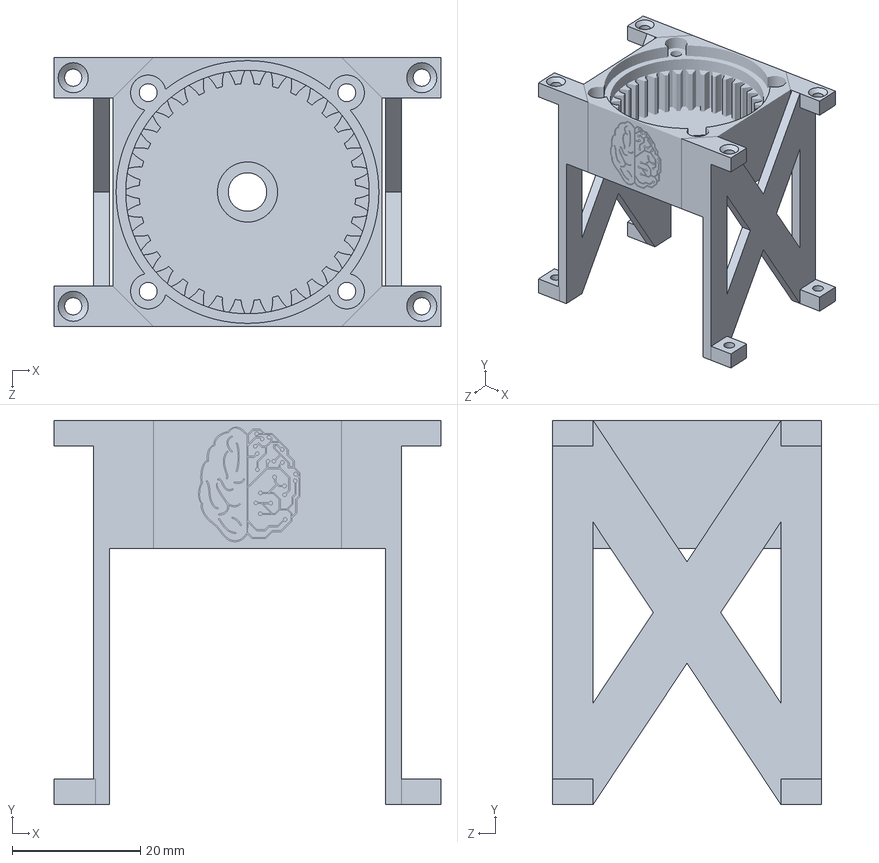
[picture p90: CAD file, 2023-10-07]
models/stepper_gearbox/Base.SLDPRT
60.4 x 60.0 x 42.0 mm
