CallMeRZIBI/Braille_typwriter_printer/models/winch/winch_motor_holder.STEP

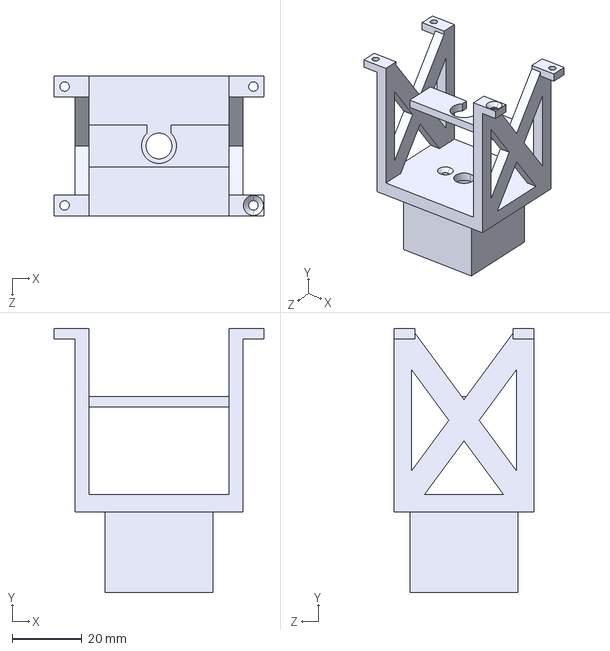
[picture p91: CAD file, 2024-01-18]
models/winch/winch_motor_holder.STEP
60.0 x 75.5 x 40.0 mm
