CallMeRZIBI/Braille_typwriter_printer/models/stepper_gearbox/leg.SLDPRT

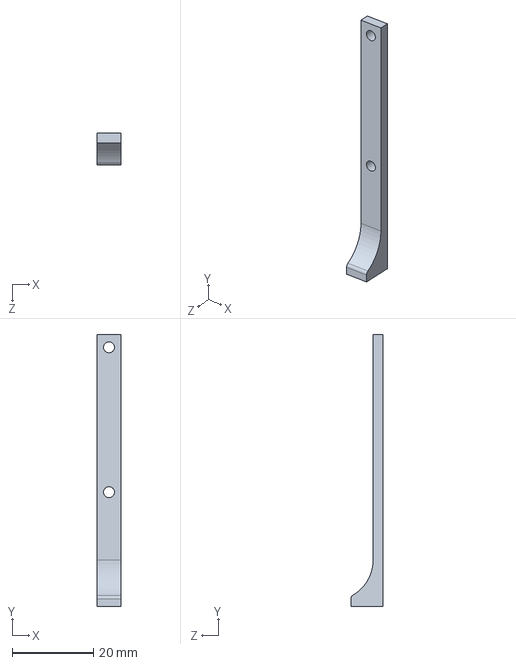
[picture p92: CAD file, 2023-09-30]
models/stepper_gearbox/leg.SLDPRT
6.00 x 67.0 x 8.00 mm
