CallMeRZIBI/Braille_typwriter_printer/models/winch/winch.STEP

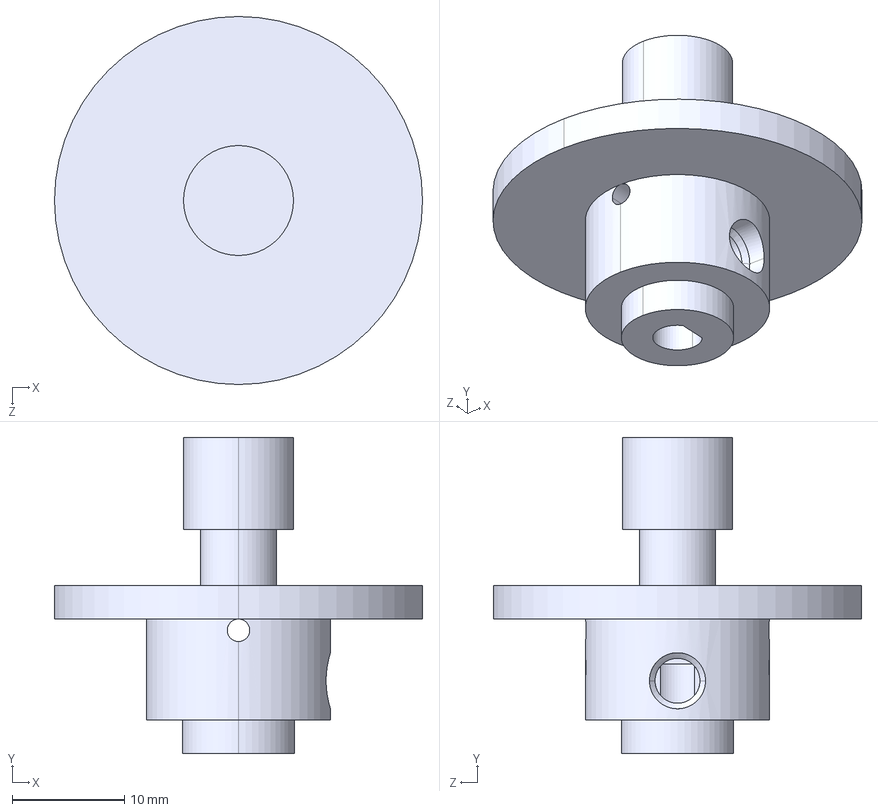
[picture p93: CAD file, 2024-01-18]
models/winch/winch.STEP
32.8 x 28.2 x 32.8 mm
