CallMeRZIBI/Braille_typwriter_printer/models/winch/motor_with_gearbox.SLDPRT

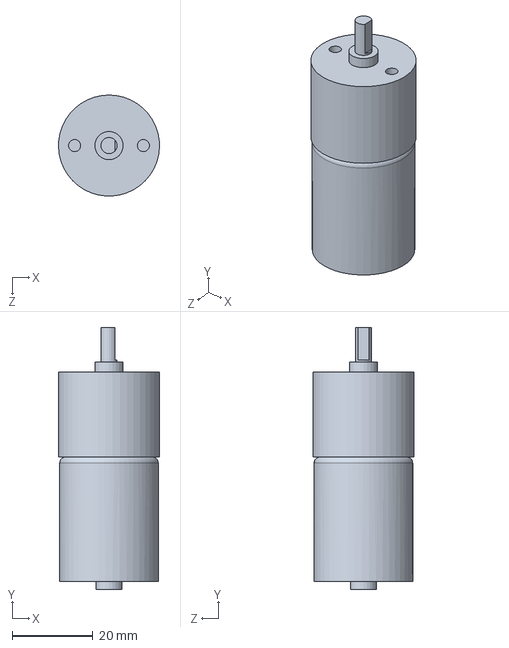
[picture p94: CAD file, 2023-10-12]
models/winch/motor_with_gearbox.SLDPRT
25.0 x 64.8 x 25.0 mm
