CallMeRZIBI/Braille_typwriter_printer/(list of files, cad)

Other CAD files:
models/end_position_button_holder/holder_base.STL
models/end_position_button_holder/holder_other_side.STL
models/solenoid_holder/solenoid_holder_updated.STL
models/solenoid_holder/spacer.SLDPRT
models/stepper_gearbox/Base.stl
models/stepper_gearbox/support.STL
models/winch/winch.SLDPRT
models/winch/winch_cap.SLDPRT
models/winch/winch_motor_holder.SLDPRT
