CallMeRZIBI/Braille_typwriter_printer/maturity_exam/printchar.png

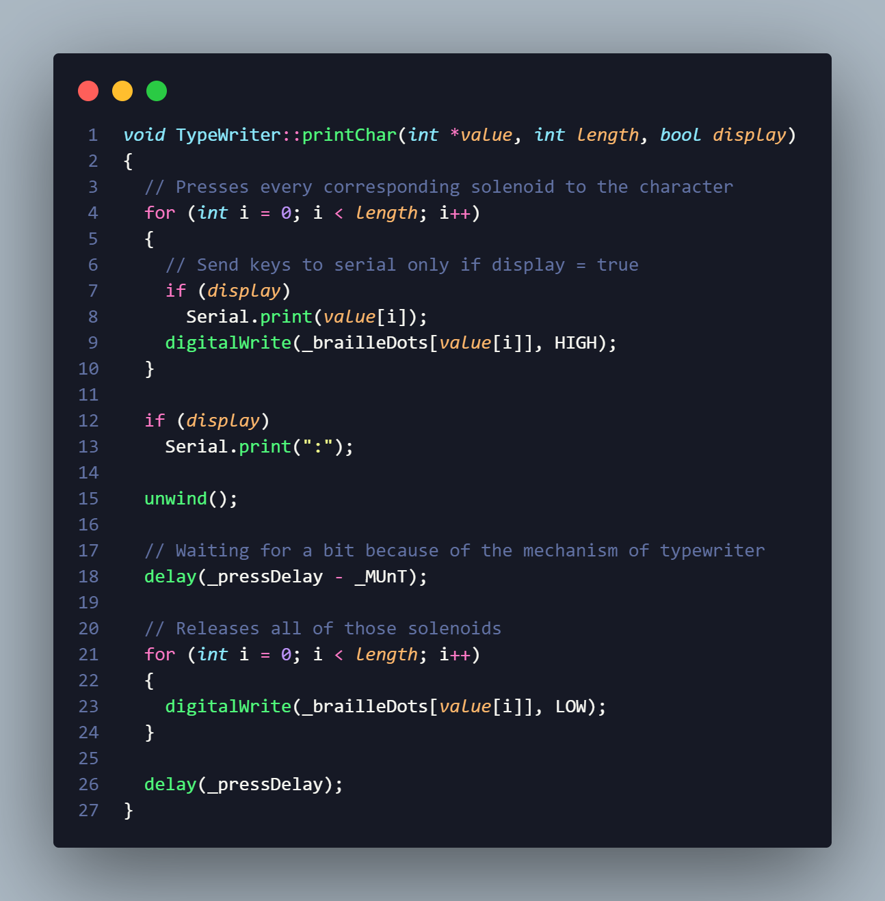
maturity_exam/printchar.png
