CallMeRZIBI/Braille_typwriter_printer/(commit log)

2022-07-24 changed delay cause it was too fast (yay finally tested it on real machine)
    [serial_printer.ino]
2022-08-27 rewritten serial printer to class and changing the way spaces and new lines are handled
2022-08-29 fixed looping through each char of string (me do be dumb when using i and j and incrementing only i and not j)
    [TypeWriter.cpp]
2022-09-03 added control over degrees of rotation of stepper motor
2022-09-11 printing uppercase but now whole uppercase word
2022-09-26 tried fixing problem with all uppercase
    [TypeWriter.cpp]
2022-10-04 fixed the problem with all uppercase word
    [TypeWriter.cpp, serial_printer.ino]
2022-12-13 replaced the manual stepper motor controlling with library
    [TypeWriter.cpp, TypeWriter.h, serial_printer.ino]
2023-01-09 modeled temporary (maybye) gearbox
    [case_closing.SLDPRT, case_main.SLDPRT, gearbox.SLDASM, large_gear.SLDPRT, small_gear.SLDPRT]
2023-01-10 deleted corrupted schematics and added a small mounting for gearbox
    [braille_typewriter.kicad_pcb, braille_typewriter.kicad_sch, case_main.SLDPRT, gearbox.SLDASM]
2023-01-16 changed dimensions of the holes to fit M3 screws and those metal thingies that you put into plastic to hold screw
    [case_closing.SLDPRT, case_main.SLDPRT, gearbox.SLDASM]
2023-09-07 idk what have changed, i havent touched it for almost a year now
    [case_closing.SLDPRT, case_main.SLDPRT, gearbox.SLDASM, large_gear.SLDPRT, small_gear.SLDPRT]
2023-09-14 Fixed problem with initialisation of A4988 library stucking and added better uppercase handling
    [TypeWriter.cpp, TypeWriter.h, serial_printer.ino]
2023-09-14 changed typing space, because I did it wrong before
    [TypeWriter.cpp]
2023-09-20 made printing character a method because it was a mess
2023-09-21 fixed checking if new line is needed
    [TypeWriter.cpp, TypeWriter.h, serial_printer.ino]
2023-09-30 added new gearbox model, and changed some things in code
    [Base.SLDPRT, Base.stl, Sestava1.SLDASM, leg.SLDPRT]
2023-10-07 updated model for stepper motor and added my maturita document
    [Base.SLDPRT, Base.stl, Sestava1.SLDASM, case_closing.SLDPRT, case_main.SLDPRT, gearbox.SLDASM, large_gear.SLDPRT, small_gear.SLDPRT]
2023-10-08 just slight work on maturita document, but I must try harder to write about everything, all the things about MCU, solenoids, transistors, just everything
    [solenoid_holder.stl]
2023-10-12 added winch model and calculations (the're probably wrong), and also added sleeping for A4988 when not in use, but that has some problems
    [Sestava1.SLDASM, motor_with_gearbox.SLDPRT, winch.SLDPRT, winch.STL, winch_motor_holder.SLDPRT, winch_motor_holder.STL]
2023-10-19 added motor movement to the code and button for stopping the motor on end position
    [winch.STL]
2023-10-19 writing theoretical part of maturity
    [winch.SLDPRT, winch.STL]
2023-10-24 the gearbox ratio is 4:1 so I changed 2,8 to 4
2023-11-10 started writing about solenoids
2023-11-11 hopefully completed solenoid section
2023-11-12 trying to figure out the problem with passing and working with longer strings
    [TypeWriter.cpp, TypeWriter.h]
2023-11-16 changed the serial frontend to windows forms application, it has a lot of bugs but I'll fix it, TODO: rewrite arduino code so it remembers where it ended the printing process, and will continue with 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
2023-11-17 fixed ending of print session (I had problem with adding so there probably will be 3 commits)
2023-11-26 added returning of the carriage using motor
2023-11-29 updated the winch, to secure it by screw
    [Sestava1.SLDASM, winch.SLDPRT, winch.STL, winch_cap.SLDPRT, winch_cap.STL]
2023-12-10 minor changes in winch model
    [Sestava1 - winch-1.STL, Sestava1 - winch_cap-1.STL, Sestava1 - winch_motor_holder-1.STL, Sestava1.SLDASM, holder_base.SLDPRT, holder_base.STL, holder_other_side.SLDPRT, holder_other_side.STL]
2023-12-14 working on maturita exam document
    [Sestava1 - winch-1.STL, Sestava1.SLDASM, winch.SLDPRT, winch.STL]
2023-12-23 added unwinding of the winch before first letter print after new line
2023-12-25 changed the way of ending print
2024-01-08 changes on the model and test function of the typewriter that helped me to resolve problem with some solenoids force
    [solenoid_holder.stl, solenoid_holder_updated.SLDPRT, solenoid_holder_updated.STL]
2024-01-18 updated the winch model, fixed splitting into chunks in frontend, added new line support in input text
    [Sestava1 - winch_cap-1.STL, Sestava1 - winch_motor_holder-1.STL, Sestava1.SLDASM, solenoid_holder_updated.SLDPRT, solenoid_holder_updated.STL, winch.SLDPRT, winch.STEP, winch.STL]
2024-01-18 added splitting one long word into chunks and also added multiple paper support by waiting for the user to insert new and then just continuing printing
2024-02-04 fixing problem with sending special characters over serial port
    [TypeWriter.cpp, serial_printer.ino]
2024-02-08 fixed transferring special characters over serial port
    [TypeWriter.h, serial_printer.ino]
2024-02-09 added initial from printer to insert paper at the start of the print
2024-02-22 added spacers for solenoid holders
    [spacer.SLDPRT, spacer.STEP]
